shreyaspatel3010/aries/assets/terrain-source/IMG_20250616_193405.png

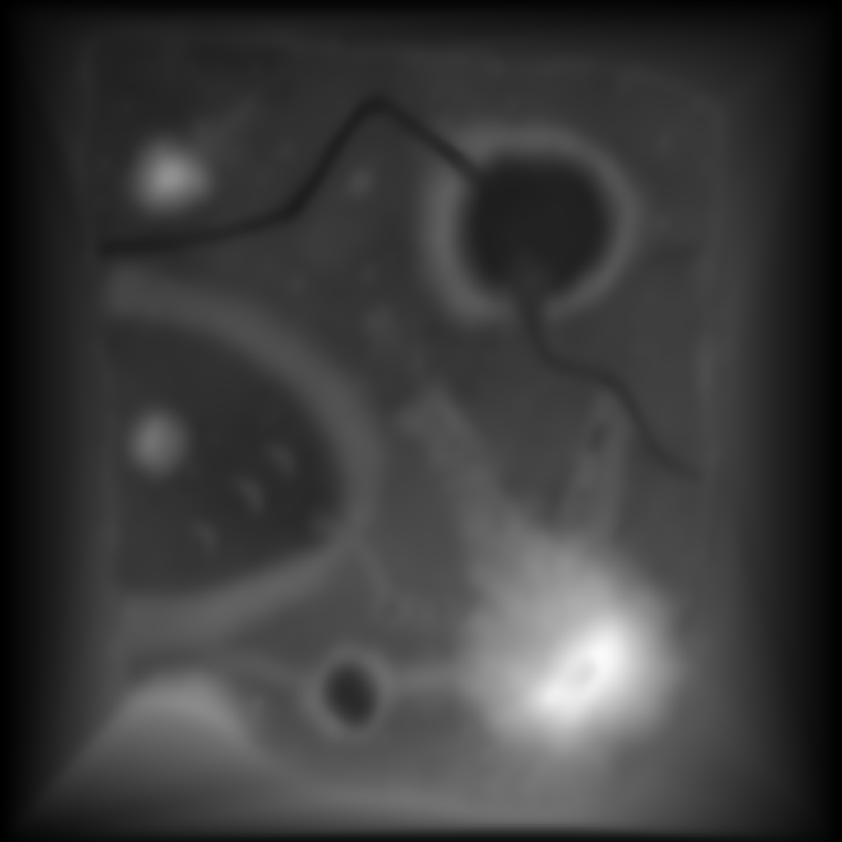
assets/terrain-source/IMG_20250616_193405.png
