shreyaspatel3010/aries/WhatsApp Image 2026-08-18 at 4.04.01 PM.jpeg

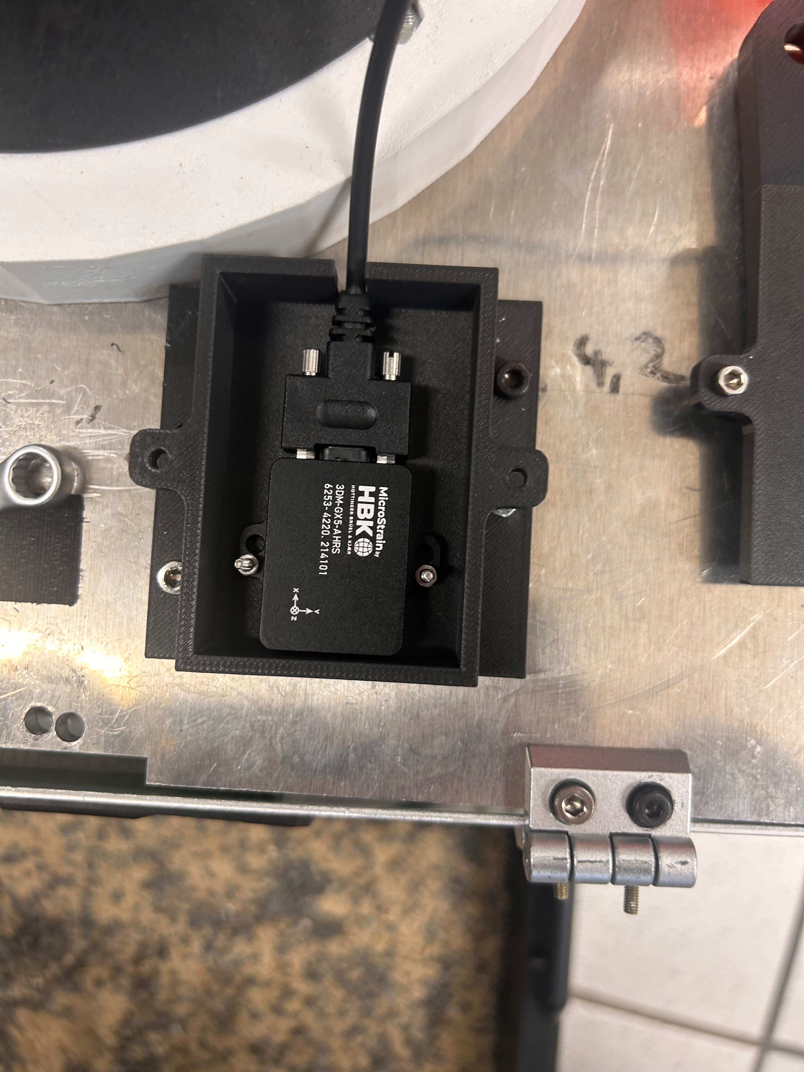
WhatsApp Image 2026-08-18 at 4.04.01 PM.jpeg
