shreyaspatel3010/aries/src/rover_nav/README.md

# rover_nav

ROS 2 navigation and drive-control package for the rover.

> **New machine setup and bringup instructions are in the [`rover_bringup`](../rover_bringup/README.md) package.**

---

## Package structure

```
rover_nav/
├── config/
│   └── ekf_config.yaml                  # EKF localisation config
├── launch/
│   └── LeapOne_Safety_launch.py
├── msg/                                 # Custom ROS 2 message definitions
├── scripts/
│   ├── Rover_control_Joy.py             # Joystick teleop control node
│   ├── Odom.py                          # Odometry node
│   ├── rover_controller_pure_pursuit.py # Pure-pursuit path controller
│   └── setup_can_sudo.sh                # One-time passwordless CAN sudoers setup
└── package.xml
```

---

## Dependencies

- ODrive ROS 2 driver
- `rover_bringup` — provides `joystick_config.yaml` read by `Rover_control_Joy.py`
