shreyaspatel3010/aries/assets/terrain-source/MarsYard_CoordSys.png

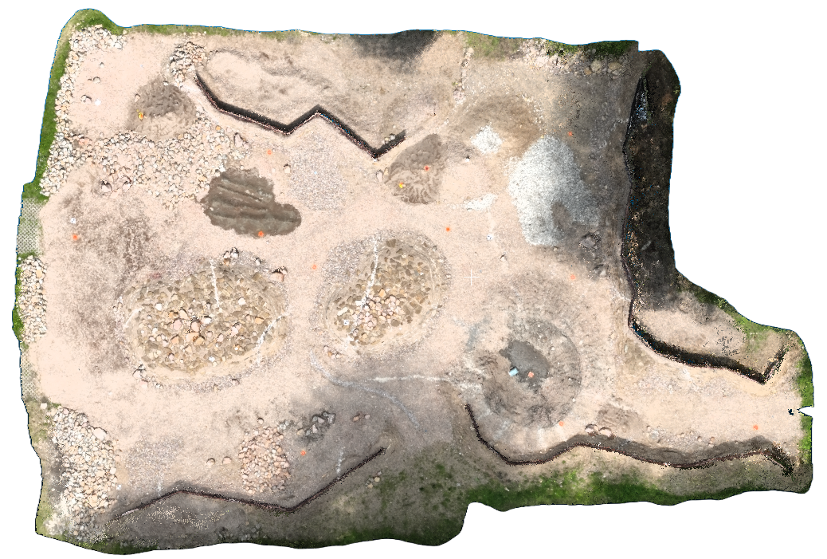
assets/terrain-source/MarsYard_CoordSys.png
