shreyaspatel3010/aries/controller.webp

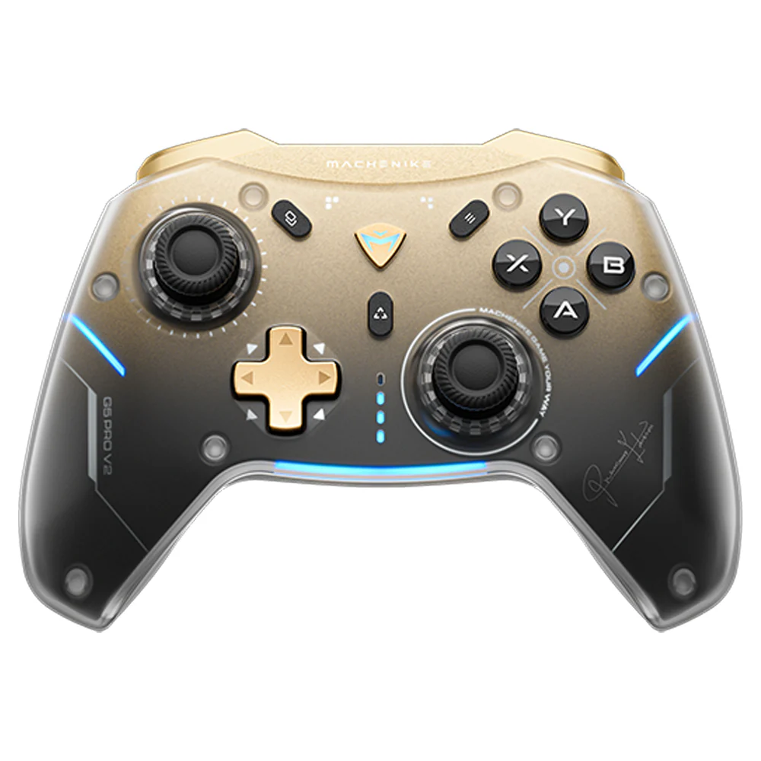
controller.webp
