shreyaspatel3010/aries/src/aries/models/dem/marsyard2026_terrain_hm.png

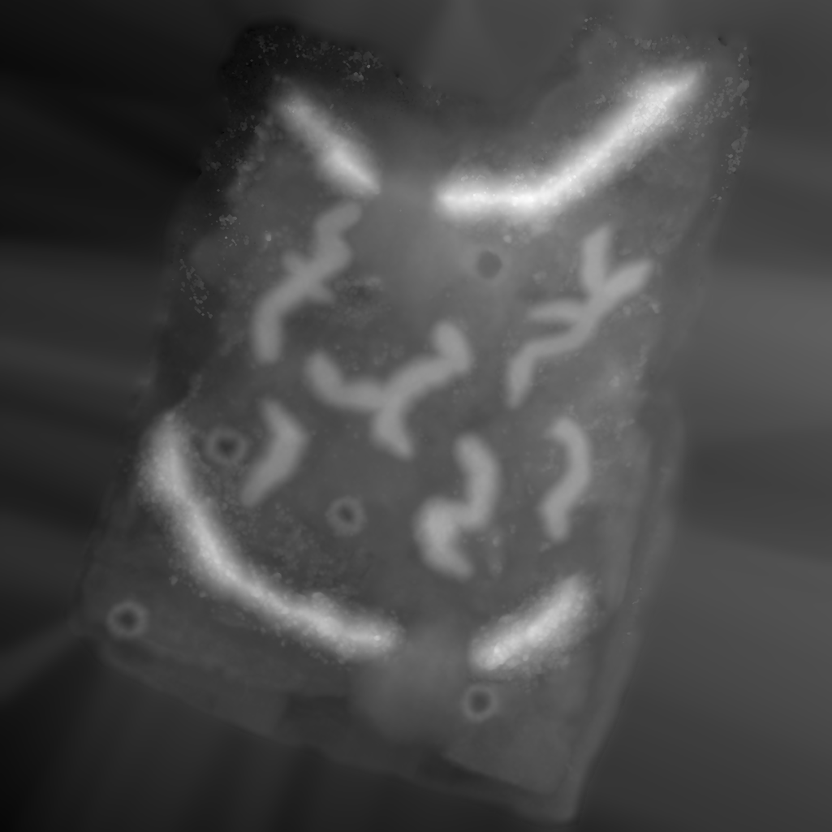
src/aries/models/dem/marsyard2026_terrain_hm.png
