shreyaspatel3010/aries/src/aries/models/marsyard2026/aruco_orig_102.png

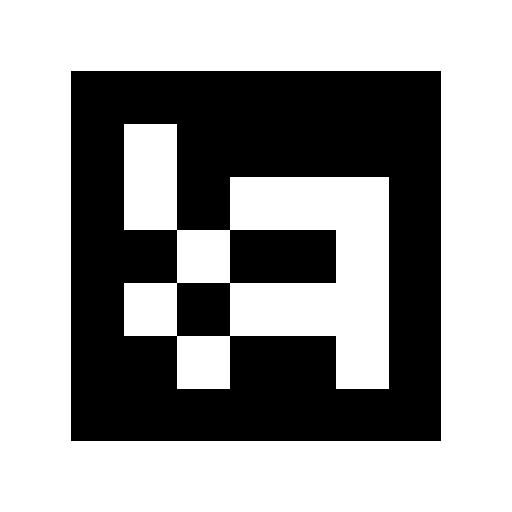
src/aries/models/marsyard2026/aruco_orig_102.png
