shreyaspatel3010/aries/src/aries/models/marsyard2026/drone_cage_floor.png

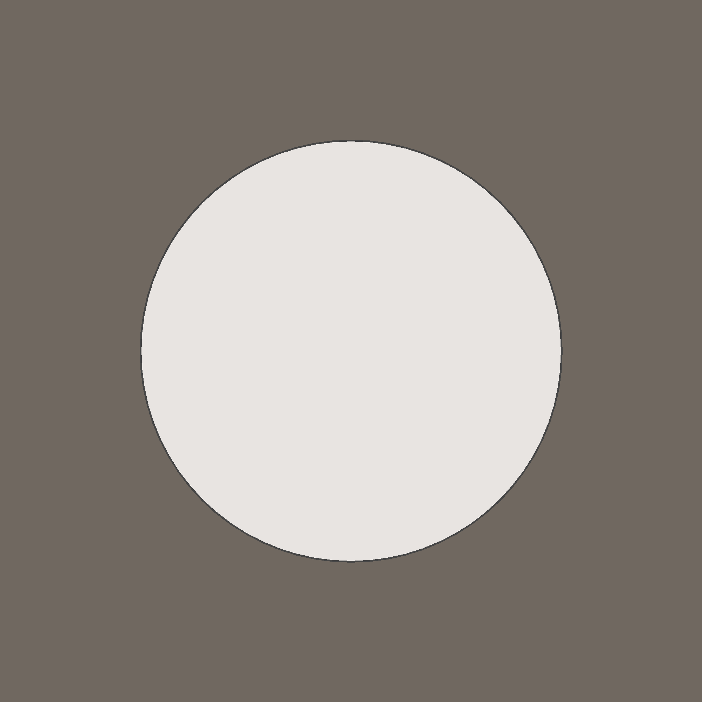
src/aries/models/marsyard2026/drone_cage_floor.png
