shreyaspatel3010/aries/src/aries/models/marsyard2026/landmark_L7.png

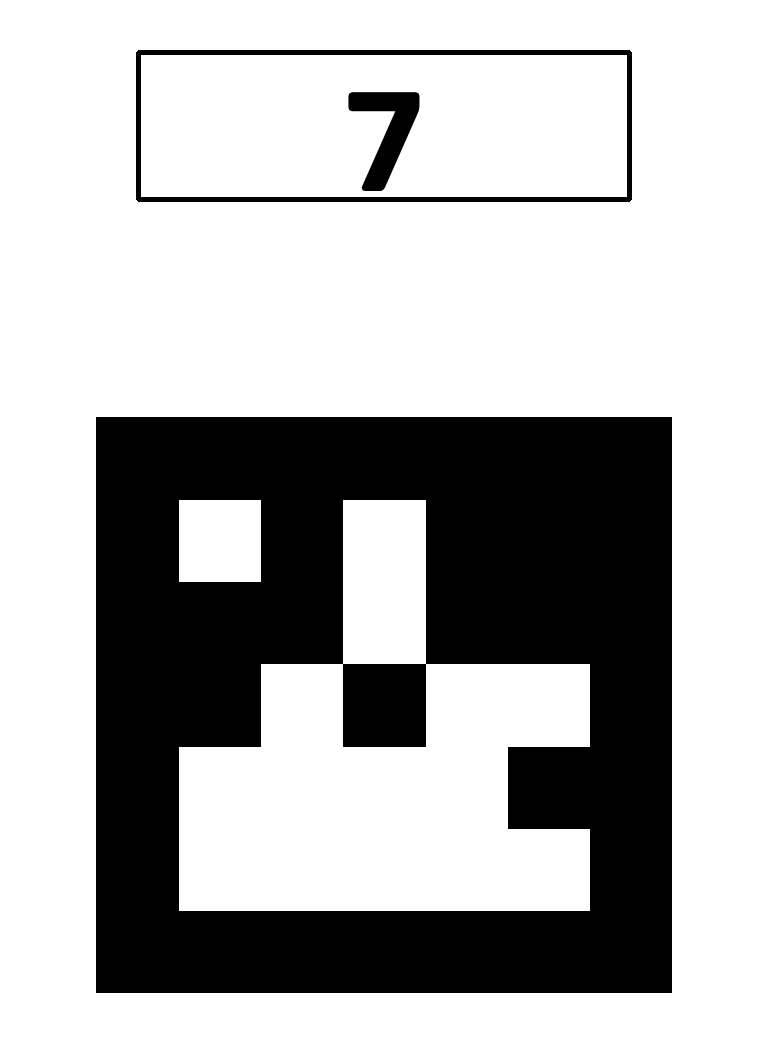
src/aries/models/marsyard2026/landmark_L7.png
