shreyaspatel3010/aries/Maintenance Gripper Finger L.stl

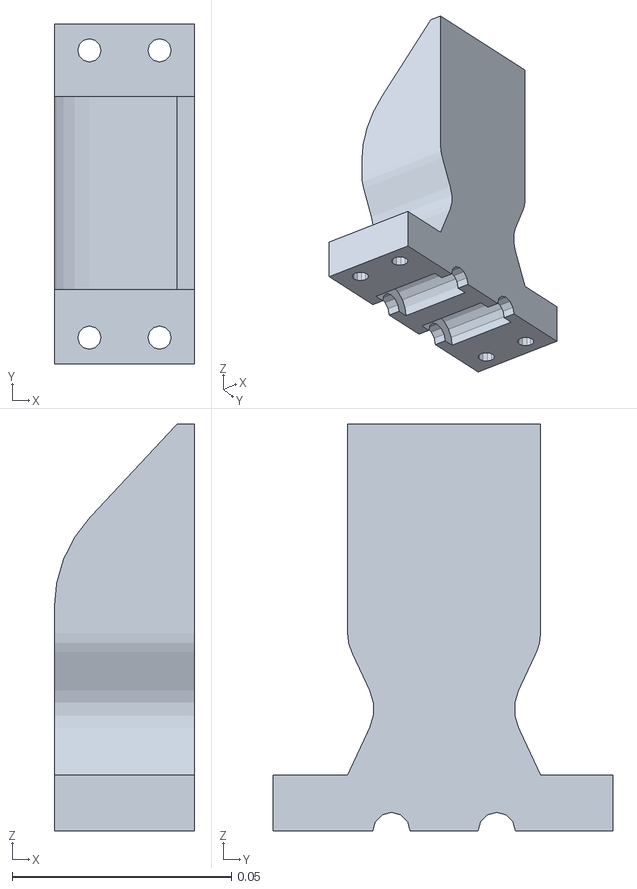
[picture p28: CAD file, 2026-08-31]
Maintenance Gripper Finger L.stl
0.032 x 0.0775 x 0.0928
