shreyaspatel3010/aries/src/aries/meshes/gripper_v2/gripper_maintenance_left.stl

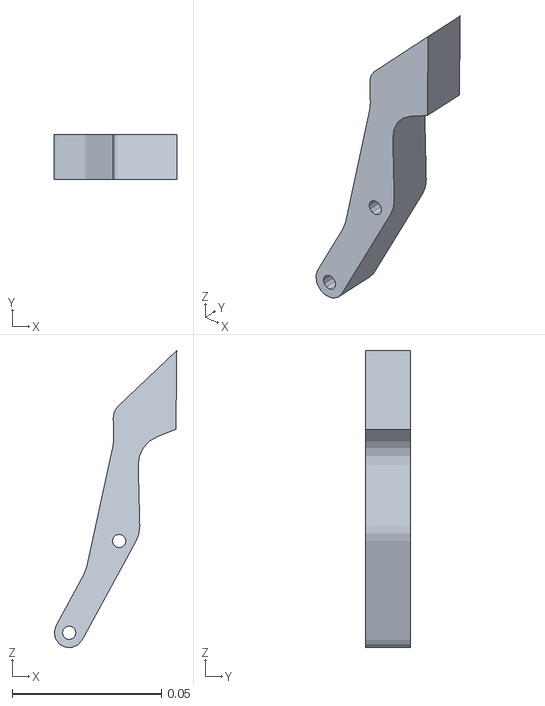
[picture p29: CAD file, 2026-08-11]
src/aries/meshes/gripper_v2/gripper_maintenance_left.stl
0.041 x 0.015 x 0.0994
