shreyaspatel3010/aries/assets/mesh-alternatives/robolink_rebel2/simplified_link5.stl

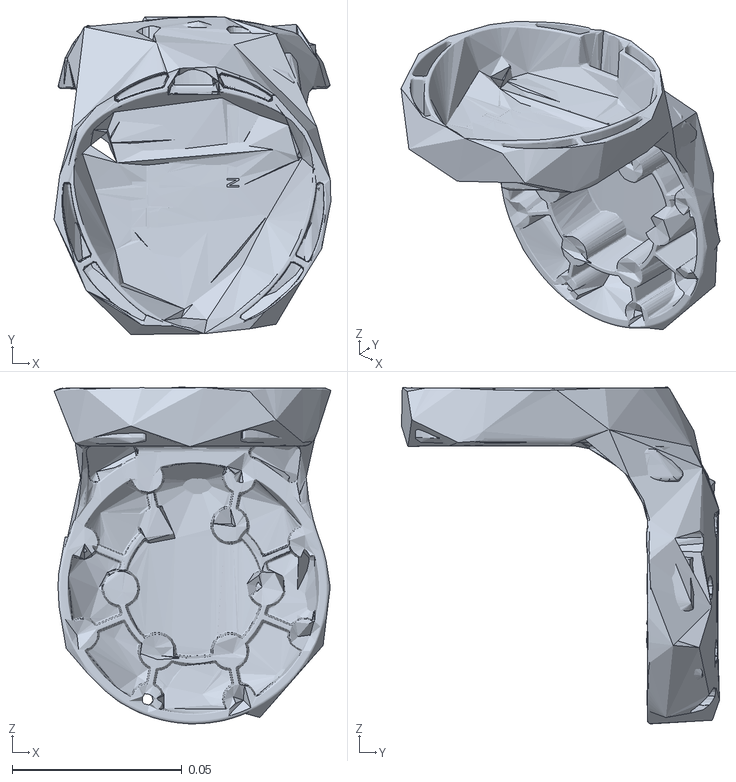
[picture p30: CAD file, 2026-07-12]
assets/mesh-alternatives/robolink_rebel2/simplified_link5.stl
0.0816 x 0.0938 x 0.0993
