shreyaspatel3010/aries/new_mesh/bucket gripper 2.3MF

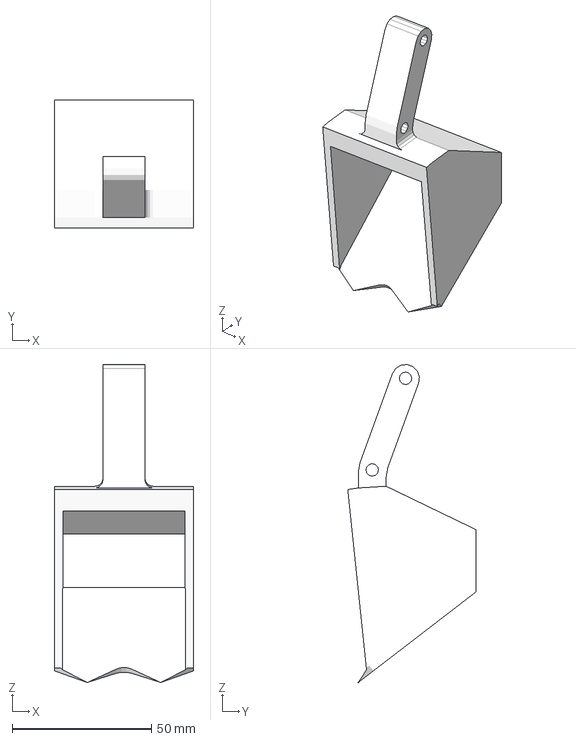
[picture p31: CAD file, 2026-08-20]
new_mesh/bucket gripper 2.3MF
50.0 x 46.1 x 114.2 mm
