shreyaspatel3010/aries/src/aries/meshes/drill_body.stl

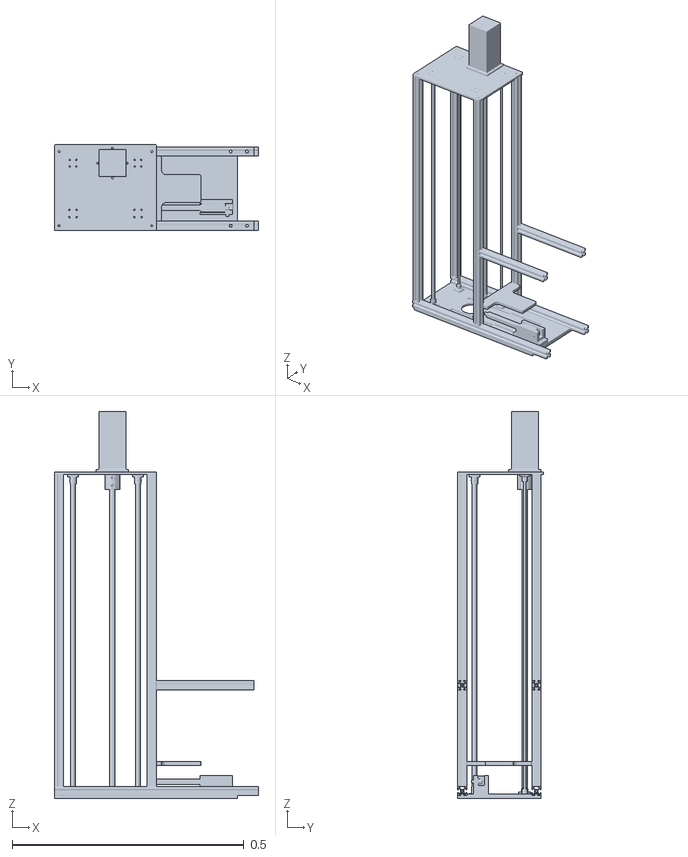
[picture p32: CAD file, 2026-08-20]
src/aries/meshes/drill_body.stl
0.44 x 0.185 x 0.835
