shreyaspatel3010/aries/src/aries/meshes/gripper_v2/gripper_bucket_right.stl

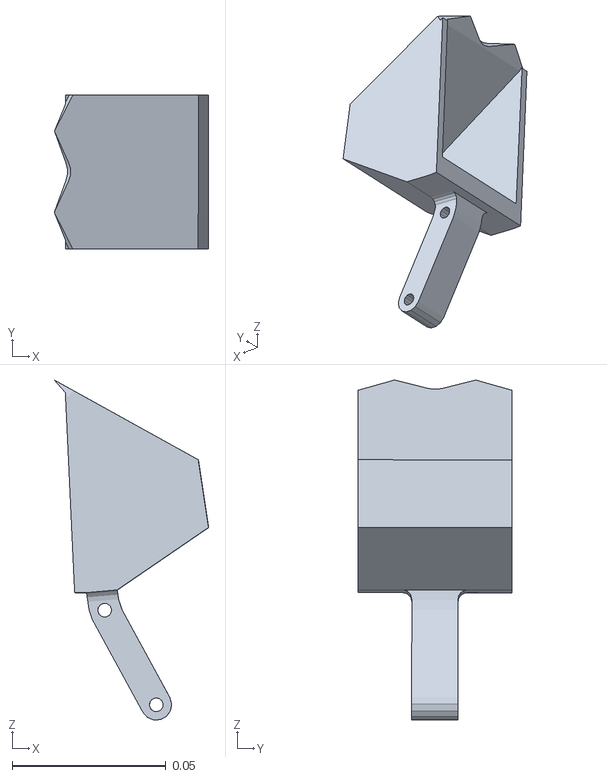
[picture p33: CAD file, 2026-08-20]
src/aries/meshes/gripper_v2/gripper_bucket_right.stl
0.0502 x 0.0501 x 0.11
