shreyaspatel3010/aries/src/aries/meshes/robolink_rebel2/motor1.stl

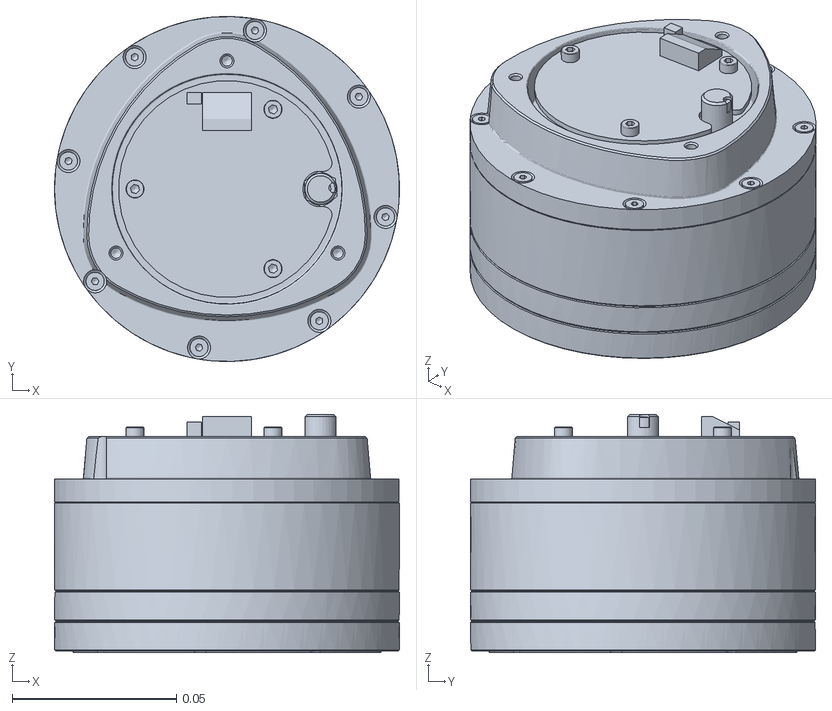
[picture p34: CAD file, 2026-07-12]
src/aries/meshes/robolink_rebel2/motor1.stl
0.105 x 0.105 x 0.0726
