shreyaspatel3010/aries/src/aries/models/maintenance_panel/parts/disconnect.stl

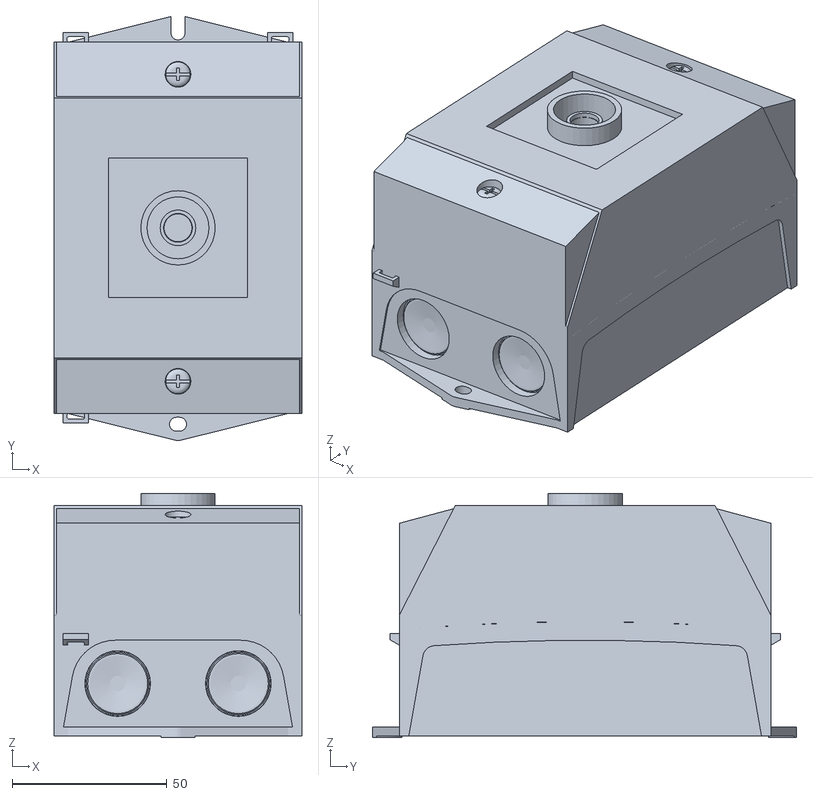
[picture p35: CAD file, 2026-08-17]
src/aries/models/maintenance_panel/parts/disconnect.stl
80.0 x 137.0 x 79.0
