shreyaspatel3010/aries/src/aries/models/probe.stl

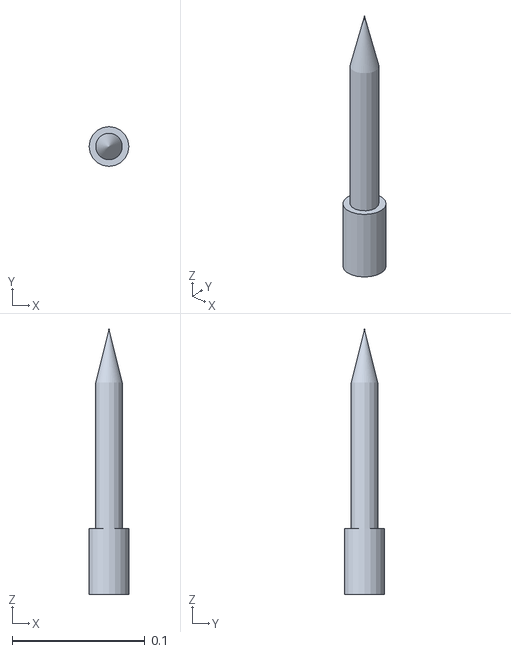
[picture p36: CAD file, 2026-07-20]
src/aries/models/probe.stl
0.03 x 0.03 x 0.2
