shreyaspatel3010/aries/assets/mesh-alternatives/robolink_rebel2/simplified_motor5.stl

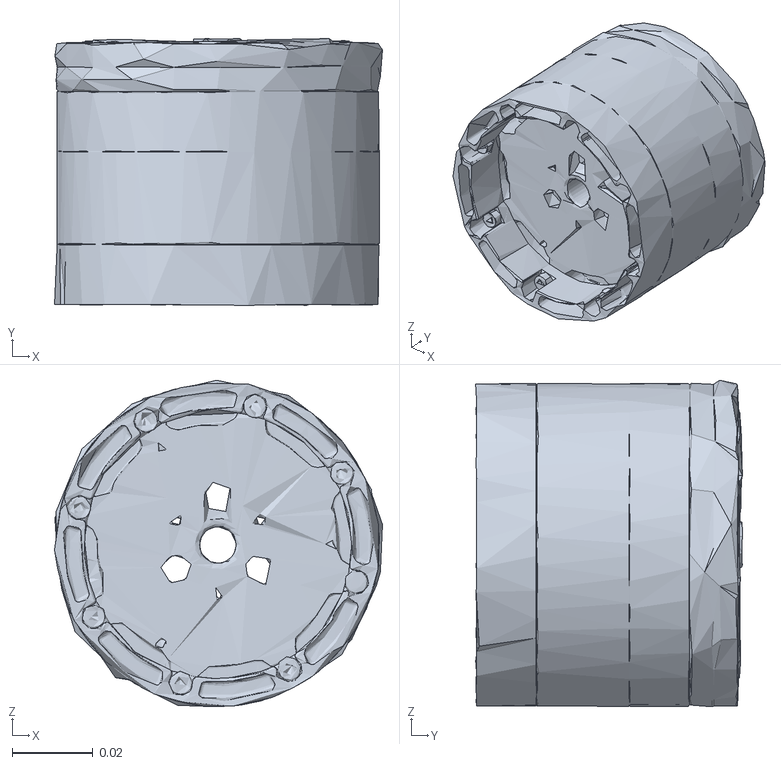
[picture p37: CAD file, 2026-07-12]
assets/mesh-alternatives/robolink_rebel2/simplified_motor5.stl
0.0813 x 0.0662 x 0.0809
