shreyaspatel3010/aries/src/aries/meshes/drill_motor.stl

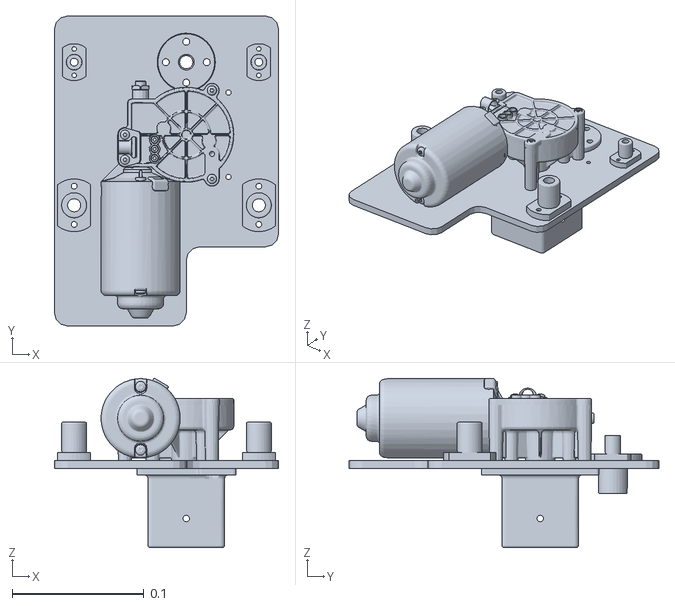
[picture p38: CAD file, 2026-08-20]
src/aries/meshes/drill_motor.stl
0.17 x 0.235 x 0.128
