shreyaspatel3010/aries/src/aries/meshes/robolink_rebel2/link6.stl

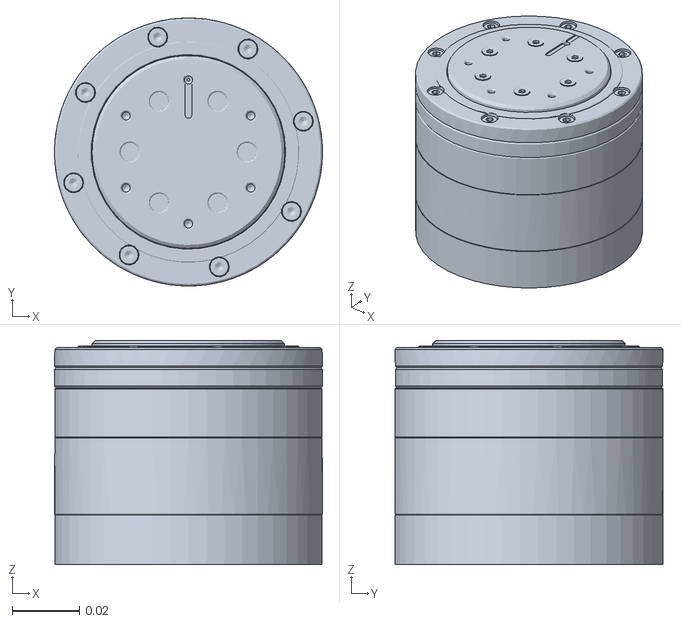
[picture p39: CAD file, 2026-07-12]
src/aries/meshes/robolink_rebel2/link6.stl
0.08 x 0.08 x 0.067
