shreyaspatel3010/aries/src/aries/models/maintenance_panel/parts/mcb_block4.stl

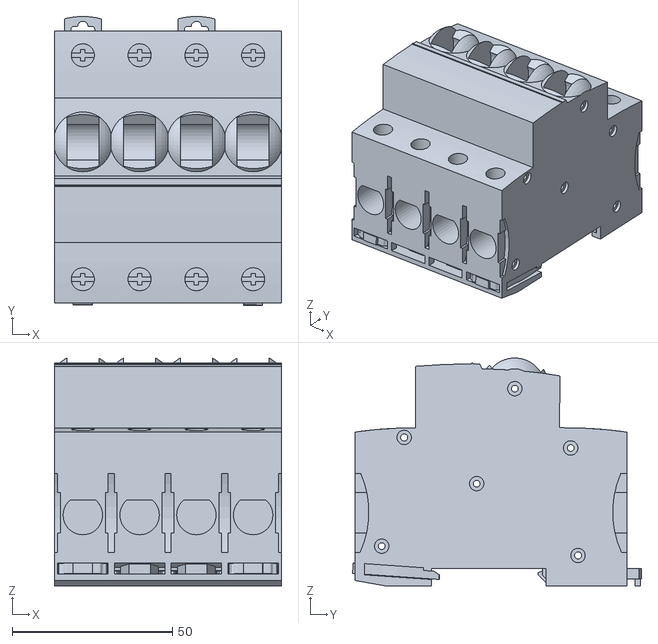
[picture p40: CAD file, 2026-08-17]
src/aries/models/maintenance_panel/parts/mcb_block4.stl
70.8 x 90.1 x 71.1
