shreyaspatel3010/aries/assets/mesh-alternatives/robolink_rebel2/simplified_link3.stl

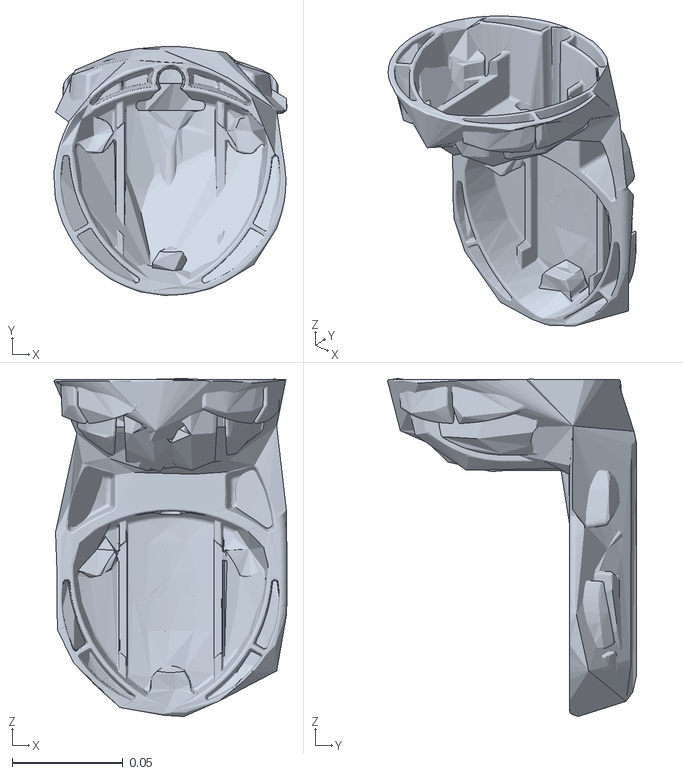
[picture p41: CAD file, 2026-07-12]
assets/mesh-alternatives/robolink_rebel2/simplified_link3.stl
0.105 x 0.112 x 0.152
