shreyaspatel3010/aries/new_mesh/gripper_bucket_2.stl

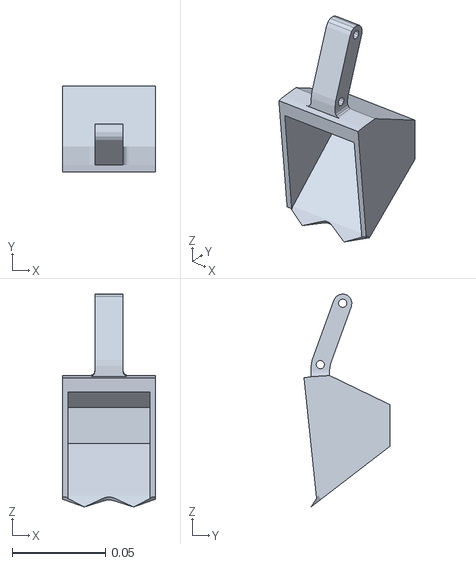
[picture p42: CAD file, 2026-08-20]
new_mesh/gripper_bucket_2.stl
0.05 x 0.0461 x 0.114
