shreyaspatel3010/aries/src/aries/meshes/drill_container.stl

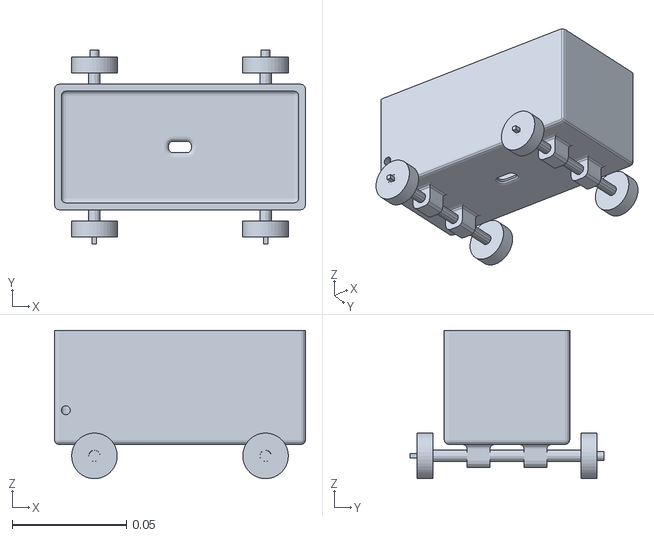
[picture p43: CAD file, 2026-08-20]
src/aries/meshes/drill_container.stl
0.11 x 0.085 x 0.065
