shreyaspatel3010/aries/src/aries/meshes/gripper_st3215/st3215_bucket_right.stl

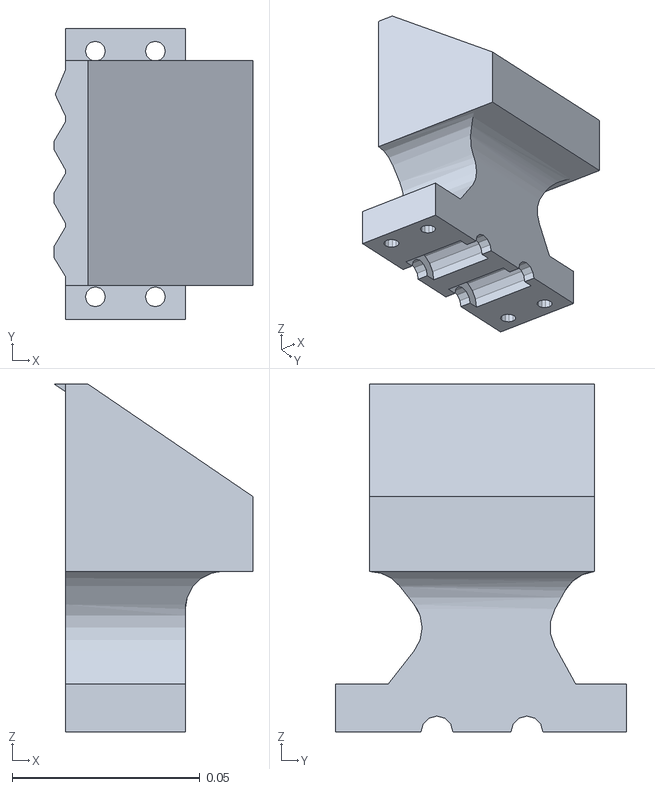
[picture p44: CAD file, 2026-08-29]
src/aries/meshes/gripper_st3215/st3215_bucket_right.stl
0.053 x 0.0775 x 0.0928
