shreyaspatel3010/aries/src/aries/meshes/gripper_v2/gripper_coupler_right.stl

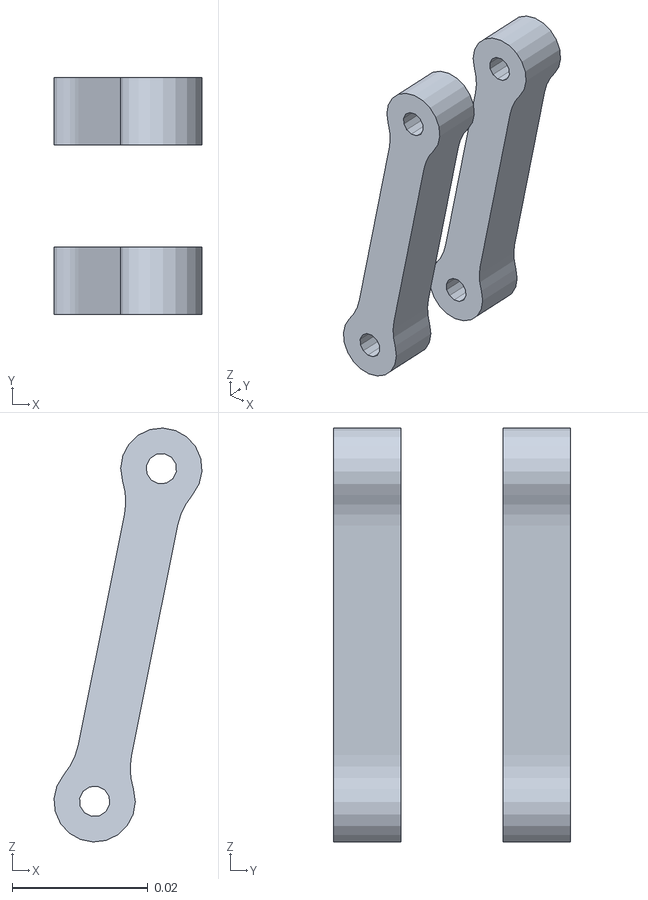
[picture p45: CAD file, 2026-08-11]
src/aries/meshes/gripper_v2/gripper_coupler_right.stl
0.0218 x 0.035 x 0.061
