shreyaspatel3010/aries/src/aries/models/maintenance_panel/parts/iec_inlet.stl

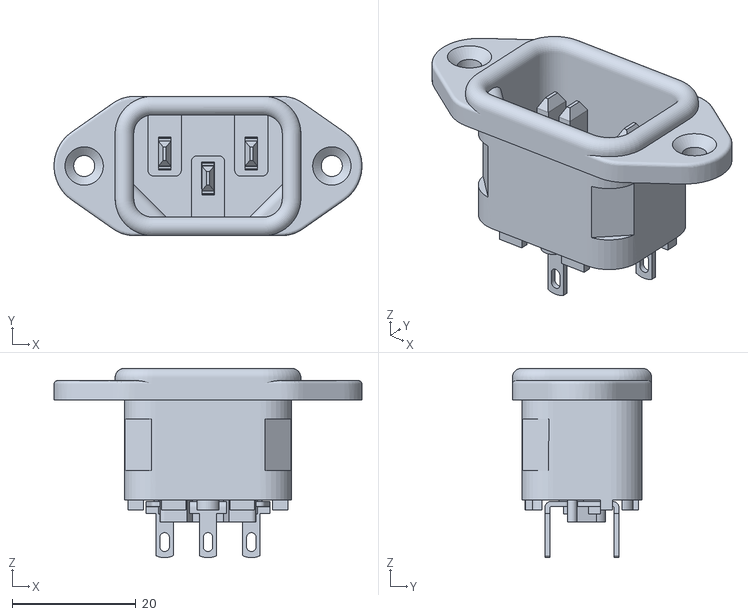
[picture p46: CAD file, 2026-08-17]
src/aries/models/maintenance_panel/parts/iec_inlet.stl
49.8 x 22.5 x 30.6
