shreyaspatel3010/aries/assets/mesh-alternatives/robolink_rebel2/simplified_link6.stl

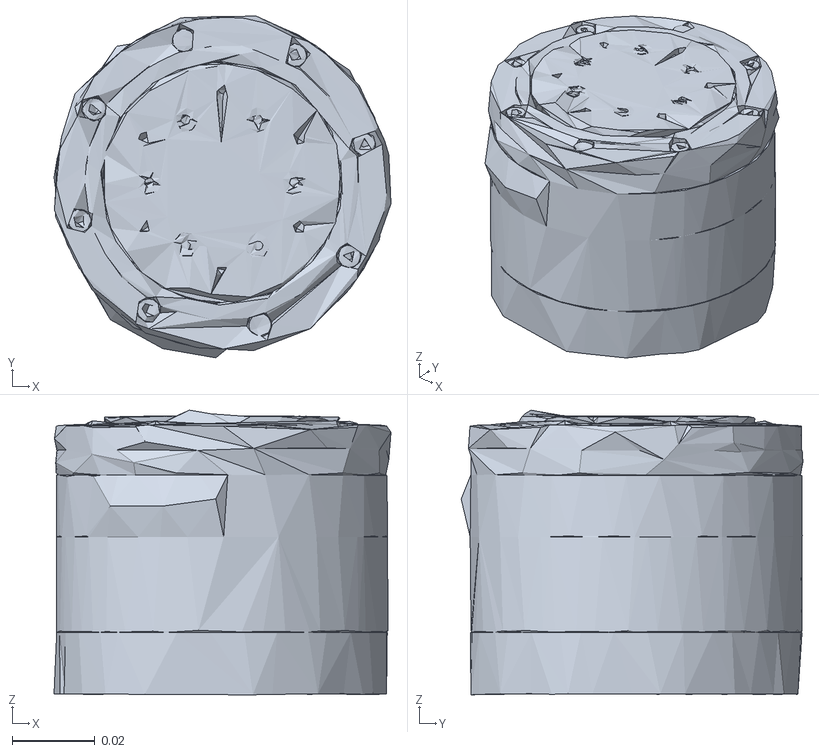
[picture p47: CAD file, 2026-07-12]
assets/mesh-alternatives/robolink_rebel2/simplified_link6.stl
0.0813 x 0.0824 x 0.0687
