shreyaspatel3010/aries/src/aries/meshes/drill.stl

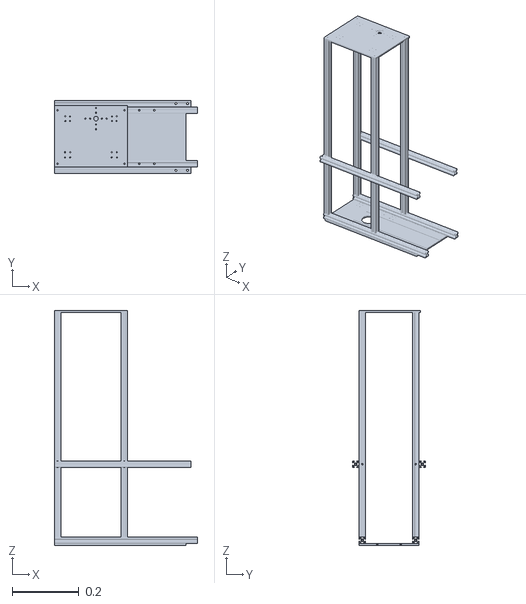
[picture p48: CAD file, 2026-08-20]
src/aries/meshes/drill.stl
0.43 x 0.22 x 0.704
