shreyaspatel3010/aries/src/aries/meshes/gripper_v2/gripper_gear_right.stl

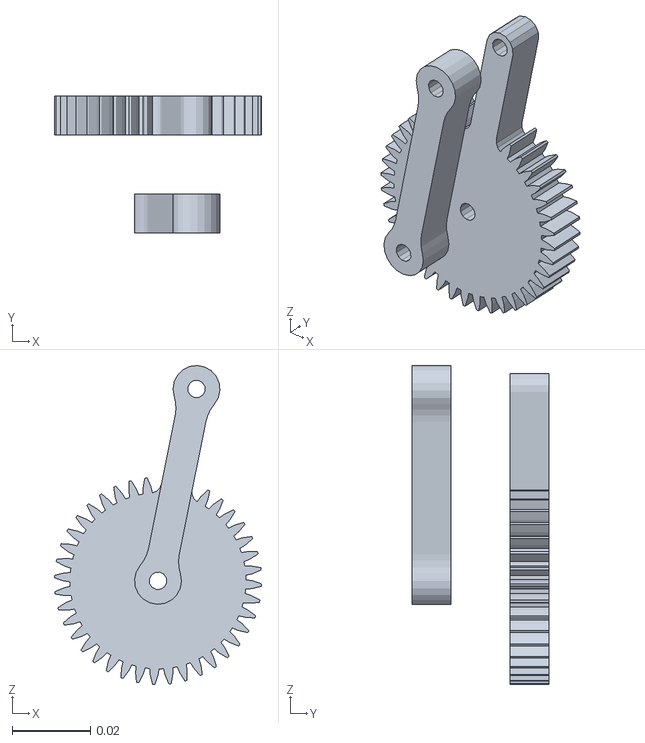
[picture p50: CAD file, 2026-08-11]
src/aries/meshes/gripper_v2/gripper_gear_right.stl
0.053 x 0.035 x 0.0815
