shreyaspatel3010/aries/src/aries/meshes/robolink_rebel2/link4.stl

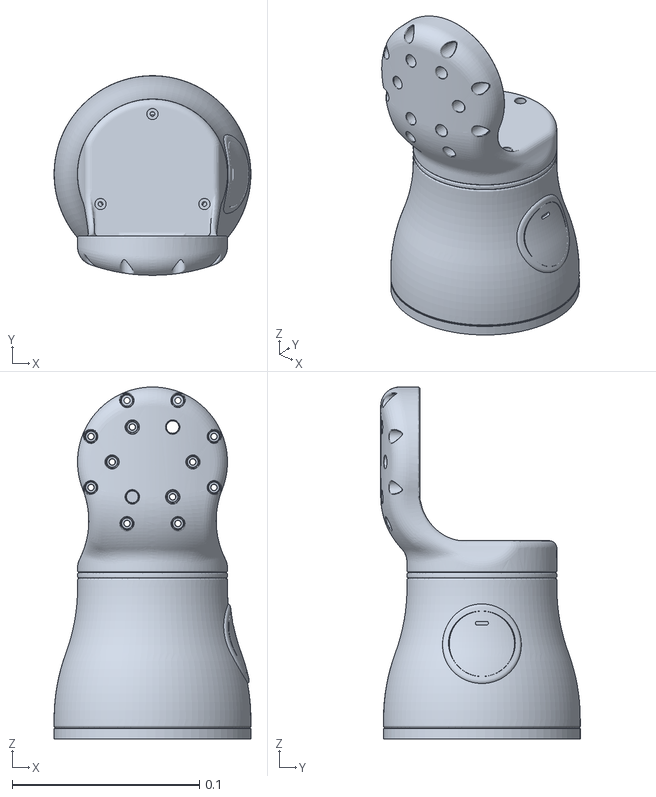
[picture p51: CAD file, 2026-07-12]
src/aries/meshes/robolink_rebel2/link4.stl
0.105 x 0.106 x 0.188
