shreyaspatel3010/aries/src/aries/models/maintenance_panel/parts/cam_switch.stl

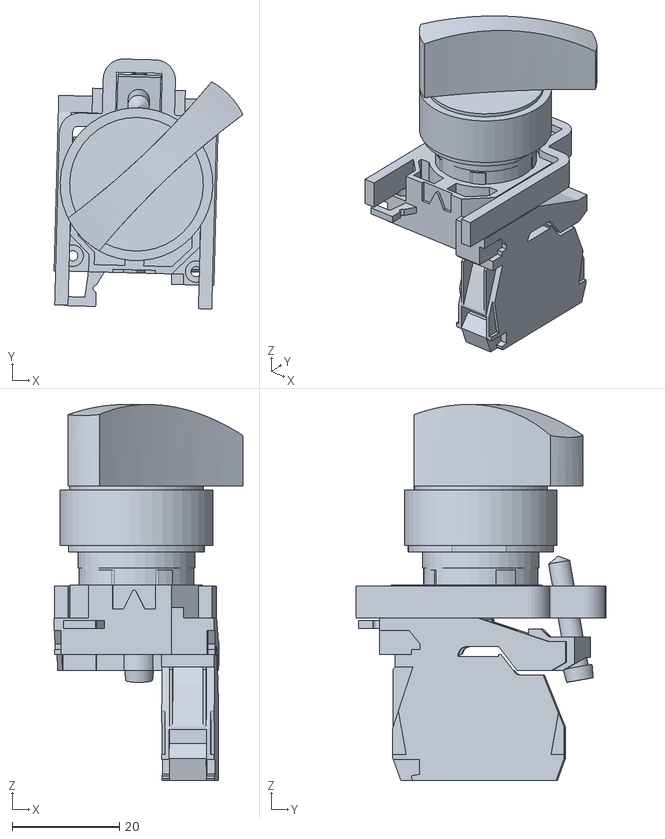
[picture p52: CAD file, 2026-08-17]
src/aries/models/maintenance_panel/parts/cam_switch.stl
35.2 x 46.7 x 70.2
