shreyaspatel3010/aries/src/aries/meshes/gripper_st3215/st3215_pinion.stl

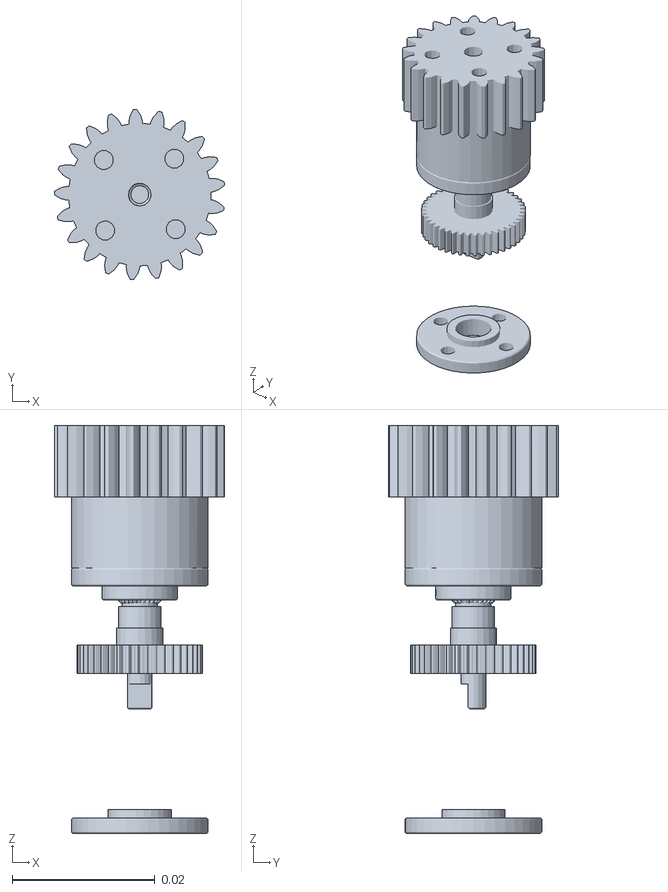
[picture p54: CAD file, 2026-08-29]
src/aries/meshes/gripper_st3215/st3215_pinion.stl
0.0239 x 0.0239 x 0.0573
