shreyaspatel3010/aries/src/aries/meshes/gripper_v2/gripper_probe_right.stl

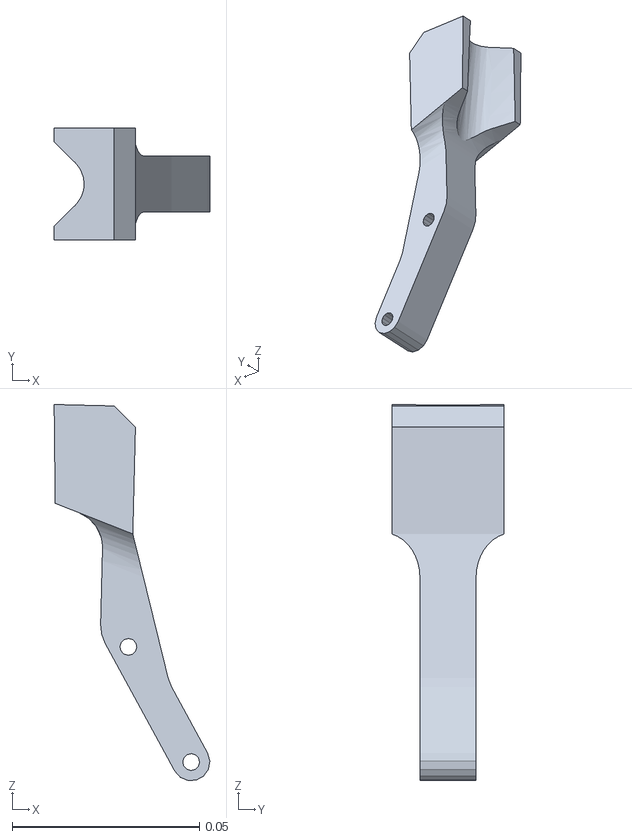
[picture p55: CAD file, 2026-08-11]
src/aries/meshes/gripper_v2/gripper_probe_right.stl
0.0416 x 0.03 x 0.1
