shreyaspatel3010/aries/src/aries/meshes/R_2_Wheel_Link_v2.stl

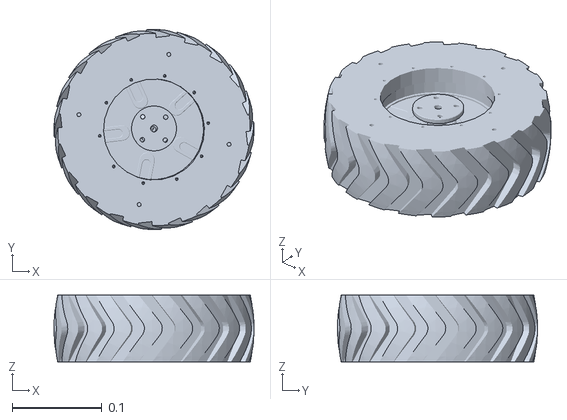
[picture p56: CAD file, 2026-07-16]
src/aries/meshes/R_2_Wheel_Link_v2.stl
0.222 x 0.222 x 0.074
