shreyaspatel3010/aries/src/aries/meshes/robolink_rebel2/base_link.stl

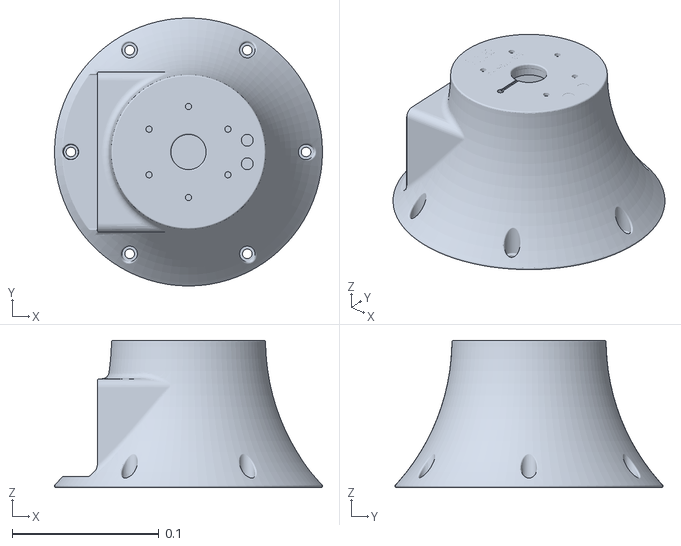
[picture p57: CAD file, 2026-07-12]
src/aries/meshes/robolink_rebel2/base_link.stl
0.182 x 0.182 x 0.1
