shreyaspatel3010/aries/src/aries/models/maintenance_panel/parts/mcb_block4_handle.stl

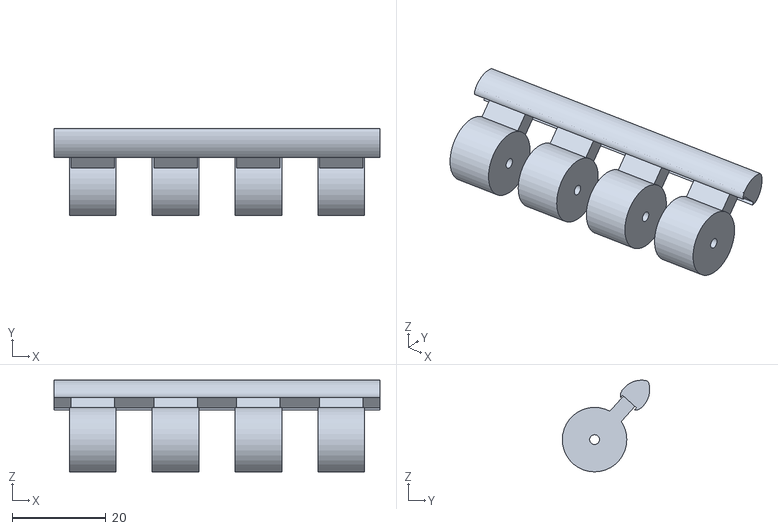
[picture p58: CAD file, 2026-08-17]
src/aries/models/maintenance_panel/parts/mcb_block4_handle.stl
69.7 x 18.7 x 19.6
