shreyaspatel3010/aries/assets/mesh-alternatives/robolink_rebel2/simplified_motor2.stl

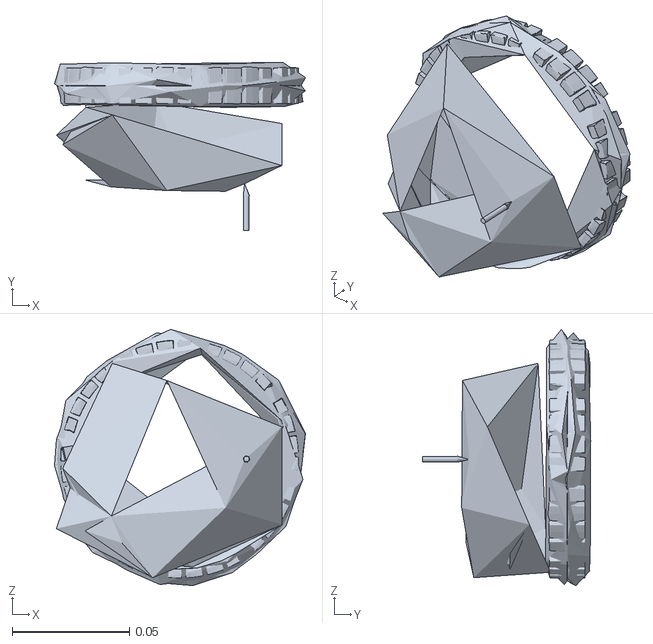
[picture p59: CAD file, 2026-07-12]
assets/mesh-alternatives/robolink_rebel2/simplified_motor2.stl
0.107 x 0.0719 x 0.109
