shreyaspatel3010/aries/src/aries/meshes/gripper_st3215/st3215_base.stl

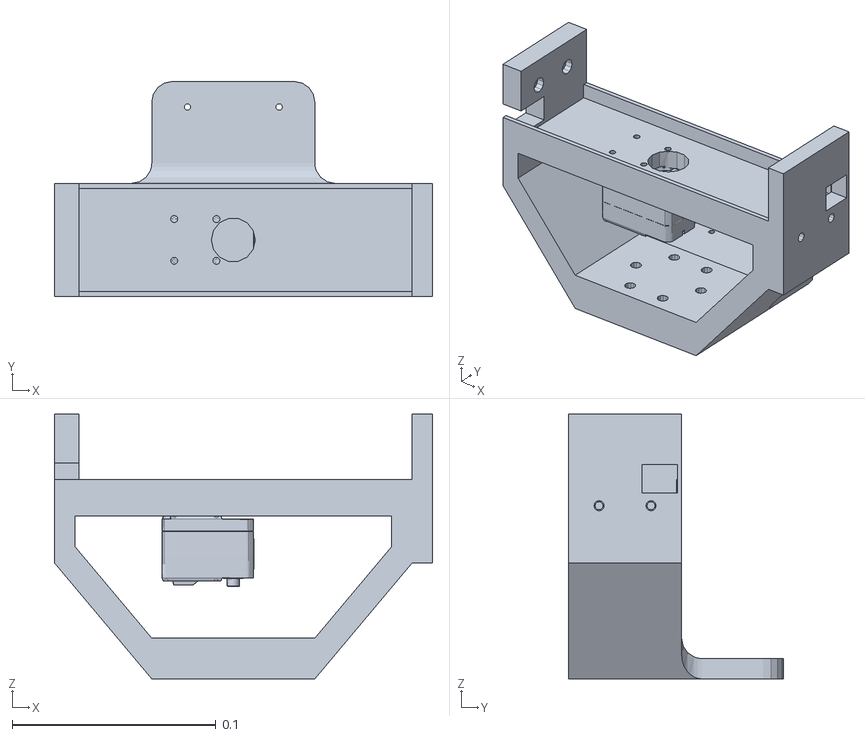
[picture p60: CAD file, 2026-08-29]
src/aries/meshes/gripper_st3215/st3215_base.stl
0.186 x 0.106 x 0.13
