shreyaspatel3010/aries/src/aries/meshes/L_1_Wheel_Link_v2.stl

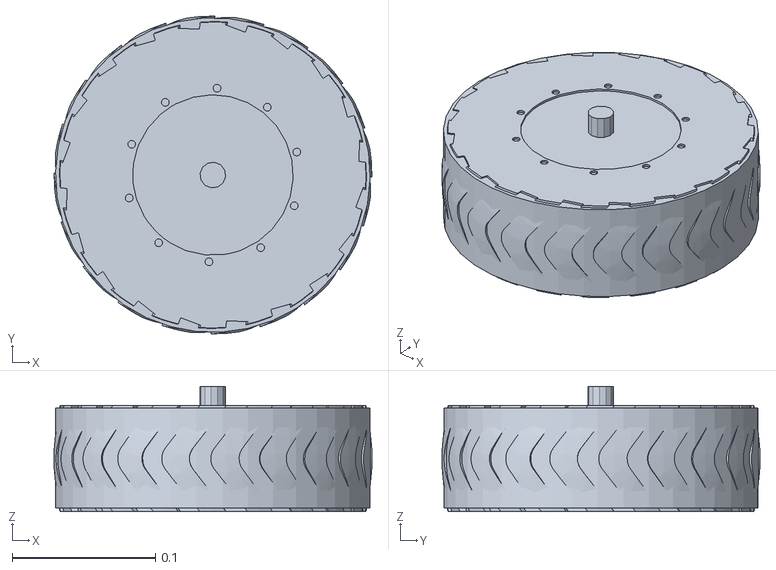
[picture p61: CAD file, 2026-07-16]
src/aries/meshes/L_1_Wheel_Link_v2.stl
0.222 x 0.222 x 0.0875
