shreyaspatel3010/aries/src/aries/meshes/robolink_rebel2/motor5.stl

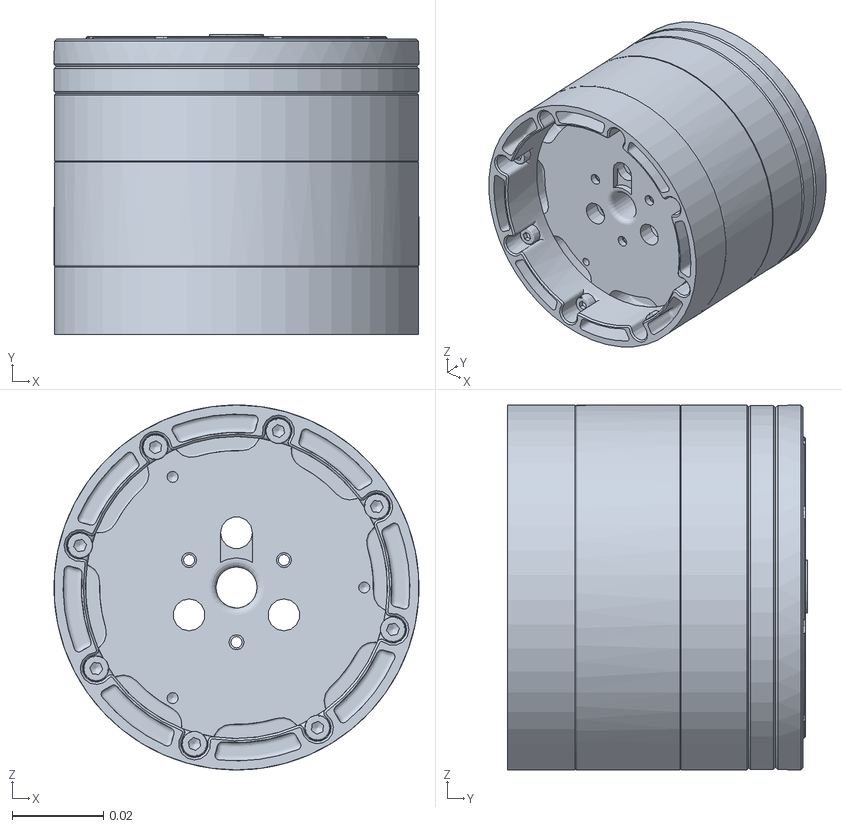
[picture p62: CAD file, 2026-07-12]
src/aries/meshes/robolink_rebel2/motor5.stl
0.08 x 0.0658 x 0.08
