shreyaspatel3010/aries/src/aries/models/maintenance_panel/parts/disconnect_bezel.stl

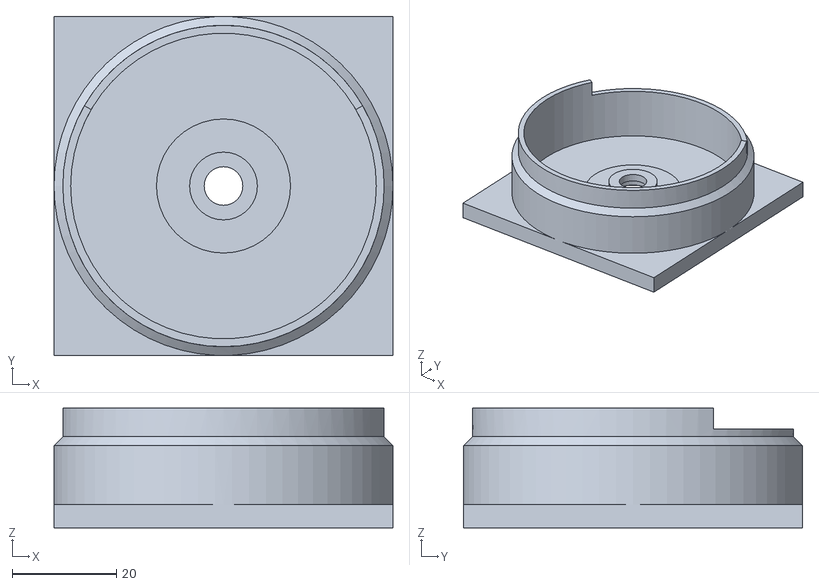
[picture p63: CAD file, 2026-08-17]
src/aries/models/maintenance_panel/parts/disconnect_bezel.stl
65.0 x 65.0 x 23.0
