shreyaspatel3010/aries/assets/mesh-alternatives/robolink_rebel2/simplified_link4.stl

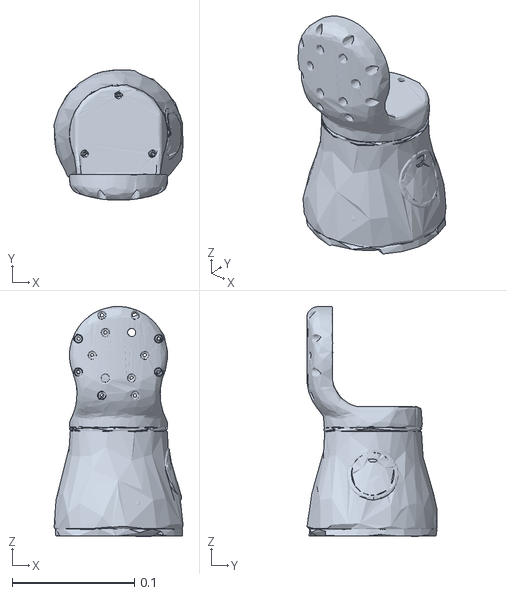
[picture p64: CAD file, 2026-07-12]
assets/mesh-alternatives/robolink_rebel2/simplified_link4.stl
0.105 x 0.107 x 0.188
