shreyaspatel3010/aries/src/aries/meshes/robolink_rebel2/link3.stl

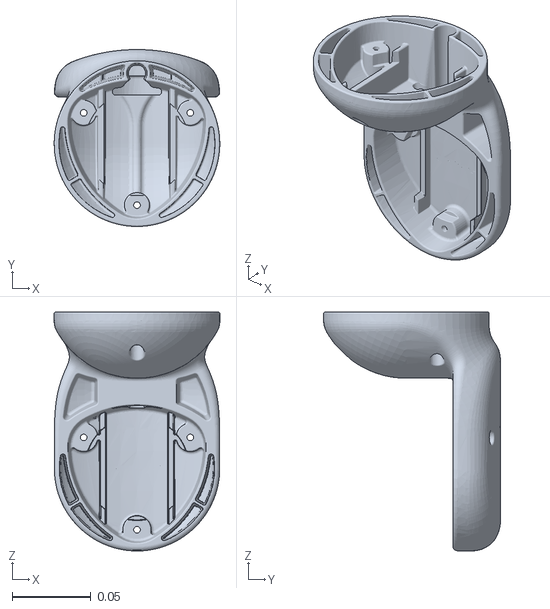
[picture p65: CAD file, 2026-07-12]
src/aries/meshes/robolink_rebel2/link3.stl
0.105 x 0.112 x 0.151
