shreyaspatel3010/aries/src/aries/models/maintenance_panel/parts/mcb_single_handle.stl

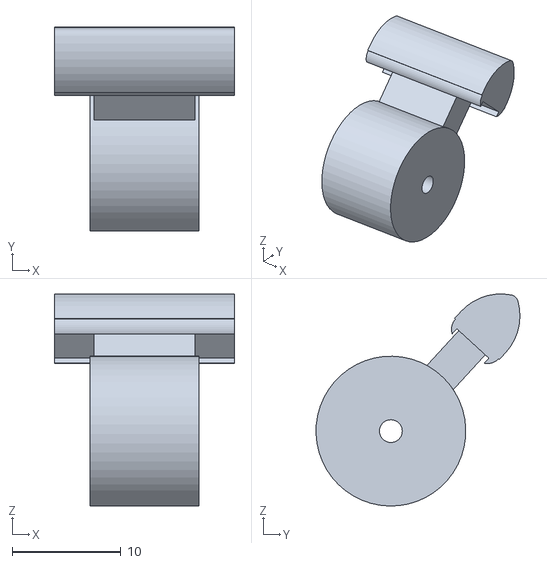
[picture p66: CAD file, 2026-08-17]
src/aries/models/maintenance_panel/parts/mcb_single_handle.stl
16.6 x 18.8 x 19.5
