shreyaspatel3010/aries/assets/mesh-alternatives/robolink_rebel2/simplified_base_link.stl

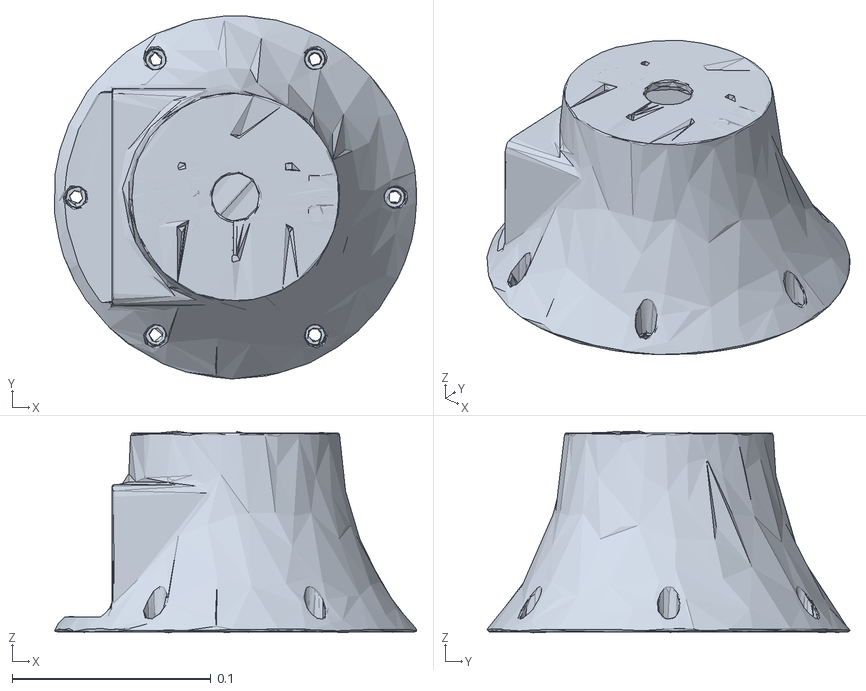
[picture p67: CAD file, 2026-07-12]
assets/mesh-alternatives/robolink_rebel2/simplified_base_link.stl
0.182 x 0.183 x 0.101
