shreyaspatel3010/aries/src/aries/meshes/gripper_st3215/st3215_bucket_left.stl

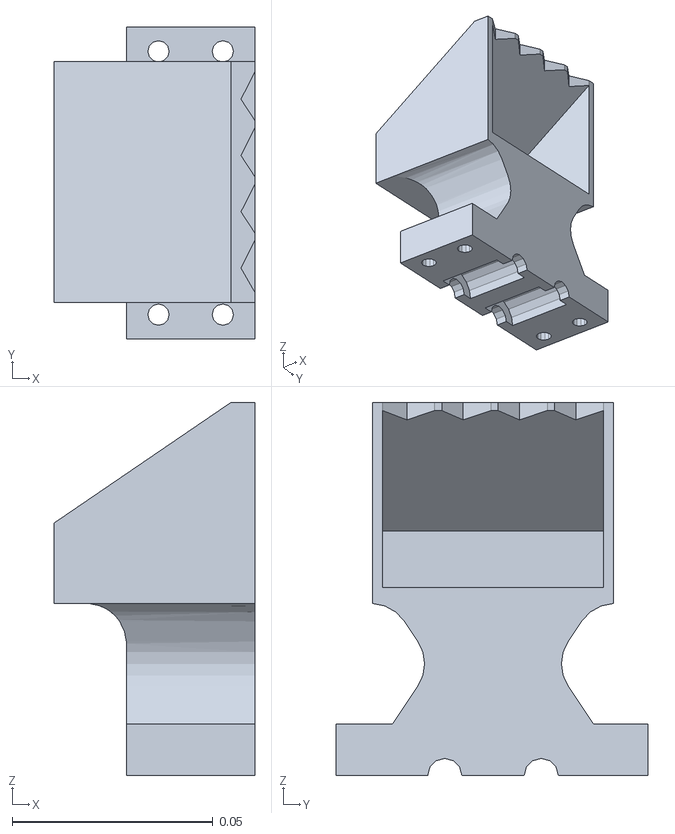
[picture p68: CAD file, 2026-08-29]
src/aries/meshes/gripper_st3215/st3215_bucket_left.stl
0.05 x 0.0775 x 0.0928
