shreyaspatel3010/aries/src/aries/models/maintenance_panel/parts/disconnect_handle.stl

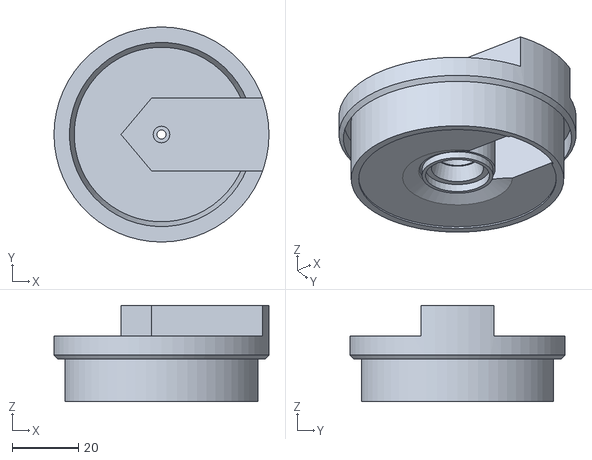
[picture p69: CAD file, 2026-08-17]
src/aries/models/maintenance_panel/parts/disconnect_handle.stl
64.8 x 64.8 x 29.0
