shreyaspatel3010/aries/assets/mesh-alternatives/robolink_rebel2/simplified_link2.stl

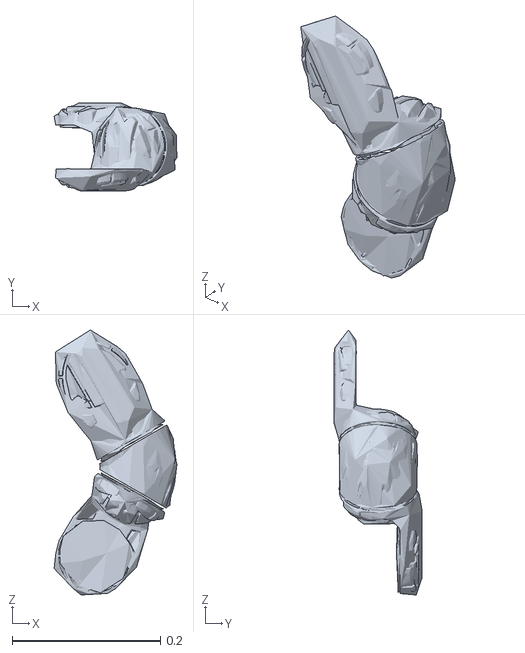
[picture p70: CAD file, 2026-07-12]
assets/mesh-alternatives/robolink_rebel2/simplified_link2.stl
0.166 x 0.119 x 0.358
