shreyaspatel3010/aries/src/aries/meshes/robolink_rebel2/link5.stl

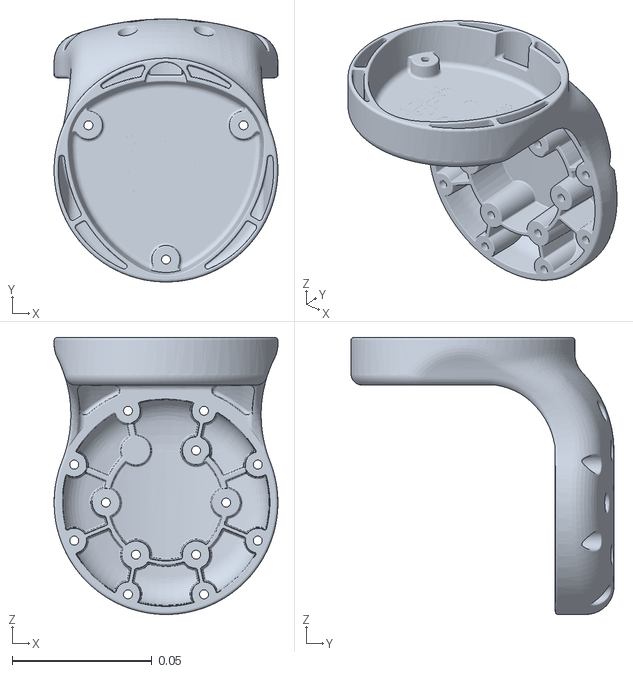
[picture p71: CAD file, 2026-07-12]
src/aries/meshes/robolink_rebel2/link5.stl
0.08 x 0.094 x 0.099
