shreyaspatel3010/aries/src/aries/models/maintenance_panel/parts/mcb_single.stl

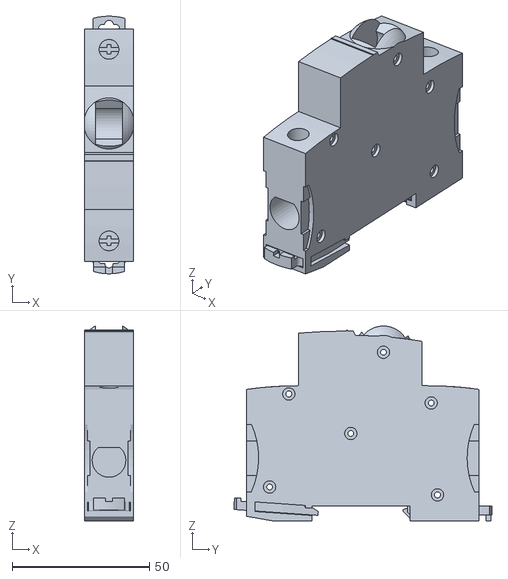
[picture p72: CAD file, 2026-08-17]
src/aries/models/maintenance_panel/parts/mcb_single.stl
17.7 x 93.9 x 71.1
