shreyaspatel3010/aries/assets/mesh-alternatives/robolink_rebel2/simplified_motor4.stl

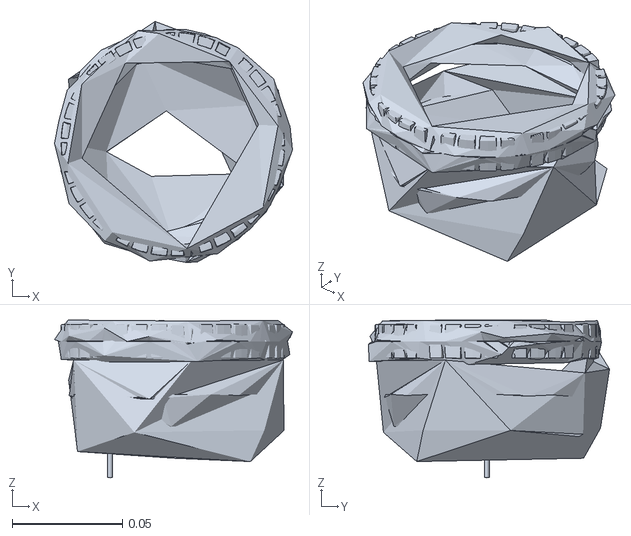
[picture p73: CAD file, 2026-07-12]
assets/mesh-alternatives/robolink_rebel2/simplified_motor4.stl
0.108 x 0.109 x 0.0716
