shreyaspatel3010/aries/src/aries/meshes/d435.stl

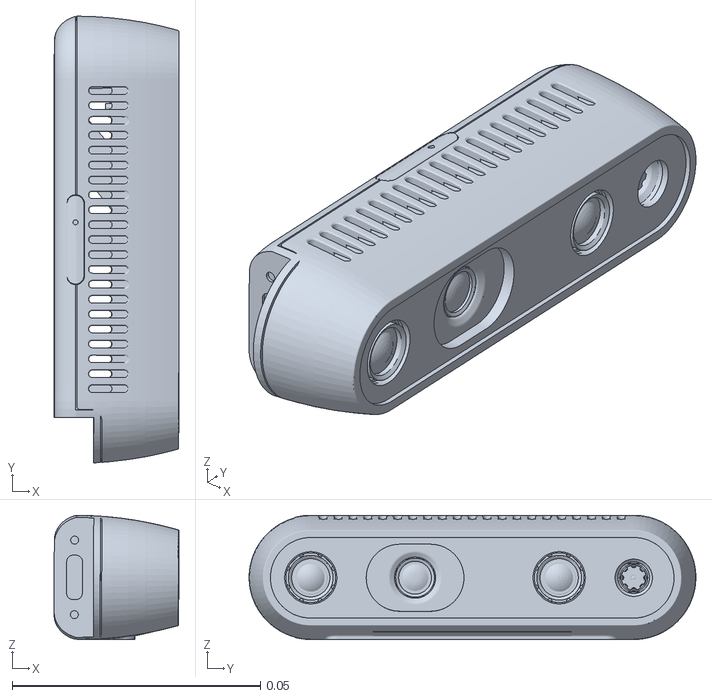
[picture p74: CAD file, 2026-07-16]
src/aries/meshes/d435.stl
0.0252 x 0.0899 x 0.025
