shreyaspatel3010/aries/src/aries/meshes/gripper_v2/gripper_base.stl

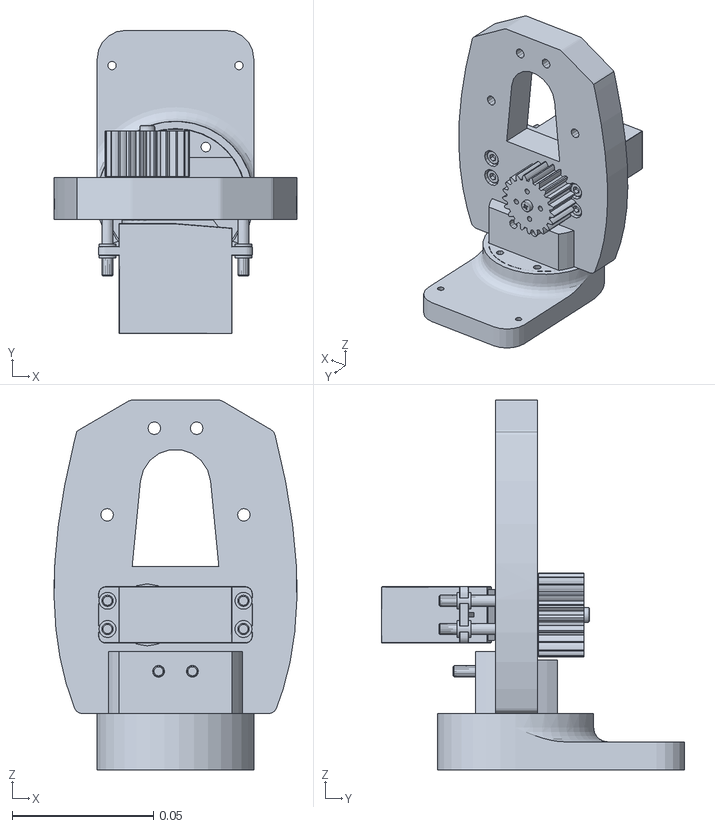
[picture p75: CAD file, 2026-08-11]
src/aries/meshes/gripper_v2/gripper_base.stl
0.0861 x 0.108 x 0.131
