shreyaspatel3010/aries/assets/mesh-alternatives/robolink_rebel2/simplified_link1.stl

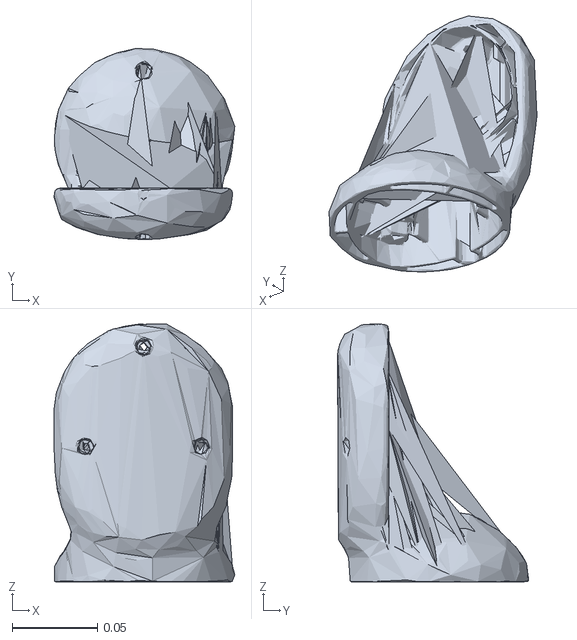
[picture p76: CAD file, 2026-07-12]
assets/mesh-alternatives/robolink_rebel2/simplified_link1.stl
0.106 x 0.112 x 0.152
