shreyaspatel3010/aries/src/aries/meshes/picoscan_150.stl

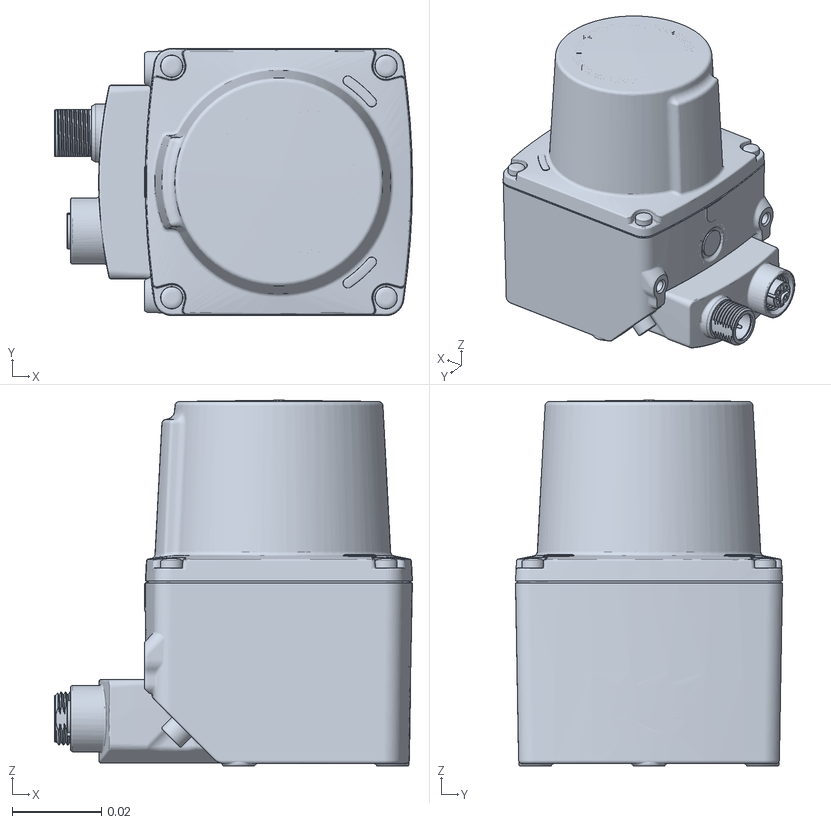
[picture p77: CAD file, 2026-07-15]
src/aries/meshes/picoscan_150.stl
0.0804 x 0.06 x 0.0821
