shreyaspatel3010/aries/src/aries/meshes/L_Boggie_Link.STL

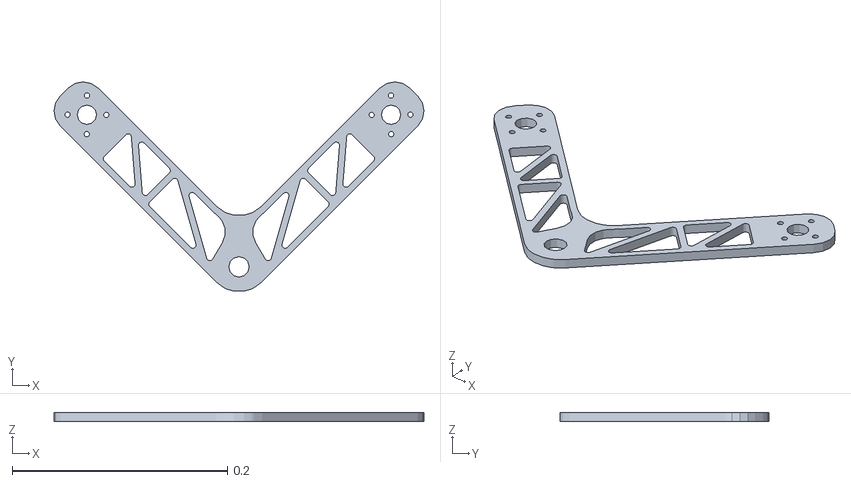
[picture p78: CAD file, 2026-07-12]
src/aries/meshes/L_Boggie_Link.STL
0.344 x 0.195 x 0.008
