shreyaspatel3010/aries/src/aries/meshes/left_bogie.stl

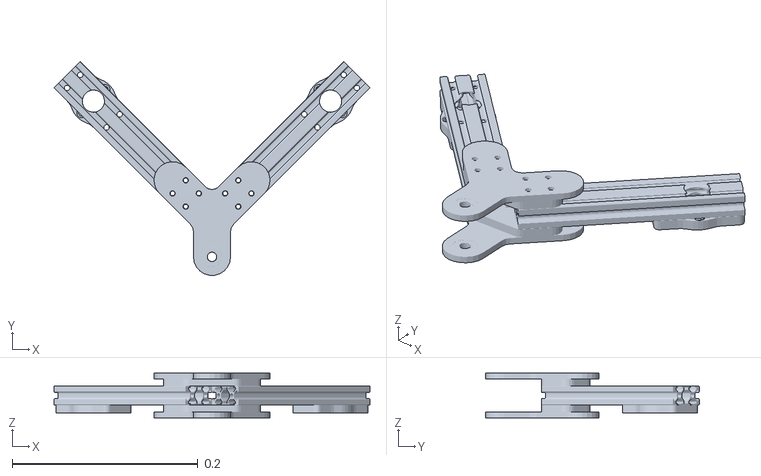
[picture p79: CAD file, 2026-07-12]
src/aries/meshes/left_bogie.stl
0.34 x 0.23 x 0.048
