shreyaspatel3010/aries/src/aries/meshes/left_rocker.stl

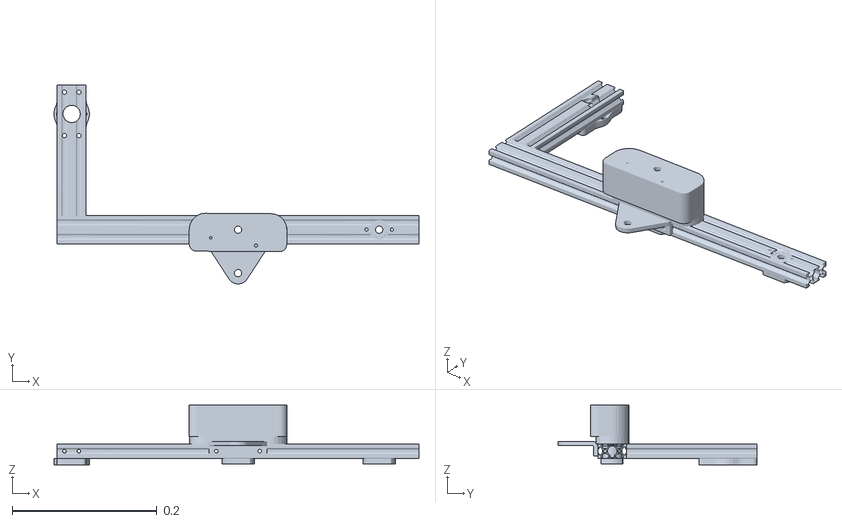
[picture p80: CAD file, 2026-07-12]
src/aries/meshes/left_rocker.stl
0.504 x 0.275 x 0.0825
