shreyaspatel3010/aries/src/aries/meshes/Lidar_Link.STL

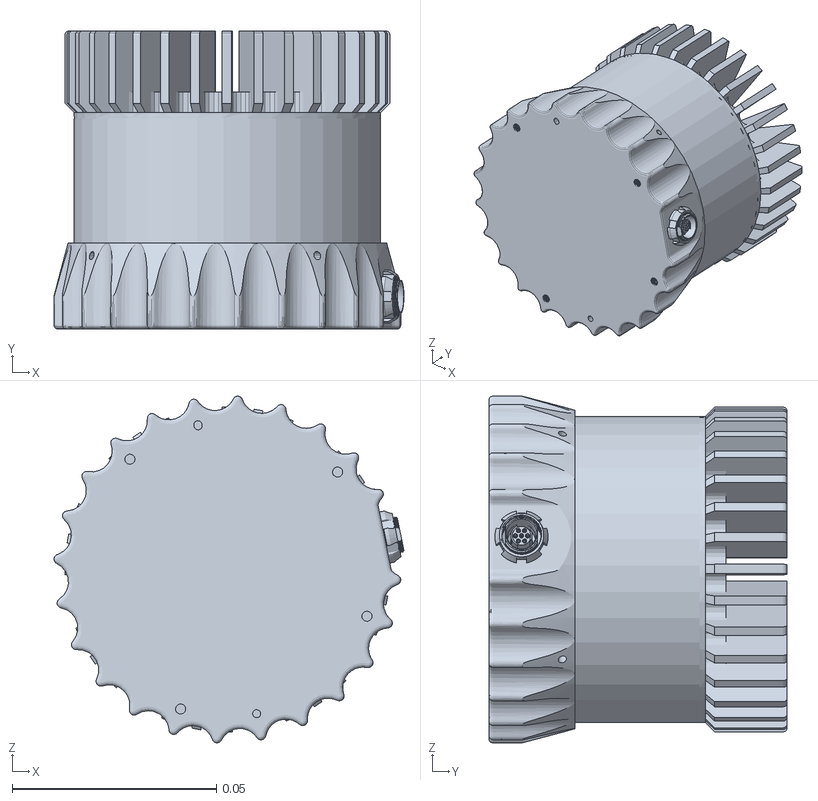
[picture p81: CAD file, 2026-07-12]
src/aries/meshes/Lidar_Link.STL
0.0856 x 0.073 x 0.0848
