shreyaspatel3010/aries/src/aries/meshes/R_Boggie_Link.STL

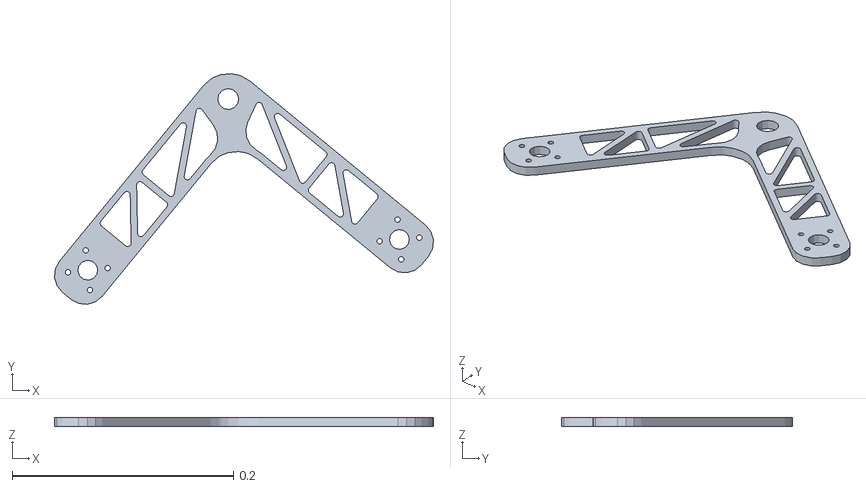
[picture p82: CAD file, 2026-07-12]
src/aries/meshes/R_Boggie_Link.STL
0.342 x 0.208 x 0.008
