shreyaspatel3010/aries/src/aries/meshes/gripper_left.stl

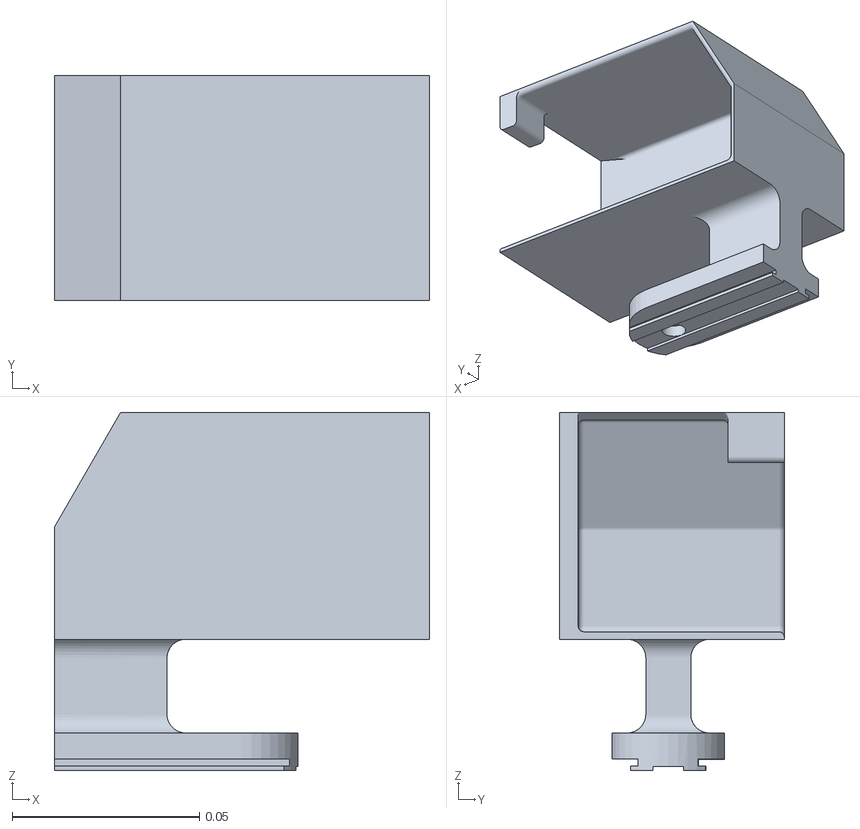
[picture p83: CAD file, 2026-07-12]
src/aries/meshes/gripper_left.stl
0.1 x 0.0601 x 0.0955
