shreyaspatel3010/aries/src/aries/meshes/gripper_base.stl

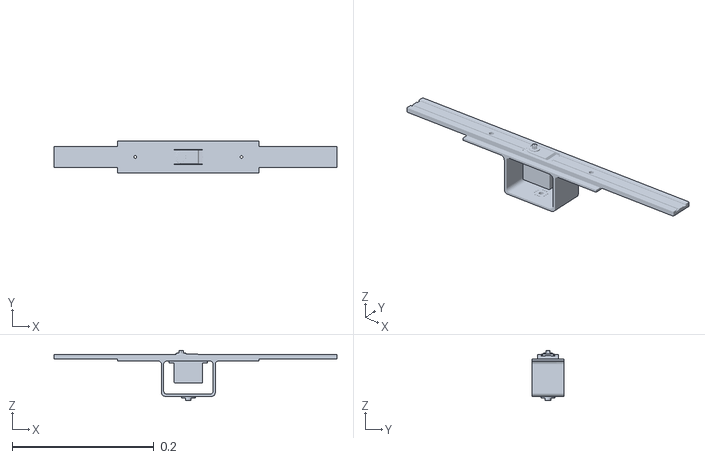
[picture p84: CAD file, 2026-07-12]
src/aries/meshes/gripper_base.stl
0.4 x 0.045 x 0.071
