shreyaspatel3010/aries/src/aries/meshes/L_Connecting_Rod_Diff_Link.STL

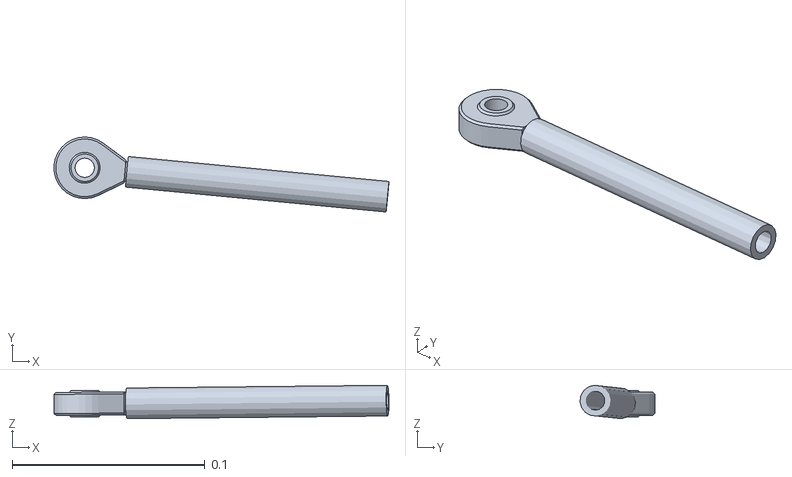
[picture p85: CAD file, 2026-07-12]
src/aries/meshes/L_Connecting_Rod_Diff_Link.STL
0.174 x 0.039 x 0.0173
