shreyaspatel3010/aries/src/aries/meshes/arm_gripper.stl

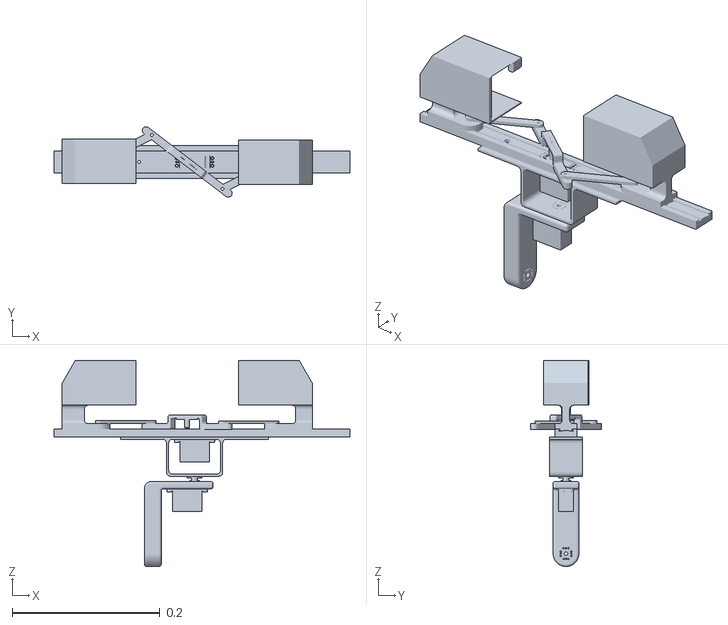
[picture p86: CAD file, 2026-07-12]
src/aries/meshes/arm_gripper.stl
0.4 x 0.0953 x 0.278
