shreyaspatel3010/aries/src/aries/meshes/R_Rod_link.stl

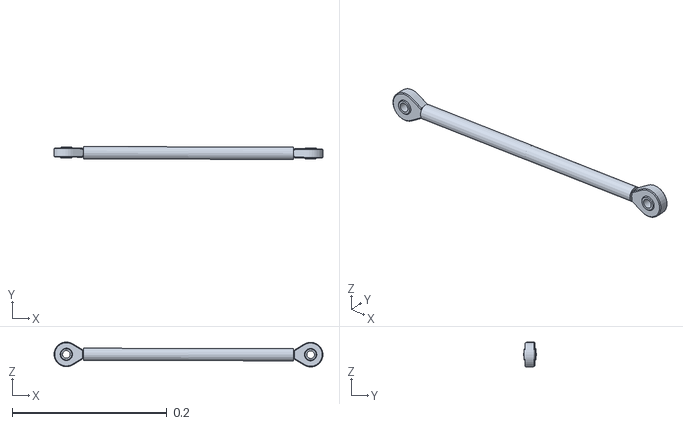
[picture p87: CAD file, 2026-07-12]
src/aries/meshes/R_Rod_link.stl
0.348 x 0.0169 x 0.0323
