shreyaspatel3010/aries/src/aries/meshes/right_rocker.stl

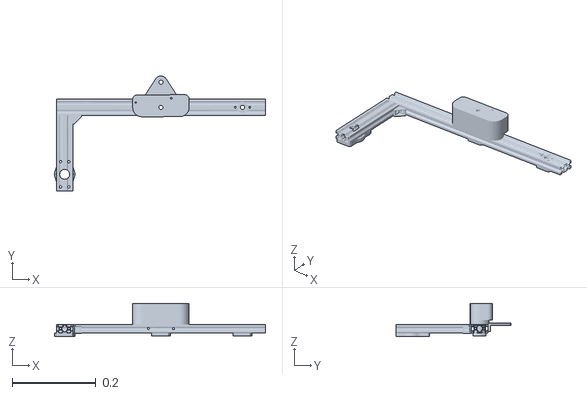
[picture p88: CAD file, 2026-07-12]
src/aries/meshes/right_rocker.stl
0.504 x 0.275 x 0.079
