shreyaspatel3010/aries/src/aries/meshes/L_Rocker_Link.STL

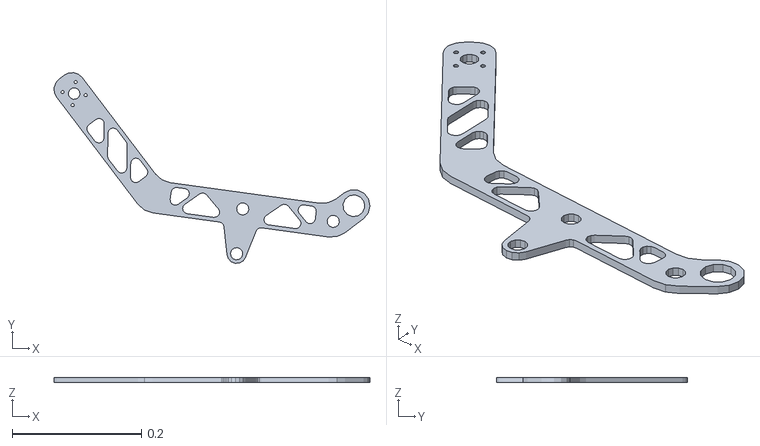
[picture p89: CAD file, 2026-07-12]
src/aries/meshes/L_Rocker_Link.STL
0.489 x 0.295 x 0.008
