shreyaspatel3010/aries/src/aries/meshes/base_link.STL

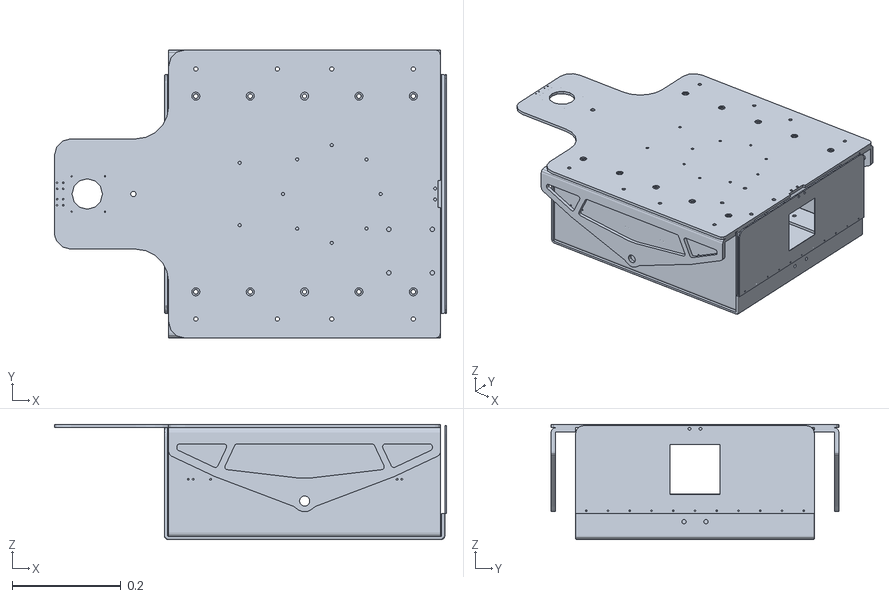
[picture p91: CAD file, 2026-07-12]
src/aries/meshes/base_link.STL
0.721 x 0.53 x 0.212
