shreyaspatel3010/aries/src/aries/meshes/arm_elbow.stl

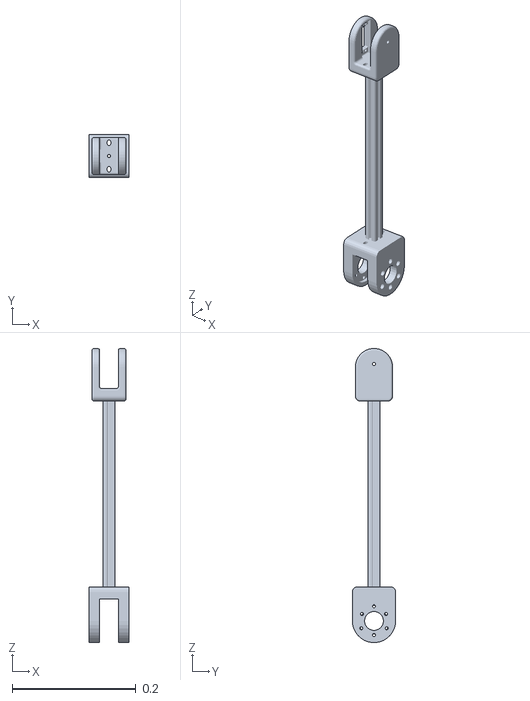
[picture p92: CAD file, 2026-07-12]
src/aries/meshes/arm_elbow.stl
0.065 x 0.07 x 0.475
