shreyaspatel3010/aries/src/aries/meshes/R_Rocker_Link.STL

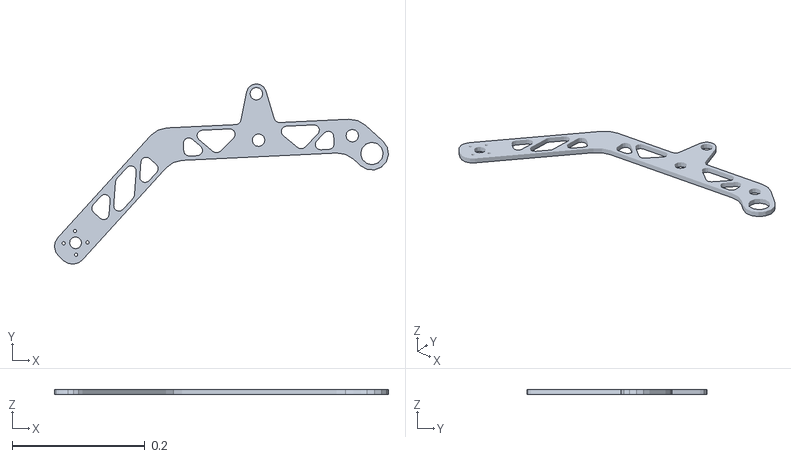
[picture p93: CAD file, 2026-07-12]
src/aries/meshes/R_Rocker_Link.STL
0.503 x 0.272 x 0.008
