shreyaspatel3010/aries/src/aries/meshes/arm_base.stl

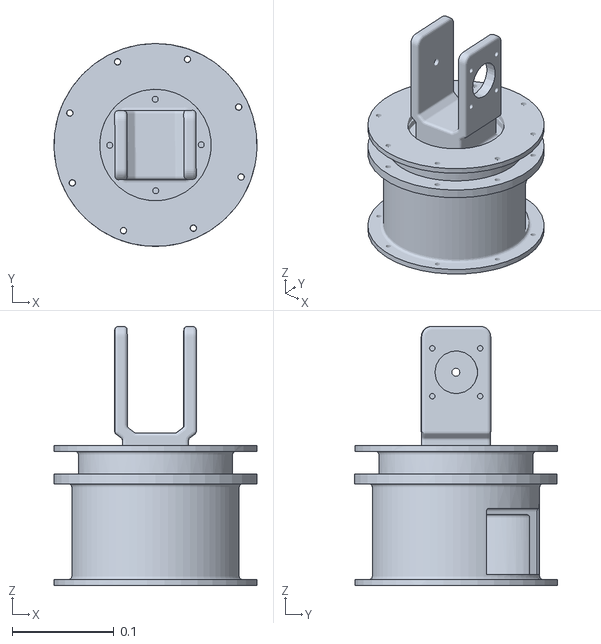
[picture p94: CAD file, 2026-07-12]
src/aries/meshes/arm_base.stl
0.2 x 0.2 x 0.255
