shreyaspatel3010/aries/src/aries/meshes/R_Connecting_Rod_Diff_Link.STL

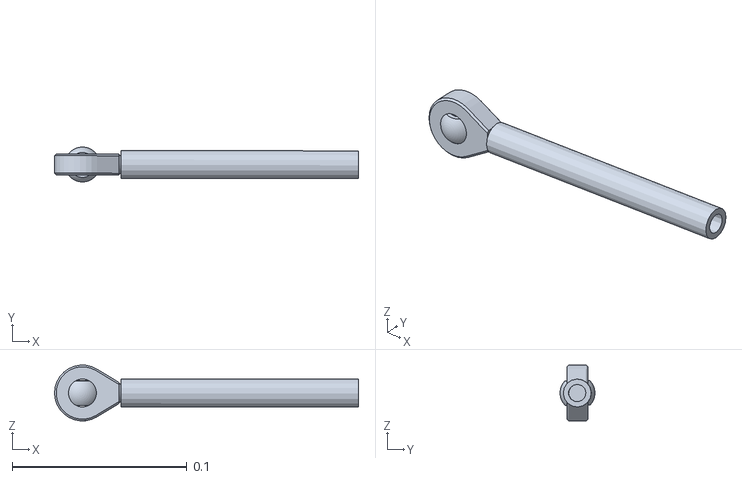
[picture p95: CAD file, 2026-07-12]
src/aries/meshes/R_Connecting_Rod_Diff_Link.STL
0.174 x 0.02 x 0.0319
