shreyaspatel3010/aries/src/aries/meshes/arm_wrist.stl

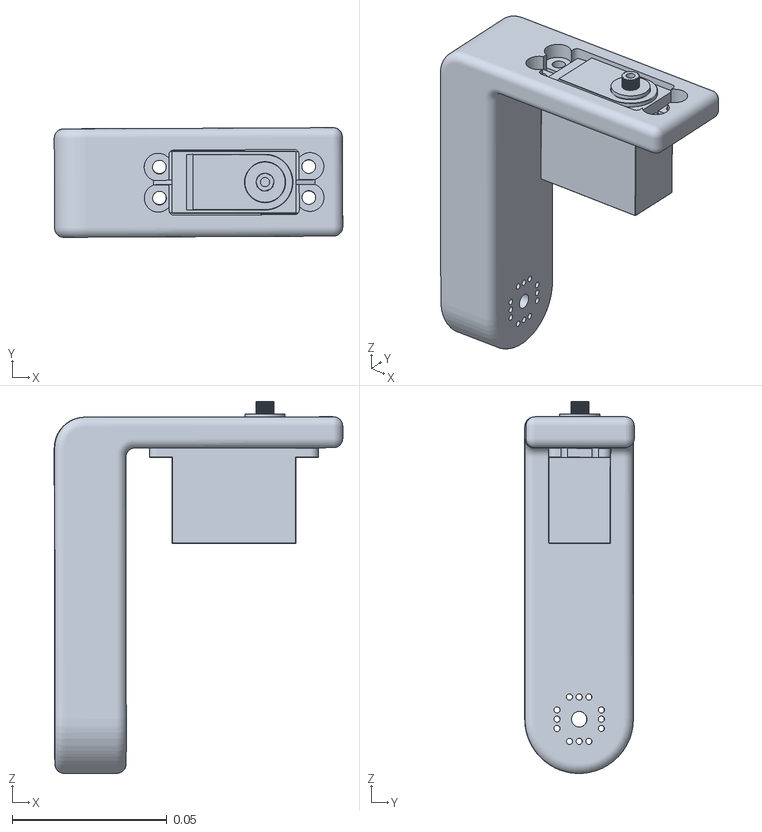
[picture p96: CAD file, 2026-07-12]
src/aries/meshes/arm_wrist.stl
0.0931 x 0.0354 x 0.12
