shreyaspatel3010/aries/src/aries/meshes/C_Differential_Link.STL

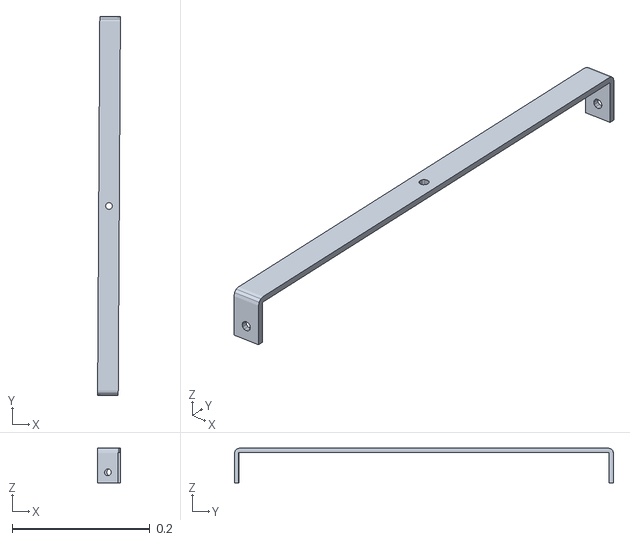
[picture p97: CAD file, 2026-07-12]
src/aries/meshes/C_Differential_Link.STL
0.0332 x 0.55 x 0.0502
