shreyaspatel3010/aries/src/aries/meshes/arm_shoulder.stl

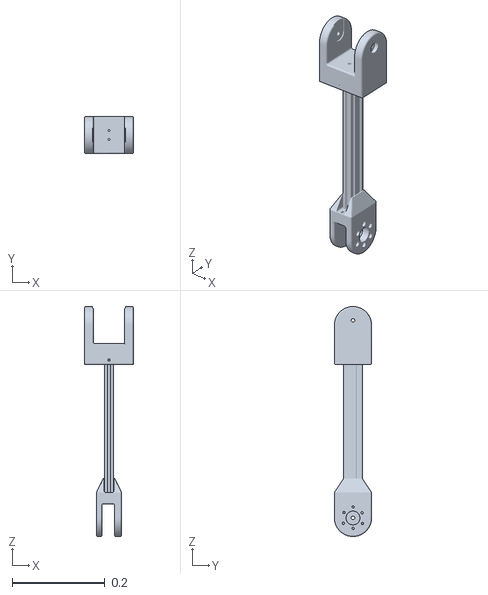
[picture p98: CAD file, 2026-07-12]
src/aries/meshes/arm_shoulder.stl
0.105 x 0.08 x 0.495
