shreyaspatel3010/aries/(list of files, cad)

Other CAD files:
src/aries/meshes/gripper_st3215/st3215_maintenance_left.stl
Maintenance Gripper Finger R.stl
src/aries/meshes/gripper_st3215/st3215_maintenance_right.stl
src/aries/meshes/gripper_v2/gripper_maintenance_right.stl
new_mesh/bucket gripper.3MF
src/aries/meshes/gripper_v2/gripper_bucket_left.stl
src/aries/meshes/robolink_rebel2/motor3.stl
new_mesh/gripper_bucket.stl
src/aries/meshes/gripper_st3215/st3215_rack_right.stl
src/aries/meshes/gripper_v2/gripper_coupler_left.stl
src/aries/meshes/robolink_rebel2/link1.stl
src/aries/meshes/gripper_v2/gripper_gear_left.stl
src/aries/meshes/gripper_v2/gripper_probe_left.stl
src/aries/meshes/robolink_rebel2/motor4.stl
src/aries/meshes/robolink_rebel2/motor2.stl
src/aries/meshes/right_bogie.stl
src/aries/meshes/gripper_right.stl
src/aries/meshes/L_Connecting_Rod_Link.STL
src/aries/meshes/L_1_Wheel_Link.STL
src/aries/meshes/L_2_Wheel_Link.STL
src/aries/meshes/L_3_Wheel_Link.STL
src/aries/meshes/R_1_Wheel_Link.STL
src/aries/meshes/R_2_Wheel_Link.STL
src/aries/meshes/R_3_Wheel_Link.STL
src/aries/meshes/gripper/gripper_base.stl
src/aries/meshes/gripper/gripper_base_pins.stl
src/aries/meshes/gripper/gripper_bucket.stl
src/aries/meshes/gripper/gripper_gear_left.stl
src/aries/meshes/gripper/gripper_gear_left_plate2.stl
src/aries/meshes/gripper/gripper_gear_right.stl
src/aries/meshes/gripper/gripper_gear_right_plate2.stl
src/aries/meshes/gripper/gripper_link_left.stl
src/aries/meshes/gripper/gripper_link_left_plate2.stl
src/aries/meshes/gripper/gripper_link_right.stl
src/aries/meshes/gripper/gripper_link_right_plate2.stl
src/aries/meshes/gripper/gripper_maintenance.stl
src/aries/meshes/gripper/gripper_probe.stl
src/aries/meshes/unused/L_1_Wheel_Link.STL
src/aries/meshes/unused/L_2_Wheel_Link.STL
src/aries/meshes/unused/L_3_Wheel_Link.STL
src/aries/meshes/unused/L_Connecting_Rod_Link.STL
src/aries/meshes/unused/R_1_Wheel_Link.STL
src/aries/meshes/unused/R_2_Wheel_Link.STL
src/aries/meshes/unused/R_3_Wheel_Link.STL
src/aries/meshes/unused/gripper/gripper_base.stl
src/aries/meshes/unused/gripper/gripper_base_legecy.stl
src/aries/meshes/unused/gripper/gripper_base_pins.stl
src/aries/meshes/unused/gripper/gripper_bucket.stl
src/aries/meshes/unused/gripper/gripper_gear_left.stl
src/aries/meshes/unused/gripper/gripper_gear_left_plate2.stl
src/aries/meshes/unused/gripper/gripper_gear_right.stl
src/aries/meshes/unused/gripper/gripper_gear_right_plate2.stl
src/aries/meshes/unused/gripper/gripper_link_left.stl
src/aries/meshes/unused/gripper/gripper_link_left_plate2.stl
src/aries/meshes/unused/gripper/gripper_link_right.stl
src/aries/meshes/unused/gripper/gripper_link_right_plate2.stl
src/aries/meshes/unused/gripper/gripper_maintenance.stl
src/aries/meshes/unused/gripper/gripper_probe.stl
src/aries/meshes/unused/gripper_right.stl
src/aries/meshes/unused/gripper_v2/gripper_bucket_left.stl
src/aries/meshes/unused/gripper_v2/gripper_coupler_left.stl
src/aries/meshes/unused/gripper_v2/gripper_gear_left.stl
src/aries/meshes/unused/gripper_v2/gripper_maintenance_right.stl
src/aries/meshes/unused/gripper_v2/gripper_probe_left.stl
src/aries/meshes/unused/robolink_rebel2/link1.stl
src/aries/meshes/unused/robolink_rebel2/motor2.stl
src/aries/meshes/unused/robolink_rebel2/motor3.stl
src/aries/meshes/unused/robolink_rebel2/motor4.stl
src/aries/meshes/unused/robolink_rebel2/rebel_6dof_03_collision/arm_base_link.stl
src/aries/meshes/unused/robolink_rebel2/rebel_6dof_03_collision/link1.stl
src/aries/meshes/unused/robolink_rebel2/rebel_6dof_03_collision/link2.stl
src/aries/meshes/unused/robolink_rebel2/rebel_6dof_03_collision/link3.stl
src/aries/meshes/unused/robolink_rebel2/rebel_6dof_03_collision/link4.stl
src/aries/meshes/unused/robolink_rebel2/rebel_6dof_03_collision/link5.stl
src/aries/meshes/unused/robolink_rebel2/rebel_6dof_03_collision/link6.stl
src/aries/meshes/unused/robolink_rebel2/rebel_6dof_03_collision/motor1.stl
src/aries/meshes/unused/robolink_rebel2/rebel_6dof_03_collision/motor2.stl
src/aries/meshes/unused/robolink_rebel2/rebel_6dof_03_collision/motor3.stl
src/aries/meshes/unused/robolink_rebel2/rebel_6dof_03_collision/motor4.stl
src/aries/meshes/unused/robolink_rebel2/rebel_6dof_03_collision/motor5.stl
src/aries/models/marsyard2026/marsyard2026_world.blend
