shreyaspatel3010/aries/src/aries_bringup/README.md

# Aries Bringup Launch Guide

This package contains wrapper launch files for common Aries bringup workflows.
Use this guide as a quick operational reference for simulation, hardware, and
gripper bringup.

## Prerequisites

Run this in every new terminal before launching:

```bash
cd ~/aries
source install/setup.bash
```

## Quickstart

Recommended launch order based on workflow.

### Field operation: operator at the base station (this is the competition setup)

Two commands, one per machine. Both run the same workspace.

```bash
# ROVER
ros2 launch aries_comms rover_field.launch.py

# BASE STATION  — the joystick plugs in HERE
ros2 launch aries_comms base_station.launch.py
```

Both live in **`aries_comms`** — they are two halves of one contract (which
end reads the pad, which end runs RViz, which end decompresses), and while they
sat in separate packages nothing compared them. `aries_bringup` keeps what is
about the robot rather than about the link.

`rover_field.launch.py` is `full_hardware.launch.py` plus the communication
layer, with three defaults flipped for remote operation:

  * **the DDS environment is set by the launch**, not inherited from the
    terminal. `full_hardware.launch.py` sets none, so it lands on whatever the
    calling shell had — and a shell opened before the exports existed keeps
    domain 0 with the default RMW for as long as it lives, which looks exactly
    like a dead link: ping fine, `ros2 topic list` empty, nothing logged;
  * `use_joy_node:=false` — the pad is at the base station. Every teleop
    consumer still runs on the rover and reads `/joy` across the link. Exactly
    one machine may read the pad, or two publishers interleave on `/joy`;
  * `use_gui:=false` — RViz belongs at the base station, not on a rover that
    needs its CPU for two RealSense pipelines and may have no display at all.

Everything `full_hardware.launch.py` accepts still works:

```bash
ros2 launch aries_comms rover_field.launch.py finger_type:=maintenance downlink_profile:=lean
```

Standing next to the robot with the pad in the rover's USB port instead:
`rover_field.launch.py use_joy_node:=true use_gui:=true`.

First-time setup — static addresses, radio configuration, verification — is
[`FIELD_SETUP.md`](../../FIELD_SETUP.md) at the repo root. Run
`./scripts/setup_field_link.sh {rover|base}` once per machine; on a field shared
with other teams a DHCP address is not just untidy, it stops `comms.py` being
able to tell which machine it is running on.

See `aries_comms/README.md` for the link budget, the latency budget, the
radio settings, and troubleshooting.

### Full Rover + Gazebo + MoveIt (most common)

1. Terminal 1:
   ```bash
   ros2 launch aries_bringup my_robot.launch.py use_joystick:=true
   ```

### Arm Hardware (igus Rebel over Ethernet)

1. Terminal 1:
   ```bash
   ros2 launch aries_bringup igus_rebel_hardware.launch.py use_joystick:=true
   ```

#### Move the arm physically by hand

The real-arm launch exposes a coordinated hand-guiding service. Before enabling
it, remove the payload if possible, clear the workspace, keep the emergency stop
within reach, and support the arm so it cannot fall when motor torque is removed.

Enable hand guiding:

```bash
ros2 service call /arm/set_hand_guiding std_srvs/srv/SetBool "{data: true}"
```

With the normalized joystick running, you can instead hold Y to enter hand
guiding and release Y to restore normal control. If joystick messages stop while
Y is held, a watchdog requests torque restoration after two seconds.

Move the arm slowly by hand, staying away from joint limits. When it is in the
desired pose, keep holding it and restore normal control:

```bash
ros2 service call /arm/set_hand_guiding std_srvs/srv/SetBool "{data: false}"
```

The service stops the arm trajectory controller before entering the Rebel CRI
`ZeroTorque` mode. On exit, it disables `ZeroTorque`, re-enables the motors, and
starts a fresh trajectory controller so an old trajectory cannot resume.

If the request says that `ZeroTorque` is unavailable, enable zero-torque mode in
the Rebel/iRC robot configuration and verify that the installed motor modules
support torque mode. A raw all-motors-disabled fallback is intentionally not used
because the ReBeL's spring-applied electromagnetic brakes engage without motor
voltage, so disabling the drives locks the joints instead of making them
backdrivable.

The iRC documentation does not define a separate physical teach/freedrive mode.
It calls powered movement with the software controls or gamepad followed by
recording a pose "teach-in programming"; `ZeroTorque` is the documented manual
guidance mode.

Use iRC **File -> Configuration Files**, load the robot configuration from the
robot, save a backup, and inspect its `ZeroTorque` entry. Each intended axis must
be enabled, for example `A1="true"` through `A6="true"`. Write the configuration
back to the robot and restart the controller. On an embedded controller the same
file is under
`~/RobotControl/Data/Robots/<category>/<robot type>/<robot type>.xml`, but the
iRC workflow is preferred. Only enable axes that igus confirms can be safely used
without torque. Joint-module firmware must report product `0x42`, firmware
`0x05 0x03` or newer.

### Gripper Hardware Only (Teensy over USB serial)

1. Terminal 1:
   ```bash
   ros2 launch aries_bringup gripper_hardware.launch.py
   ```

### Full Hardware (Arm + Gripper + Rover + MoveIt)

1. Terminal 1:
   ```bash
   ros2 launch aries_bringup full_hardware.launch.py
   ```

### Arm Simulation Only

1. Terminal 1:
   ```bash
   ros2 launch aries_bringup igus_rebel_simulated.launch.py use_joystick:=true
   ```

Joystick controls:
- Hold RB for Cartesian/Twist movement, or RT for Chain/JointJog. Either one
  also enables arm/gripper joystick output; holding both gives Cartesian.
- On the real arm, hold Y for physical hand guiding; release Y to restore torque.
- Servo output is filtered by `servo_collision_guard` before it reaches the arm controller.
- Release RB and RT to stop arm joystick commands.
- Hold X to manually open the gripper; hold B to manually close it.
- Release X/B to hold the current gripper angle. Press A to toggle full open/close.
- Use `joystick_control_mode:=move_group` only if you want the planned MoveGroup
  joystick backend.
- Joystick launch uses `joy_driver:=game_controller_node` by default and then
  normalizes the result back to the existing Xbox-style `gamepad.yaml` mapping.
  If you need the older raw Linux driver for testing, launch with
  `joy_driver:=joy_node joy_layout:=bluetooth`.

### RViz Display Only

1. Terminal 1:
   ```bash
   ros2 launch aries_bringup display.launch.xml
   ```

## Command Reference

- Rover + Gazebo + MoveIt: `ros2 launch aries_bringup my_robot.launch.py use_joystick:=true`
- Display-only RViz: `ros2 launch aries_bringup display.launch.xml`
- Simulated arm: `ros2 launch aries_bringup igus_rebel_simulated.launch.py use_joystick:=true`
- Arm hardware: `ros2 launch aries_bringup igus_rebel_hardware.launch.py use_joystick:=true`
- Gripper hardware: `ros2 launch aries_bringup gripper_hardware.launch.py`
- Full hardware: `ros2 launch aries_bringup full_hardware.launch.py`

## Rover CAN Setup

Bringup launch files do not run sudo CAN setup by default. Configure CAN
manually before launching real rover drive:

```bash
sudo ip link set can0 down
sudo ip link set can0 up type can bitrate 250000
```

Then launch normally. CAN setup is automatic by default:

```bash
ros2 launch aries_bringup rover_drive.launch.py can_interface:=can0
```

All CAN-related Aries bringup launches use automatic CAN setup by default:

```bash
ros2 launch aries_bringup rover_drive.launch.py
ros2 launch aries_bringup rover_drive_auto.launch.py
ros2 launch aries_bringup full_hardware.launch.py
```

The fail-safe ODrive bridge starts disarmed by default. After the hardware
check passes and the rover is clear:

```bash
ros2 service call /aries_drive/enable std_srvs/srv/SetBool "{data: true}"
```

It stops on stale `/cmd_vel`, clamps chassis and wheel speeds, ramps commands,
and confirms all six axes reached closed-loop control before allowing motion.

Disable automatic CAN setup only when you already configured CAN yourself:

```bash
ros2 launch aries_bringup rover_drive.launch.py setup_can:=false
ros2 launch aries_bringup full_hardware.launch.py setup_rover_can:=false
```

To use automatic CAN setup without a password prompt, install the limited
sudoers rule:

```bash
# from the workspace root, once per machine
./scripts/setup_system.sh
```

It only permits:

```bash
sudo ip link set can0 down
sudo ip link set can0 up type can bitrate 250000
```

## Teensy Serial Troubleshooting

Use this section when `gripper_hardware.launch.py` or `aries_hardware.launch.py`
fails to connect to the gripper controller.

### 1) Check that Teensy is detected

```bash
ls -l /dev/serial/by-id
ls -l /dev/ttyACM*
```

Expected: a Teensy entry such as
`/dev/serial/by-id/usb-Teensyduino_USB_Serial_... -> ../../ttyACM0`.

### 2) Check permissions

```bash
groups
```

If `dialout` is missing:

```bash
sudo usermod -aG dialout $USER
```

Then log out and log back in.

### 3) Override serial port explicitly

For gripper-only launch:

```bash
ros2 launch aries_bringup gripper_hardware.launch.py \
  serial_port:=/dev/serial/by-id/<your_teensy_id>
```

For full hardware launch:

```bash
ros2 launch aries_bringup aries_hardware.launch.py serial_port:=/dev/ttyACM0
```

Note:
- `gripper_hardware.launch.py` default is a `/dev/serial/by-id/...` path.
- `aries_hardware.launch.py` default is `/dev/ttyACM0`.

### 4) If the port keeps changing

- Prefer `/dev/serial/by-id/...` instead of `/dev/ttyACM*`.
- Replug Teensy and re-run `ls -l /dev/serial/by-id`.
- Close other serial tools (for example Arduino Serial Monitor) that may lock
  the port.

### 5) Quick ROS checks

```bash
ros2 control list_controllers
ros2 topic list | grep -E "gripper|controller_manager"
```

## Camera downlink (operator link over the antenna)

Both D435is keep publishing 640x480 **@ 30 Hz** on the rover for the grasp and
maintenance pipelines. Those topics are **not** for the operator: `moveit.rviz`
keeps four camera displays live, and subscribing to them raw is

| topic | raw @ 30 Hz |
|---|---|
| `/rover_camera/color/image_raw` | 221.2 Mbit/s |
| `/rover_camera/aligned_depth_to_color/image_raw` | 147.5 Mbit/s |
| `/gripper_camera/color/image_raw` | 221.2 Mbit/s |
| `/gripper_camera/aligned_depth_to_color/image_raw` | 147.5 Mbit/s |
| **total** | **737.3 Mbit/s** |

The capture rate went 15 -> 30 to halve the latency floor (a frame cannot be
delivered before the sensor has finished producing it), which doubled what a
raw subscription costs without changing the downlink at all: the rate gate
still runs at `downlink_rate_hz` and simply picks a fresher frame.

on Reliable QoS. That is far past what the antenna carries, and because each raw
frame is many times a UDP datagram, one lost fragment discards the whole frame
and the writer retransmits into a link that is already full. The result is
link-wide lag, not just slow images.

So the operator gets a separate, compressed stream.

**Rover** — started automatically by `full_hardware.launch.py` /
`aries_hardware.launch.py` (`enable_camera_downlink:=false` to suppress):

```
<camera>/color/image_raw ─┐
                          ├─ camera_downlink.py ─┬─ /downlink/<cam>/color ─ JPEG
<camera>/aligned_depth… ──┘   rate/scale/range   └─ /downlink/<cam>/depth ─ PNG16
```

**Operator laptop** — `aries_comms` starts this for you as part of
`base_station.launch.py`. On its own:

```bash
ros2 launch aries_bringup camera_view.launch.py use_rviz:=true
```

It decompresses to machine-local `/<camera>/view/color` and `/<camera>/view/depth`,
which is what the shipped `moveit.rviz` displays read. Decompressing once here
matters: RViz's ROS 2 Image display has no transport selection at all, so
pointing it at a rover topic puts raw frames back on the link regardless of what
the DepthCloud next to it is set to.

### Profiles

`downlink_profile` picks a measured operating point; any individual argument you
pass still overrides it.

| profile | resolution | JPEG | both cameras, 15 Hz colour / 5 Hz depth |
|---|---|---|---|
| `quality` | 640x480 | q90 | 42.3 Mbit/s |
| `balanced` *(default)* | 640x480 | q75 | **28.3 Mbit/s** |
| `lean` | 320x240 | q90 | 10.9 Mbit/s |

```bash
ros2 launch aries_bringup full_hardware.launch.py downlink_profile:=lean
```

Sized on a real Mars-yard image plus a D435i depth field with its stereo noise
modelled — high-frequency gravel is the worst case for JPEG, so real scenes come
in at or below these figures.

### Why the defaults are what they are

- **Full resolution, moderate JPEG** beats half resolution at high JPEG for the
  same bytes. Resolution is the quality term the operator actually perceives;
  halving it throws away detail no quality setting can restore.
- **Colour 15 Hz, depth 5 Hz.** A depth frame is ~91 kB against ~98 kB of
  colour, so running the cloud slower is what pays for full resolution while the
  image you drive by stays smooth. `downlink_depth_rate_hz:=15` for an equally
  smooth cloud, at ~35% more bandwidth.
- **Depth quantised to 10 mm** is not a quality loss: the D435i's own noise is
  4 mm at 1 m and 67 mm at 4 m, so a 10 mm step is below the sensor's own
  precision past ~1.5 m. It halves the depth bytes (186 kB → 91 kB).
  Noise-proportional quantisation was tried and is worse on both counts —
  149 kB *and* 127 mm max error against 91 kB and 10 mm.
- **PNG, not zstd, for depth.** Measured 186 kB vs 228 kB lossless.
- Colour and depth must share one resolution — RViz rejects a DepthCloud whose
  images differ ("Depth image resolution does not match color image resolution").

### Checking it on the real link

```bash
ros2 run aries_bringup downlink_report.py            # run this on the operator side
```

Reports Hz, kB/frame and Mbit/s per stream, plus frame age when the rover and
operator clocks are synced. Subscribing is what pulls the stream across, so what
it reports is what survived the link.

Other knobs: `downlink_rate_hz`, `downlink_decimation`, `downlink_jpeg_quality`,
`downlink_depth_max_m`, `downlink_depth_quantization_mm`, `downlink_png_level`.

The downlink stream is view-only — its depth is range-clipped and rounded, and
nothing plans against it. Encoding is lazy, so with no operator connected the
codecs cost nothing, and an RViz display you untick stops costing bandwidth.
