shreyaspatel3010/aries/src/aries/models/maintenance_panel/aruco_orig_13.png

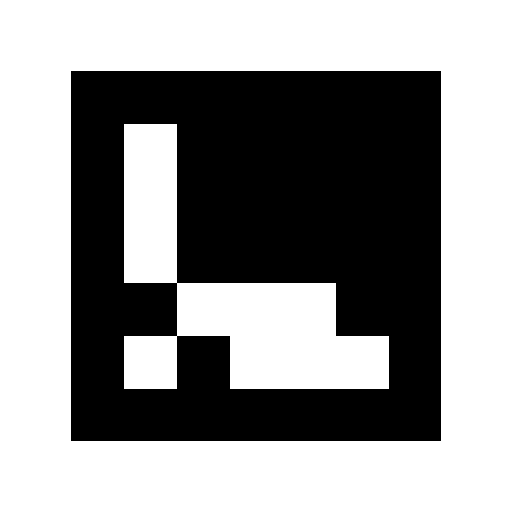
src/aries/models/maintenance_panel/aruco_orig_13.png
