shreyaspatel3010/aries/src/aries/models/maintenance_panel/aruco_orig_14.png

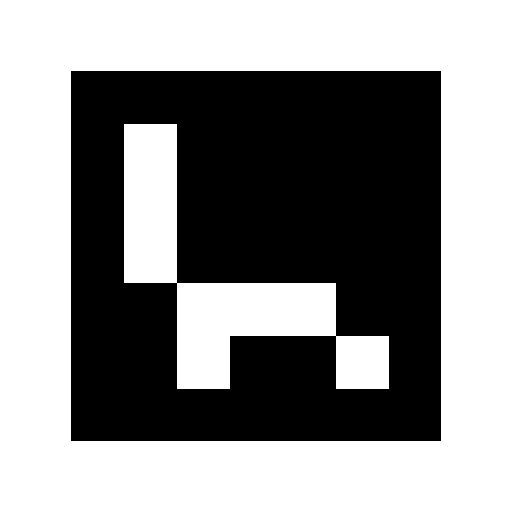
src/aries/models/maintenance_panel/aruco_orig_14.png
