shreyaspatel3010/aries/src/aries/models/maintenance_panel/aruco_orig_15.png

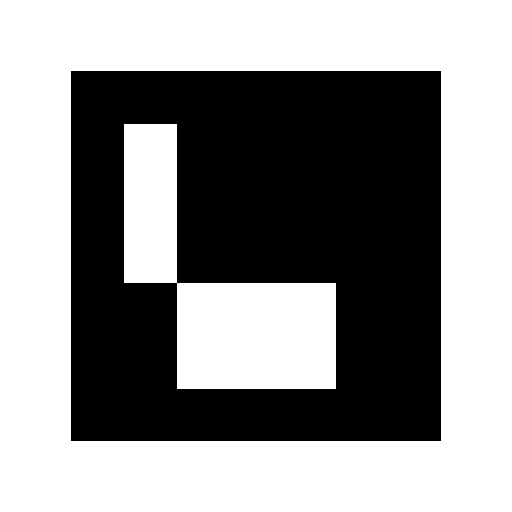
src/aries/models/maintenance_panel/aruco_orig_15.png
