shreyaspatel3010/aries/src/aries/models/maintenance_panel/model.sdf

<?xml version='1.0'?>
<!-- GENERATED by scripts/build_maintenance_panel.py. Do not hand-edit.

     Layout from "[ERC 2026] MY Update Report Rev.1.pdf"; control modules are
     the organisers' own CAD out of "Panel for Maintenance Tasks.zip", see
     ERC2026_PANEL_MODEL.md next to this file.

     0.390 x 0.490 x 1.000 m, base on the ground,
     console face 33 deg above horizontal, model front is its own +X.
     Collision is the bare console wedge, not the switch detail.

     Markers top-left/top-right/bottom-left: 11/13/14.
     There is no bottom-right marker slot.

     26 operable controls, all free joints the gripper moves directly -
     no position controller fights it and joint friction holds a control where
     the arm leaves it. Read them on /maintenance_panel/joint_states. -->
<sdf version='1.10'>
<model name='maintenance_panel'>
  <!-- Not <static>: a static model cannot carry joints, so the body is welded
       to the world instead. Same immobility, but the switches still move. -->
  <joint name='anchor' type='fixed'><parent>world</parent><child>body</child></joint>
  <link name='body'>
    <inertial><mass>40.0</mass>
      <inertia><ixx>4.0</ixx><iyy>4.0</iyy><izz>2.0</izz>
               <ixy>0</ixy><ixz>0</ixz><iyz>0</iyz></inertia></inertial>
    <collision name='body_collision'>
      <geometry><mesh><uri>model://maintenance_panel/meshes/panel_body_collision.glb</uri></mesh></geometry>
      <surface><friction><ode><mu>0.9</mu><mu2>0.9</mu2></ode></friction></surface>
    </collision>
    <visual name='body_visual'>
      <geometry><mesh><uri>model://maintenance_panel/meshes/panel_body.glb</uri></mesh></geometry>
    </visual>
  </link>
  <link name='mcb_0'>
    <pose>0.0837181 0.1441 0.822453 -0.577878 -0 -1.5708</pose>
    <inertial><mass>0.05</mass>
      <inertia><ixx>1e-5</ixx><iyy>1e-5</iyy><izz>1e-5</izz>
               <ixy>0</ixy><ixz>0</ixz><iyz>0</iyz></inertia></inertial>
    <visual name='mcb_0_visual'>
      <geometry><mesh><uri>model://maintenance_panel/meshes/mcb_0.glb</uri></mesh></geometry>
    </visual>
    <collision name='mcb_0_collision'>
      <geometry><mesh><uri>model://maintenance_panel/meshes/mcb_0.glb</uri></mesh></geometry>
    </collision>
  </link>
  <link name='mcb_1'>
    <pose>0.0837181 0.0723 0.822453 -0.577878 -0 -1.5708</pose>
    <inertial><mass>0.05</mass>
      <inertia><ixx>1e-5</ixx><iyy>1e-5</iyy><izz>1e-5</izz>
               <ixy>0</ixy><ixz>0</ixz><iyz>0</iyz></inertia></inertial>
    <visual name='mcb_1_visual'>
      <geometry><mesh><uri>model://maintenance_panel/meshes/mcb_1.glb</uri></mesh></geometry>
    </visual>
    <collision name='mcb_1_collision'>
      <geometry><mesh><uri>model://maintenance_panel/meshes/mcb_1.glb</uri></mesh></geometry>
    </collision>
  </link>
  <link name='mcb_2'>
    <pose>0.0837181 0.05428 0.822453 -0.577878 -0 -1.5708</pose>
    <inertial><mass>0.05</mass>
      <inertia><ixx>1e-5</ixx><iyy>1e-5</iyy><izz>1e-5</izz>
               <ixy>0</ixy><ixz>0</ixz><iyz>0</iyz></inertia></inertial>
    <visual name='mcb_2_visual'>
      <geometry><mesh><uri>model://maintenance_panel/meshes/mcb_2.glb</uri></mesh></geometry>
    </visual>
    <collision name='mcb_2_collision'>
      <geometry><mesh><uri>model://maintenance_panel/meshes/mcb_2.glb</uri></mesh></geometry>
    </collision>
  </link>
  <link name='mcb_3'>
    <pose>0.0837181 0.03626 0.822453 -0.577878 -0 -1.5708</pose>
    <inertial><mass>0.05</mass>
      <inertia><ixx>1e-5</ixx><iyy>1e-5</iyy><izz>1e-5</izz>
               <ixy>0</ixy><ixz>0</ixz><iyz>0</iyz></inertia></inertial>
    <visual name='mcb_3_visual'>
      <geometry><mesh><uri>model://maintenance_panel/meshes/mcb_3.glb</uri></mesh></geometry>
    </visual>
    <collision name='mcb_3_collision'>
      <geometry><mesh><uri>model://maintenance_panel/meshes/mcb_3.glb</uri></mesh></geometry>
    </collision>
  </link>
  <link name='mcb_4'>
    <pose>0.0837181 0.01824 0.822453 -0.577878 -0 -1.5708</pose>
    <inertial><mass>0.05</mass>
      <inertia><ixx>1e-5</ixx><iyy>1e-5</iyy><izz>1e-5</izz>
               <ixy>0</ixy><ixz>0</ixz><iyz>0</iyz></inertia></inertial>
    <visual name='mcb_4_visual'>
      <geometry><mesh><uri>model://maintenance_panel/meshes/mcb_4.glb</uri></mesh></geometry>
    </visual>
    <collision name='mcb_4_collision'>
      <geometry><mesh><uri>model://maintenance_panel/meshes/mcb_4.glb</uri></mesh></geometry>
    </collision>
  </link>
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
      <geometry><mesh><uri>model://maintenance_panel/meshes/mcb_12.glb</uri></mesh></geometry>
    </visual>
    <collision name='mcb_12_collision'>
      <geometry><mesh><uri>model://maintenance_panel/meshes/mcb_12.glb</uri></mesh></geometry>
    </collision>
  </link>
  <link name='mcb_13'>
    <pose>0.0837181 -0.14394 0.822453 -0.577878 -0 -1.5708</pose>
    <inertial><mass>0.05</mass>
      <inertia><ixx>1e-5</ixx><iyy>1e-5</iyy><izz>1e-5</izz>
               <ixy>0</ixy><ixz>0</ixz><iyz>0</iyz></inertia></inertial>
    <visual name='mcb_13_visual'>
      <geometry><mesh><uri>model://maintenance_panel/meshes/mcb_13.glb</uri></mesh></geometry>
    </visual>
    <collision name='mcb_13_collision'>
      <geometry><mesh><uri>model://maintenance_panel/meshes/mcb_13.glb</uri></mesh></geometry>
    </collision>
  </link>
  <link name='rotary_control_switch_0'>
    <pose>-0.0705046 -0.0475 0.915864 -0.577878 -0 -1.5708</pose>
    <inertial><mass>0.05</mass>
      <inertia><ixx>1e-5</ixx><iyy>1e-5</iyy><izz>1e-5</izz>
               <ixy>0</ixy><ixz>0</ixz><iyz>0</iyz></inertia></inertial>
    <visual name='rotary_control_switch_0_visual'>
      <geometry><mesh><uri>model://maintenance_panel/meshes/rotary_control_switch_0.glb</uri></mesh></geometry>
    </visual>
    <collision name='rotary_control_switch_0_collision'>
      <geometry><mesh><uri>model://maintenance_panel/meshes/rotary_control_switch_0.glb</uri></mesh></geometry>
    </collision>
  </link>
  <link name='rotary_control_switch_1'>
    <pose>-0.0705046 -0.1175 0.915864 -0.577878 -0 -1.5708</pose>
    <inertial><mass>0.05</mass>
      <inertia><ixx>1e-5</ixx><iyy>1e-5</iyy><izz>1e-5</izz>
               <ixy>0</ixy><ixz>0</ixz><iyz>0</iyz></inertia></inertial>
    <visual name='rotary_control_switch_1_visual'>
      <geometry><mesh><uri>model://maintenance_panel/meshes/rotary_control_switch_1.glb</uri></mesh></geometry>
    </visual>
    <collision name='rotary_control_switch_1_collision'>
      <geometry><mesh><uri>model://maintenance_panel/meshes/rotary_control_switch_1.glb</uri></mesh></geometry>
    </collision>
  </link>
  <link name='rotary_switch_0'>
    <pose>0.00530035 0.12 0.866429 -0.577878 -0 -1.5708</pose>
    <inertial><mass>0.05</mass>
      <inertia><ixx>1e-5</ixx><iyy>1e-5</iyy><izz>1e-5</izz>
               <ixy>0</ixy><ixz>0</ixz><iyz>0</iyz></inertia></inertial>
    <visual name='rotary_switch_0_visual'>
      <geometry><mesh><uri>model://maintenance_panel/meshes/rotary_switch_0.glb</uri></mesh></geometry>
    </visual>
    <collision name='rotary_switch_0_collision'>
      <geometry><mesh><uri>model://maintenance_panel/meshes/rotary_switch_0.glb</uri></mesh></geometry>
    </collision>
  </link>
  <link name='rotary_switch_1'>
    <pose>0.00530035 0.06 0.866429 -0.577878 -0 -1.5708</pose>
    <inertial><mass>0.05</mass>
      <inertia><ixx>1e-5</ixx><iyy>1e-5</iyy><izz>1e-5</izz>
               <ixy>0</ixy><ixz>0</ixz><iyz>0</iyz></inertia></inertial>
    <visual name='rotary_switch_1_visual'>
      <geometry><mesh><uri>model://maintenance_panel/meshes/rotary_switch_1.glb</uri></mesh></geometry>
    </visual>
    <collision name='rotary_switch_1_collision'>
      <geometry><mesh><uri>model://maintenance_panel/meshes/rotary_switch_1.glb</uri></mesh></geometry>
    </collision>
  </link>
  <link name='rotary_switch_2'>
    <pose>0.00530035 0 0.866429 -0.577878 -0 -1.5708</pose>
    <inertial><mass>0.05</mass>
      <inertia><ixx>1e-5</ixx><iyy>1e-5</iyy><izz>1e-5</izz>
               <ixy>0</ixy><ixz>0</ixz><iyz>0</iyz></inertia></inertial>
    <visual name='rotary_switch_2_visual'>
      <geometry><mesh><uri>model://maintenance_panel/meshes/rotary_switch_2.glb</uri></mesh></geometry>
    </visual>
    <collision name='rotary_switch_2_collision'>
      <geometry><mesh><uri>model://maintenance_panel/meshes/rotary_switch_2.glb</uri></mesh></geometry>
    </collision>
  </link>
  <link name='rotary_switch_3'>
    <pose>0.00530035 -0.06 0.866429 -0.577878 -0 -1.5708</pose>
    <inertial><mass>0.05</mass>
      <inertia><ixx>1e-5</ixx><iyy>1e-5</iyy><izz>1e-5</izz>
               <ixy>0</ixy><ixz>0</ixz><iyz>0</iyz></inertia></inertial>
    <visual name='rotary_switch_3_visual'>
      <geometry><mesh><uri>model://maintenance_panel/meshes/rotary_switch_3.glb</uri></mesh></geometry>
    </visual>
    <collision name='rotary_switch_3_collision'>
      <geometry><mesh><uri>model://maintenance_panel/meshes/rotary_switch_3.glb</uri></mesh></geometry>
    </collision>
  </link>
  <link name='rotary_switch_4'>
    <pose>0.00530035 -0.12 0.866429 -0.577878 -0 -1.5708</pose>
    <inertial><mass>0.05</mass>
      <inertia><ixx>1e-5</ixx><iyy>1e-5</iyy><izz>1e-5</izz>
               <ixy>0</ixy><ixz>0</ixz><iyz>0</iyz></inertia></inertial>
    <visual name='rotary_switch_4_visual'>
      <geometry><mesh><uri>model://maintenance_panel/meshes/rotary_switch_4.glb</uri></mesh></geometry>
    </visual>
    <collision name='rotary_switch_4_collision'>
      <geometry><mesh><uri>model://maintenance_panel/meshes/rotary_switch_4.glb</uri></mesh></geometry>
    </collision>
  </link>
  <link name='push_button_0'>
    <pose>0.172952 -0.08 0.75829 -0.577878 -0 -1.5708</pose>
    <inertial><mass>0.05</mass>
      <inertia><ixx>1e-5</ixx><iyy>1e-5</iyy><izz>1e-5</izz>
               <ixy>0</ixy><ixz>0</ixz><iyz>0</iyz></inertia></inertial>
    <visual name='push_button_0_visual'>
      <geometry><mesh><uri>model://maintenance_panel/meshes/push_button_0.glb</uri></mesh></geometry>
    </visual>
    <collision name='push_button_0_collision'>
      <geometry><mesh><uri>model://maintenance_panel/meshes/push_button_0.glb</uri></mesh></geometry>
    </collision>
  </link>
  <link name='push_button_1'>
    <pose>0.172952 -0.04 0.75829 -0.577878 -0 -1.5708</pose>
    <inertial><mass>0.05</mass>
      <inertia><ixx>1e-5</ixx><iyy>1e-5</iyy><izz>1e-5</izz>
               <ixy>0</ixy><ixz>0</ixz><iyz>0</iyz></inertia></inertial>
    <visual name='push_button_1_visual'>
      <geometry><mesh><uri>model://maintenance_panel/meshes/push_button_1.glb</uri></mesh></geometry>
    </visual>
    <collision name='push_button_1_collision'>
      <geometry><mesh><uri>model://maintenance_panel/meshes/push_button_1.glb</uri></mesh></geometry>
    </collision>
  </link>
  <link name='push_button_2'>
    <pose>0.172952 0 0.75829 -0.577878 -0 -1.5708</pose>
    <inertial><mass>0.05</mass>
      <inertia><ixx>1e-5</ixx><iyy>1e-5</iyy><izz>1e-5</izz>
               <ixy>0</ixy><ixz>0</ixz><iyz>0</iyz></inertia></inertial>
    <visual name='push_button_2_visual'>
      <geometry><mesh><uri>model://maintenance_panel/meshes/push_button_2.glb</uri></mesh></geometry>
    </visual>
    <collision name='push_button_2_collision'>
      <geometry><mesh><uri>model://maintenance_panel/meshes/push_button_2.glb</uri></mesh></geometry>
    </collision>
  </link>
  <link name='push_button_3'>
    <pose>0.172952 0.04 0.75829 -0.577878 -0 -1.5708</pose>
    <inertial><mass>0.05</mass>
      <inertia><ixx>1e-5</ixx><iyy>1e-5</iyy><izz>1e-5</izz>
               <ixy>0</ixy><ixz>0</ixz><iyz>0</iyz></inertia></inertial>
    <visual name='push_button_3_visual'>
      <geometry><mesh><uri>model://maintenance_panel/meshes/push_button_3.glb</uri></mesh></geometry>
    </visual>
    <collision name='push_button_3_collision'>
      <geometry><mesh><uri>model://maintenance_panel/meshes/push_button_3.glb</uri></mesh></geometry>
    </collision>
  </link>
  <link name='push_button_4'>
    <pose>0.172952 0.08 0.75829 -0.577878 -0 -1.5708</pose>
    <inertial><mass>0.05</mass>
      <inertia><ixx>1e-5</ixx><iyy>1e-5</iyy><izz>1e-5</izz>
               <ixy>0</ixy><ixz>0</ixz><iyz>0</iyz></inertia></inertial>
    <visual name='push_button_4_visual'>
      <geometry><mesh><uri>model://maintenance_panel/meshes/push_button_4.glb</uri></mesh></geometry>
    </visual>
    <collision name='push_button_4_collision'>
      <geometry><mesh><uri>model://maintenance_panel/meshes/push_button_4.glb</uri></mesh></geometry>
    </collision>
  </link>
  <joint name='mcb_0_joint' type='revolute'>
    <parent>body</parent><child>mcb_0</child>
    <axis>
      <xyz>-1 0 0</xyz>
      <limit><lower>-0.4</lower><upper>0.4</upper>
             <effort>1.0</effort><velocity>8.0</velocity></limit>
      <dynamics><damping>0.08</damping><friction>0.12</friction></dynamics>
    </axis>
  </joint>
  <joint name='mcb_1_joint' type='revolute'>
    <parent>body</parent><child>mcb_1</child>
    <axis>
      <xyz>-1 0 0</xyz>
      <limit><lower>-0.4</lower><upper>0.4</upper>
             <effort>1.0</effort><velocity>8.0</velocity></limit>
      <dynamics><damping>0.08</damping><friction>0.12</friction></dynamics>
    </axis>
  </joint>
  <joint name='mcb_2_joint' type='revolute'>
    <parent>body</parent><child>mcb_2</child>
    <axis>
      <xyz>-1 0 0</xyz>
      <limit><lower>-0.4</lower><upper>0.4</upper>
             <effort>1.0</effort><velocity>8.0</velocity></limit>
      <dynamics><damping>0.08</damping><friction>0.12</friction></dynamics>
    </axis>
  </joint>
  <joint name='mcb_3_joint' type='revolute'>
    <parent>body</parent><child>mcb_3</child>
    <axis>
      <xyz>-1 0 0</xyz>
      <limit><lower>-0.4</lower><upper>0.4</upper>
             <effort>1.0</effort><velocity>8.0</velocity></limit>
      <dynamics><damping>0.08</damping><friction>0.12</friction></dynamics>
    </axis>
  </joint>
  <joint name='mcb_4_joint' type='revolute'>
    <parent>body</parent><child>mcb_4</child>
    <axis>
      <xyz>-1 0 0</xyz>
      <limit><lower>-0.4</lower><upper>0.4</upper>
             <effort>1.0</effort><velocity>8.0</velocity></limit>
      <dynamics><damping>0.08</damping><friction>0.12</friction></dynamics>
    </axis>
  </joint>
  <joint name='mcb_5_joint' type='revolute'>
    <parent>body</parent><child>mcb_5</child>
    <axis>
      <xyz>-1 0 0</xyz>
      <limit><lower>-0.4</lower><upper>0.4</upper>
             <effort>1.0</effort><velocity>8.0</velocity></limit>
      <dynamics><damping>0.08</damping><friction>0.12</friction></dynamics>
    </axis>
  </joint>
  <joint name='mcb_6_joint' type='revolute'>
    <parent>body</parent><child>mcb_6</child>
    <axis>
      <xyz>-1 0 0</xyz>
      <limit><lower>-0.4</lower><upper>0.4</upper>
             <effort>1.0</effort><velocity>8.0</velocity></limit>
      <dynamics><damping>0.08</damping><friction>0.12</friction></dynamics>
    </axis>
  </joint>
  <joint name='mcb_7_joint' type='revolute'>
    <parent>body</parent><child>mcb_7</child>
    <axis>
      <xyz>-1 0 0</xyz>
      <limit><lower>-0.4</lower><upper>0.4</upper>
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
    <axis>
      <xyz>0 0 -1</xyz>
      <limit><lower>0</lower><upper>0.0025</upper>
             <effort>1.0</effort><velocity>8.0</velocity></limit>
      <dynamics><damping>0.08</damping><friction>0.12</friction></dynamics>
    </axis>
  </joint>
</model>
</sdf>
