shreyaspatel3010/aries/src/aries/urdf/gripper_st3215.xacro

<?xml version="1.0"?>
<robot xmlns:xacro="http://www.ros.org/wiki/xacro">

    <!--
        REBEL-6DOF-04 SECONDARY gripper (gripper_type:=st3215).

        Rack and pinion, driven by one Waveshare/Feetech ST3215 bus servo wired
        straight to the rover PC over the USB bus-servo adapter - NOT through
        the Teensy that runs the v2 gripper, the drill and the stack light.
        Built from the CAD export "new_gripper.glb";
        scripts/build_gripper_st3215_meshes.py splits that assembly into the
        per-link meshes loaded below and prints every number quoted here, so
        all of it can be regenerated rather than trusted.

        IT IS A DROP-IN SWAP FOR gripper_v2.xacro
        Same igus ReBeL tool flange (six M3.5 on a 43.01 mm bolt circle, same
        0/60/120... clocking), so arm_gripper_base_joint is byte-for-byte the
        one v2 uses.  The DRIVER JOINT KEEPS ITS NAME, gripper_gear_left_joint,
        and its sign convention - q = +0.07 rad closes, q < 0 opens - so the
        SRDF `open`/`closed` group states, gripper_controllers.yaml,
        moveit_controllers.yaml, gamepad.yaml and every cached pose keep
        working with no edit.  gripper_bucket_left_link and
        gripper_bucket_right_link keep their names too, which is what the ACM
        and the grasp stack address.

        The name survives because it is still literally true: the driver joint
        still turns a gear.  What changed is everything behind it.

        HOW IT WORKS
        The servo output shaft IS the pinion - direct drive, no reduction - so
        the joint value below is the servo shaft angle, exactly, with no
        calibration curve in between.  That is the whole reason this gripper is
        easier to command than v2, where the Teensy took a normalised 0-1 float
        and the hardware had no position sensor at all.  The pinion meshes with
        two opposed racks, one per jaw, so the jaws TRANSLATE along +/-X: the
        jaw faces stay parallel and square through the entire stroke, and the
        gap is exactly linear in q.  There is no over-centre point and no
        non-monotonic branch, both of which v2 has.

        THE ONE CONSTANT EVERYTHING ELSE FOLLOWS FROM
            rack_pitch_radius = 10.02676 mm of jaw travel per radian

        It is NOT measured off the tooth radii.  The pinion's tip radius is
        11.985 mm and its root 9.986, which fit no standard tooth form - the
        rack flanks work out at about a 7 deg pressure angle, so these are
        simplified printed teeth and any addendum reasoning about where the
        pitch circle sits is guesswork.  What is exact for any rack and pinion
        that meshes without skipping is that the rack advances one linear pitch
        per pinion angular pitch.  The pinion has 21 teeth (an order-parameter
        fit over the tooth-tip angles scores 0.911 at N=21 against 0.005 at
        every other count from 18 to 27) and the racks' tip lands sit on a
        3.0000 mm pitch, read straight off the exported vertex coordinates.
        So one servo turn is exactly 21 x 3 mm = 63.0 mm of rack, and

            travel per radian = 21 * 3.0000 / (2 * pi) = 10.02676 mm

        STROKE.  0 to 85.1 mm of jaw gap on the bucket fingers, 0.6 to 85.7 on
        the maintenance pair, against v2's 0 to 83 mm - comparable, over more
        than twice the joint travel for it.

          jaw gap [mm] against q [rad], exactly linear.  Both rows are the same
          mechanism - 2 * 10.02676 mm per radian - offset by where each
          fingertip's two halves actually meet.

            q             +0.07   0.00  -0.50  -1.00  -2.00  -3.00  -4.00  -4.18
            bucket          0.0    1.4   11.4   21.5   41.5   61.6   81.6   85.1
            maintenance     0.6    2.0   12.0   22.1   42.1   62.2   82.2   85.7

          bucket        lips meet at z = 207.8 mm from arm_gripper_base_link;
                        the flat shank faces run z = 115 to 155 mm.
          maintenance   one flat face per jaw, z = 115 to 207.8 mm, and they
                        never meet - see point 4.

        FOUR THINGS TO KNOW BEFORE TRUSTING A COMMANDED ANGLE

        1. -1.57 IS NOT THE SAME POSE ON THE TWO GRIPPERS.  It is v2's hard
           stop and its full 83 mm; here it is a 32.9 mm gap with two thirds of
           the travel still left.  aries.srdf is xacro now and its `open` state
           follows the fitted gripper (-1.57 on v2, -4.18 here), so MoveIt and
           the joystick agree - but a q value cached from a v2 session means a
           very different jaw gap on this gripper.

        2. THE JAWS NEST.  The two scoop halves are handed: the right lip runs
           3.000 mm wider than the left so the pair closes into one bowl.  It
           is the LIPS that meet at q = +0.07, at z = 203-208 mm; the flat
           shank faces are still 0.59 mm apart there.  Anything converting an
           object width into a close angle should use the gap table above,
           which is measured at the shank faces, and stop short of +0.07 on
           anything it actually means to hold.

        3. WHICH FINGERTIP IS FITTED CHANGES WHERE ZERO GAP IS.  finger_type
           picks the pair, and it is the one thing about this gripper that
           swaps without anything else in the stack noticing: same link names,
           same joints, same controllers.

           On the maintenance finger the jaws are FLAT and have nothing
           reaching past the shank plane, so they would meet at q = +0.0997 -
           past the joint limit.  A full close leaves them 0.595 mm apart and
           they cannot be driven further.  That is why the row above starts at
           0.6 rather than 0.0, and it is not a modelling slack to be trimmed
           out: q's zero stays on the CAD pose so that closed_steps survives a
           finger swap and a cached pose still means the same jaw position on
           either pair.  aries_vision_grasp/fourbar.py carries the touch angle
           per finger; anything else sizing a grip must too.

        4. THE STROKE NEARLY FILLS THE SERVO'S SINGLE TURN.  q spans +0.07 to
           -4.291 = 4.361 rad = 250 deg = 2843 of the ST3215's 4096 steps, out
           of a usable 3995 (50..4045).  So the zero is NOT free to sit
           anywhere: closed_steps must be at least 2893 with invert false.  On
           the built gripper it is closed_steps 3307, invert FALSE - opening
           DECREASES the count - putting the open end at 464 at the joint limit
           and 539 as commanded, against a stop at 489.

           That fit is only possible because the servo's position-correction
           register is set; see the note on gripper_open_travel below.  Unlike
           v2 this servo reports a real position, so a mis-set zero shows up
           immediately in /joint_states rather than being echoed back as if it
           were fine.
    -->

    <xacro:property name="rack_pitch_radius" value="0.01002676"/>

    <!-- Full open, MEASURED ON THE ASSEMBLED GRIPPER, 2026-08-29.  Torque off,
         jaws back-driven by hand from stop to stop in one continuous motion,
         recorded at 25 Hz with the position unwrapped across the encoder seam:

             full open              step  489
             SERVO-REACHABLE close   step 3307   <- this is closed_steps
             usable travel           2818 steps = 4.3228 rad

         which is 43.5 mm of travel per jaw and an 86.7 mm gap.

         THESE LIVE IN aries_common/config/gripper_st3215.yaml, not here. That
         file is the one place to change them; the launch files derive this
         travel, the SRDF `open` state, the teleop open position and the
         component's min_pos from it, so they cannot drift apart.

         CLOSED_STEPS IS THE SERVO-REACHABLE STOP, NOT THE HAND-FORCED ONE.  A
         hand can flex the jaws 482 steps (7.4 mm per jaw) past where the servo
         can drive them.  Aiming q=+0.07 at the hand figure makes every close
         command push into a shortfall it can never deliver - measured stalling
         at step 3038 with the motor audibly straining.  Measure this end by
         driving it closed and reading where it stalls, not by pushing it shut.  This gripper
         opens WIDER than v2 (83 mm), over more than twice the joint travel.

         THIS DEPENDS ON THE SERVO'S POSITION-CORRECTION OFFSET.  Register 31 is
         set to 1232 (it was 85 as delivered).  Without that offset the stroke
         straddles the 4095/0 seam, and a single-turn servo cannot hold a goal
         across it: told to go from one side to the other it drives the long way
         round, backwards through the whole mechanism.  That is not something
         closed_steps or invert can fix.  If the servo is ever swapped or
         factory-reset, reg31 must be set again or every number here is wrong.

         DO NOT REPLACE THIS WITH THE BUILD SCRIPT'S NUMBER.  Ray-casting the
         CAD says 42.8 mm per jaw; the measurement says 46.6.  The 2026-08-28
         GLB re-export merged and dropped solids, so the ray sees a different
         mount to the one on the robot.  The measurement wins.

         THE JOINT LIMIT AND THE COMMAND LIMIT ARE NOT THE SAME NUMBER, and
         conflating them is what broke the arm:

           * This limit is what the joint may BE.  It has to cover every pose
             the gripper can physically hold, plus slack for backlash and
             encoder noise, or a legitimate parked position reports as out of
             bounds - and MoveIt then refuses to plan for the WHOLE ARM, not
             just the gripper:

                 Joint 'gripper_gear_left_joint' from the starting state is
                 outside bounds by: [-1.84594] should be in [-1.80457], [0.07]
                 PlanningRequestAdapter 'CheckStartStateBounds' failed

             So the limit spans the full 3031-step stroke plus 25 steps.

           * What we COMMAND is clamped separately and tighter, by min_pos on
             the hardware component in igus_rebel2.control.xacro (-4.18, i.e.
             50 steps off the stop).  The component clamps every write to it, so
             even a slider dragged to this limit cannot drive the servo into the
             stop.

         Keep it that way round: generous on what can be observed, tight on what
         can be commanded. -->
    <!-- Fed from aries_common/config/gripper_st3215.yaml via the launch files,
         which DERIVE it from the measured stops. The default here is only for a
         bare `xacro my_robot.urdf.xacro` with no launch behind it. -->
    <xacro:arg name="gripper_open_travel" default="0.043026"/>
    <xacro:property name="gripper_open_travel" value="$(arg gripper_open_travel)"/>

    <!-- Keep the nominal commands inside Gazebo's physics limits.  When a
         commanded endpoint equals a DART hard stop the mimic-constrained
         joints can wedge there and refuse the following reverse command.  Real
         hardware retains its physical limits.  Same margin gripper_v2.xacro
         uses, for the same reason. -->
    <xacro:property name="gripper_joint_lower_limit" value="${(-gripper_open_travel / rack_pitch_radius) - (0.05 if gripper_hardware_protocol == 'gazebo' else 0.0)}"/>
    <xacro:property name="gripper_joint_upper_limit" value="${0.12 if gripper_hardware_protocol == 'gazebo' else 0.07}"/>

    <!-- The rack joints mimic the driver at +rack_pitch_radius, so their limits
         are the driver's scaled by the same factor.  Reusing the driver limits
         unscaled would make every pose invalid in MoveIt by three orders of
         magnitude. -->
    <xacro:property name="rack_joint_lower_limit" value="${gripper_joint_lower_limit * rack_pitch_radius}"/>
    <xacro:property name="rack_joint_upper_limit" value="${gripper_joint_upper_limit * rack_pitch_radius}"/>

    <!-- Real ST3215 numbers rather than v2's placeholder 500 N.m / 1.0 rad/s.
         Stall torque is 30 kg.cm at 12 V and no-load speed 45 rpm, and the
         pinion is direct-driven, so these ARE the joint's limits with nothing
         in between. The velocity matters: this gripper has to turn 4.135 rad to
         go from closed to fully open where v2 turns 1.64, so at v2's nominal
         1.0 rad/s a full open would take over four seconds. joint_limits.yaml
         allows the gripper 10 rad/s, so this is the binding value. -->
    <xacro:property name="servo_effort" value="2.94"/>
    <xacro:property name="servo_velocity" value="4.71"/>

    <!-- Only Gazebo reads these. Sized the same way gripper_v2.xacro's are:
         damping gives an explicit-integration limit of h < 2I/b well clear of
         the 1 ms world step, and friction stays under each link's own gravity
         load so it cannot weld the mechanism. The racks are prismatic, so
         their friction is a force in newtons, not a torque. -->
    <xacro:property name="pinion_joint_damping" value="0.01"/>
    <xacro:property name="pinion_joint_friction" value="0.001"/>
    <xacro:property name="rack_joint_damping" value="5.0"/>
    <xacro:property name="rack_joint_friction" value="0.05"/>

    <!-- Mass properties integrated from each exported mesh at 1050 kg/m^3
         (near-solid printed plastic), the density gripper_v2.xacro uses so the
         two grippers stay comparable. The servo is the exception: it is
         carried at the ST3215's datasheet 60 g and combined with the mount by
         parallel axis, so the base tensor is not a uniform-density one.

         TOTAL 797 g with the bucket fingers and 815 g with the maintenance
         pair, against v2's 458 g. Most of that is the mount casting - 404 cm^3
         of modelled solid, 424 g at this density - and the two 104 cm^3 scoops;
         the maintenance jaws are 113 cm^3 each because their section is solid
         where the scoop is a shell. If the real parts are printed at a normal
         infill the true figure will be well under this; the density is
         deliberately the conservative one, and it is the number the ReBeL's
         payload budget should be checked against. -->
    <xacro:macro name="gripper_inertial" params="mass cx cy cz ixx iyy izz ixy:=0 ixz:=0 iyz:=0">
        <inertial>
            <origin xyz="${cx} ${cy} ${cz}" rpy="0 0 0"/>
            <mass value="${mass}"/>
            <inertia ixx="${ixx}" ixy="${ixy}" ixz="${ixz}" iyy="${iyy}" iyz="${iyz}" izz="${izz}"/>
        </inertial>
    </xacro:macro>

    <xacro:macro name="gripper_mesh_geometry" params="file">
        <visual>
            <origin xyz="0 0 0" rpy="0 0 0"/>
            <geometry>
                <mesh filename="${mesh_location}/gripper_st3215/${file}"/>
            </geometry>
            <material name="">
                <color rgba="1 1 1 1"/>
            </material>
        </visual>
        <collision>
            <origin xyz="0 0 0" rpy="0 0 0"/>
            <geometry>
                <mesh filename="${mesh_location}/gripper_st3215/${file}"/>
            </geometry>
        </collision>
    </xacro:macro>

    <!-- ==================== mount ==================== -->
    <!-- Identical to gripper_v2.xacro's, deliberately: the flange bolt circle
         on this mount is the same radius at the same clocking, so the two
         grippers hang off link6 in the same place and the same orientation and
         nothing that cached a TF between link6 and the gripper has to care
         which one is fitted. -->
    <joint name="arm_gripper_base_joint" type="fixed">
        <parent link="link6"/>
        <child link="arm_gripper_base_link"/>
        <origin xyz="0.0 0.0 0.0522" rpy="0.0 0.0 3.141592653589793"/>
    </joint>

    <!-- Mount casting, end walls and the ST3215 case, merged into one solid. -->
    <link name="arm_gripper_base_link">
        <xacro:gripper_inertial mass="0.4843" cx="0.00182" cy="0.00466" cz="0.05230" ixx="8.4368e-04" iyy="2.0360e-03" izz="1.6291e-03" ixy="1.2821e-05" ixz="-2.1053e-05" iyz="1.0487e-04"/>
        <xacro:gripper_mesh_geometry file="st3215_base.stl"/>
    </link>

    <!-- ==================== pinion (the driver) ==================== -->
    <!-- Keeps gripper_v2's name for the joint AND for its child link. That is
         not a compatibility fudge: in both grippers this joint is the one the
         controller commands and its child is the gear it turns.

         AXIS IS -Z, NOT +Z, and that is what makes +q close. The rack that
         meshes on the +Y side of the pinion moves -X when the pinion turns
         about +Z, and that rack carries the LEFT (-X) jaw, so a +Z axis would
         make +q open - backwards from the convention the rest of the stack
         assumes. Flipping the axis is preferred to negating both mimic
         multipliers, so that the two rack joints report the same number and a
         reader comparing joint_states sees one value, not a signed pair. -->
    <link name="gripper_gear_left_link">
        <xacro:gripper_inertial mass="0.0086" cx="0.0" cy="0.0" cz="0.00413" ixx="1.8985e-06" iyy="1.8985e-06" izz="4.4095e-07"/>
        <xacro:gripper_mesh_geometry file="st3215_pinion.stl"/>
    </link>

    <joint name="gripper_gear_left_joint" type="revolute">
        <parent link="arm_gripper_base_link"/>
        <child link="gripper_gear_left_link"/>
        <origin xyz="0.0 0.0 0.083195" rpy="0.0 0.0 0.0"/>
        <axis xyz="0 0 -1"/>
        <limit effort="${servo_effort}" velocity="${servo_velocity}" lower="${gripper_joint_lower_limit}" upper="${gripper_joint_upper_limit}"/>
        <dynamics damping="${pinion_joint_damping}" friction="${pinion_joint_friction}"/>
    </joint>

    <!-- ==================== racks ==================== -->
    <!-- One degree of freedom, carried by the gear mesh. The multiplier is the
         travel-per-radian constant and it is POSITIVE on both sides; the
         opposite sense of the two jaws is in the axis, so both joints report
         the same positive number as they close.

         WHICH CAD SOLID CARRIES WHICH JAW IS NOT WHAT THE NAMES SAY. The solid
         named "Rack" in the export has its teeth on +Y and its carrier block
         under the -X fingertip, so it is the LEFT rack here; "Rack 2" is the
         mirror. The build script asserts the assignment by carrier position
         rather than by name, because getting it backwards silently flips the
         whole open/close convention while still looking like a working
         gripper. -->
    <xacro:macro name="rack" params="side sx cx cy ixy ixz iyz">
        <link name="gripper_rack_${side}_link">
            <xacro:gripper_inertial mass="0.0426" cx="${cx}" cy="${cy}" cz="0.10412" ixx="1.8332e-05" iyy="5.2456e-05" izz="6.7720e-05" ixy="${ixy}" ixz="${ixz}" iyz="${iyz}"/>
            <xacro:gripper_mesh_geometry file="st3215_rack_${side}.stl"/>
        </link>

        <joint name="gripper_rack_${side}_joint" type="prismatic">
            <parent link="arm_gripper_base_link"/>
            <child link="gripper_rack_${side}_link"/>
            <origin xyz="0.0 0.0 0.0" rpy="0.0 0.0 0.0"/>
            <axis xyz="${sx} 0 0"/>
            <limit effort="${servo_effort / rack_pitch_radius}" velocity="${servo_velocity * rack_pitch_radius}" lower="${rack_joint_lower_limit}" upper="${rack_joint_upper_limit}"/>
            <dynamics damping="${rack_joint_damping}" friction="${rack_joint_friction}"/>
            <mimic joint="gripper_gear_left_joint" multiplier="${rack_pitch_radius}" offset="0.0"/>
        </joint>
    </xacro:macro>

    <xacro:rack side="left" sx="1" cx="0.00338" cy="0.00716" ixy="-9.6137e-06" ixz="5.1487e-06" iyz="2.0759e-06"/>
    <xacro:rack side="right" sx="-1" cx="-0.00338" cy="-0.00838" ixy="-8.5631e-06" ixz="-5.1487e-06" iyz="-1.8410e-06"/>

    <!-- ==================== fingertips ==================== -->
    <!-- SWAPPABLE.  finger_type picks the pair that is physically bolted to the
         racks; every number below comes from
         scripts/build_gripper_st3215_meshes.py, which lands each pair on the
         rack by matching its bolt face and prints exactly this table.

           bucket        clamshell scoops, the pair the assembly was CAD'd with.
                         Handed: the right lip runs 3.000 mm wider than the left
                         so they close into one bowl.  For scooping and for
                         anything round.
           maintenance   flat parallel jaws.  The clamping face is one plane
                         running the full 93 mm of the jaw, so the grip is a
                         line contact at any height rather than a point at the
                         lip - which is what panel handles, levers and breakers
                         want.  Handed too, but only just: see the build script.

         THEY DO NOT SHARE A CLOSED POSE, and that is the one thing a finger
         swap changes that nothing else in the stack can see:

           bucket        lips meet at q = +0.070.  "Closed" is closed.
           maintenance   faces meet at q = +0.0997, which is PAST the joint
                         limit.  At the +0.070 this stack calls closed the jaws
                         are still 0.595 mm apart, and they cannot be driven
                         further.

         So on the maintenance finger a commanded gap is 0.595 mm wider than the
         object it was sized for.  aries_vision_grasp/fourbar.py carries that
         per finger; anything else converting a width into an angle must too.

         q's ZERO IS THE CAD POSE, NOT THE FINGERTIP, deliberately: it is why
         gripper_st3215.yaml's closed_steps survives a finger swap and a pose
         cached with one pair still means the same jaw position with the other.
         The cost is the gap above.  Measure closed_steps with the BUCKET
         fitted - it is the pair whose stall lands on q = +0.070.

         Bolted to their racks, so these joints are fixed - there is no
         fingertip degree of freedom to cancel the way v2's -1.0 mimic cancels
         its bar. They are separate links only so that gripper_bucket_*_link
         keeps addressing the jaw the way it does on v2: that is the name the
         ACM, the grasp stack and the held-probe check all use, and it keeps it
         WHICHEVER FINGER IS FITTED.  Renaming it per finger_type would mean an
         SRDF, an ACM and a bridge config per finger for no gain.

         Their frames are arm_gripper_base_link's frame at q = 0, so every
         number below reads directly in base coordinates at the zero pose.

         EVERY VALUE IS PER SIDE, none is mirrored from the other.  The two
         halves of a pair are not mirror images - the bucket's lips are handed
         and the maintenance pair is two slightly different parts - and a
         mirrored constant is not merely imprecise here: ixz changes SIGN
         between the two finger families, because the bucket flares away from
         the axis as it rises and the maintenance hook curls toward it.

         COLLISION IS BOXES, AND IT HAS TO STAY THAT WAY. In this gz-sim /
         DART-bullet stack a <mesh> collision generates NO contacts against
         another <mesh>: bullet wraps both as concave GImpact shapes and
         GImpact-vs-GImpact yields no manifold, which is why the v2 fingers
         passed through everything they were asked to operate. Four boxes per
         tip, z-bands tiling the mesh end to end so there is no gap, x/y from a
         300k-point surface sampling. The bands are SOLID where the real part is
         a shell or a hook - the same conservative trade gripper_v2.xacro makes,
         and for the same reason: nothing in these worlds is scooped as
         particles. -->
    <xacro:macro name="fingertip" params="side mass cx cy cz ixx iyy izz ixy ixz iyz b0x b12x b12sx bsy b3x b3sx">
        <link name="gripper_bucket_${side}_link">
            <xacro:gripper_inertial mass="${mass}" cx="${cx}" cy="${cy}" cz="${cz}" ixx="${ixx}" iyy="${iyy}" izz="${izz}" ixy="${ixy}" ixz="${ixz}" iyz="${iyz}"/>
            <visual>
                <origin xyz="0 0 0" rpy="0 0 0"/>
                <geometry>
                    <mesh filename="${mesh_location}/gripper_st3215/st3215_${finger_type}_${side}.stl"/>
                </geometry>
                <material name="">
                    <color rgba="1 1 1 1"/>
                </material>
            </visual>
            <!-- band0 is the bolt block, which is the same 32 x 77.5 mm shank on
                 every fingertip in the family - that is the interface the build
                 script lands them on. -->
            <collision name="tip_band0">
                <origin xyz="${b0x} -0.00100 0.12660" rpy="0 0 0"/>
                <geometry><box size="0.0320 0.0775 0.0232"/></geometry>
            </collision>
            <collision name="tip_band1">
                <origin xyz="${b12x} -0.00075 0.14980" rpy="0 0 0"/>
                <geometry><box size="${b12sx} ${bsy} 0.0232"/></geometry>
            </collision>
            <collision name="tip_band2">
                <origin xyz="${b12x} -0.00075 0.17300" rpy="0 0 0"/>
                <geometry><box size="${b12sx} ${bsy} 0.0232"/></geometry>
            </collision>
            <collision name="tip_band3">
                <origin xyz="${b3x} -0.00075 0.19620" rpy="0 0 0"/>
                <geometry><box size="${b3sx} ${bsy} 0.0232"/></geometry>
            </collision>
        </link>

        <joint name="gripper_bucket_${side}_joint" type="fixed">
            <parent link="gripper_rack_${side}_link"/>
            <child link="gripper_bucket_${side}_link"/>
            <origin xyz="0.0 0.0 0.0" rpy="0.0 0.0 0.0"/>
        </joint>
    </xacro:macro>

    <!-- The scoops.  Band3 is where the handedness shows: the right lip is
         43.0 mm wide against the left's 40.0, which is what lets the two nest,
         and at q = +0.07 those two boxes overlap by 2.4 mm.  That overlap is
         correct geometry, which is why aries.srdf disables this pair.  Do not
         "tidy" the widths to match. -->
    <xacro:if value="${finger_type == 'bucket'}">
        <xacro:fingertip side="left" mass="0.1091" cx="-0.02098" cy="-0.00083" cz="0.15027" ixx="1.0192e-04" iyy="8.3559e-05" izz="5.4152e-05" ixy="3.0378e-08" ixz="8.0858e-06" iyz="-2.3689e-07" b0x="-0.01700" b12x="-0.02600" b12sx="0.0500" bsy="0.0600" b3x="-0.02101" b3sx="0.0400"/>
        <xacro:fingertip side="right" mass="0.1095" cx="0.02092" cy="-0.00054" cz="0.15046" ixx="1.0322e-04" iyy="8.4868e-05" izz="5.4431e-05" ixy="8.0138e-08" ixz="-7.6890e-06" iyz="-1.7559e-08" b0x="0.01700" b12x="0.02600" b12sx="0.0500" bsy="0.0600" b3x="0.01952" b3sx="0.0430"/>
    </xacro:if>

    <!-- The flat jaws.  No nesting and no overlap at closed: the two faces stay
         0.595 mm apart because they cannot be driven together (see above), so
         these boxes never meet.  They are 32 mm wide the whole way up, the
         shank width, so this pair is 18 mm narrower per side than the scoops -
         it reaches into places the bucket cannot, and it holds 8 g more per
         jaw because the section is solid rather than a shell. -->
    <xacro:if value="${finger_type == 'maintenance'}">
        <xacro:fingertip side="left" mass="0.1181" cx="-0.01580" cy="-0.00082" cz="0.15379" ixx="1.0147e-04" iyy="8.3624e-05" izz="3.7650e-05" ixy="-9.6587e-09" ixz="-5.5230e-06" iyz="-2.6080e-07" b0x="-0.01700" b12x="-0.01700" b12sx="0.0320" bsy="0.0440" b3x="-0.01368" b3sx="0.0254"/>
        <xacro:fingertip side="right" mass="0.1189" cx="0.01590" cy="-0.00058" cz="0.15395" ixx="1.0201e-04" iyy="8.4198e-05" izz="3.7985e-05" ixy="-2.3087e-08" ixz="5.2565e-06" iyz="6.1955e-08" b0x="0.01700" b12x="0.01700" b12sx="0.0320" bsy="0.0440" b3x="0.01383" b3sx="0.0257"/>
    </xacro:if>

    <!-- A finger_type with no branch above would leave the gripper with no jaws
         at all, and an arm that ends at the racks reads in RViz as a mesh that
         failed to load. Fail at build time instead. -->
    <xacro:if value="${finger_type not in ('bucket', 'maintenance')}">
        <xacro:finger_type_must_be_bucket_or_maintenance/>
    </xacro:if>
    <!-- ==================== TCP ==================== -->
    <!-- Held at gripper_v2's 0.15 m so the SRDF chain and every cached pose
         stay valid across a gripper swap. It is a reference frame, not the
         contact point: the jaws span z = 115 to 208 mm and meet at 208. -->
    <link name="gripper_tcp"/>

    <joint name="gripper_tcp_joint" type="fixed">
        <parent link="arm_gripper_base_link"/>
        <child link="gripper_tcp"/>
        <origin xyz="0.0 0.0 0.15" rpy="0.0 0.0 0.0"/>
    </joint>

    <!-- Gripper camera (D435i). The bracket is modelled in neither base mesh,
         but this mount's camera holes sit 18.2 mm further out in +Y than v2's
         (65.27 mm from the flange axis against 47.08), so the pose is NOT the
         one gripper_camera.xacro carries by default and is overridden here. -->
    <xacro:property name="gripper_camera_y" value="0.065274"/>
    <xacro:include filename="gripper_camera.xacro" />

</robot>
