shreyaspatel3010/aries/src/aries/urdf/gripper_v2.xacro

<?xml version="1.0"?>
<robot xmlns:xacro="http://www.ros.org/wiki/xacro">

    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
    <xacro:property name="gripper_joint_lower_limit" value="${-1.62 if gripper_hardware_protocol == 'gazebo' else -1.57}"/>
    <xacro:property name="gripper_joint_upper_limit" value="${0.12 if gripper_hardware_protocol == 'gazebo' else 0.07}"/>

    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
    <xacro:property name="gripper_bucket_joint_lower_limit" value="${-gripper_joint_upper_limit}"/>
    <xacro:property name="gripper_bucket_joint_upper_limit" value="${-gripper_joint_lower_limit}"/>

    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
    <xacro:property name="fourbar_zero_psi" value="${radians(11.3428)}"/>
    <xacro:property name="fourbar_bar" value="0.050"/>
    <xacro:property name="fourbar_tip_x" value="${fourbar_bar * sin(fourbar_zero_psi)}"/>
    <xacro:property name="fourbar_tip_z" value="${fourbar_bar * cos(fourbar_zero_psi)}"/>

    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
    <xacro:property name="finger_mesh_left" value="gripper_${finger_type}_left.stl"/>
    <xacro:property name="finger_mesh_right" value="gripper_${finger_type}_right.stl"/>

    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
    <xacro:property name="finger_mass" value="${0.0277 if finger_type == 'probe' else (0.0417 if finger_type == 'bucket' else 0.0187)}"/>
    <xacro:property name="finger_com_x" value="${0.01892 if finger_type == 'probe' else (0.00745 if finger_type == 'bucket' else 0.01748)}"/>
    <xacro:property name="finger_com_z" value="${0.05805 if finger_type == 'probe' else (0.05483 if finger_type == 'bucket' else 0.04608)}"/>
    <xacro:property name="finger_ixx" value="${2.343e-05 if finger_type == 'probe' else (3.531e-05 if finger_type == 'bucket' else 1.338e-05)}"/>
    <xacro:property name="finger_iyy" value="${2.362e-05 if finger_type == 'probe' else (3.110e-05 if finger_type == 'bucket' else 1.468e-05)}"/>
    <xacro:property name="finger_izz" value="${3.462e-06 if finger_type == 'probe' else (1.619e-05 if finger_type == 'bucket' else 1.999e-06)}"/>
    <xacro:property name="finger_ixz" value="${-5.067e-06 if finger_type == 'probe' else (4.309e-07 if finger_type == 'bucket' else -4.098e-06)}"/>

    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
    <xacro:macro name="gripper_inertial" params="mass cx cy cz ixx iyy izz ixy:=0 ixz:=0 iyz:=0">
        <inertial>
            <origin xyz="${cx} ${cy} ${cz}" rpy="0 0 0"/>
            <mass value="${mass}"/>
            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
        </inertial>
    </xacro:macro>

    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
    <xacro:macro name="gripper_mesh_geometry" params="file">
        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
    </xacro:macro>

    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
    <xacro:property name="finger_col0_sx" value="${0.0262 if finger_type == 'probe' else (0.0269 if finger_type == 'bucket' else 0.0261)}"/>
    <xacro:property name="finger_col0_sy" value="${0.0150 if finger_type == 'probe' else (0.0151 if finger_type == 'bucket' else 0.0150)}"/>
    <xacro:property name="finger_col0_sz" value="${0.0335 if finger_type == 'probe' else (0.0369 if finger_type == 'bucket' else 0.0331)}"/>
    <xacro:property name="finger_col0_x" value="${0.00812 if finger_type == 'probe' else (0.00847 if finger_type == 'bucket' else 0.00803)}"/>
    <xacro:property name="finger_col0_y" value="${0.0 if finger_type == 'probe' else (0.00001 if finger_type == 'bucket' else 0.0)}"/>
    <xacro:property name="finger_col0_z" value="${0.01180 if finger_type == 'probe' else (0.01346 if finger_type == 'bucket' else 0.01165)}"/>
    <xacro:property name="finger_col1_sx" value="${0.0173 if finger_type == 'probe' else (0.0452 if finger_type == 'bucket' else 0.0174)}"/>
    <xacro:property name="finger_col1_sy" value="${0.0300 if finger_type == 'probe' else (0.0502 if finger_type == 'bucket' else 0.0150)}"/>
    <xacro:property name="finger_col1_sz" value="${0.0335 if finger_type == 'probe' else (0.0369 if finger_type == 'bucket' else 0.0331)}"/>
    <xacro:property name="finger_col1_x" value="${0.01627 if finger_type == 'probe' else (0.00537 if finger_type == 'bucket' else 0.01588)}"/>
    <xacro:property name="finger_col1_y" value="${0.0 if finger_type == 'probe' else (-0.00009 if finger_type == 'bucket' else 0.0)}"/>
    <xacro:property name="finger_col1_z" value="${0.04525 if finger_type == 'probe' else (0.05033 if finger_type == 'bucket' else 0.04479)}"/>
    <xacro:property name="finger_col2_sx" value="${0.0217 if finger_type == 'probe' else (0.0483 if finger_type == 'bucket' else 0.0216)}"/>
    <xacro:property name="finger_col2_sy" value="${0.0300 if finger_type == 'probe' else (0.0502 if finger_type == 'bucket' else 0.0150)}"/>
    <xacro:property name="finger_col2_sz" value="${0.0335 if finger_type == 'probe' else (0.0369 if finger_type == 'bucket' else 0.0331)}"/>
    <xacro:property name="finger_col2_x" value="${0.02568 if finger_type == 'probe' else (0.00857 if finger_type == 'bucket' else 0.02522)}"/>
    <xacro:property name="finger_col2_y" value="${0.0 if finger_type == 'probe' else (-0.00013 if finger_type == 'bucket' else 0.0)}"/>
    <xacro:property name="finger_col2_z" value="${0.07870 if finger_type == 'probe' else (0.08721 if finger_type == 'bucket' else 0.07793)}"/>

    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
    <xacro:macro name="finger_geometry" params="file sx">
        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
    </xacro:macro>

    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
    <xacro:property name="fourbar_joint_damping" value="0.01"/>
    <xacro:property name="fourbar_joint_friction" value="0.001"/>

    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
    <joint name="arm_gripper_base_joint" type="fixed">
        <parent link="link6"/>
        <child link="arm_gripper_base_link"/>
        <origin xyz="0.0 0.0 0.0522" rpy="0.0 0.0 3.141592653589793"/>
    </joint>

    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
    <link name="arm_gripper_base_link">
        <xacro:gripper_inertial mass="0.2957" cx="-0.00033" cy="-0.00513" cz="0.04977" ixx="4.228e-04" iyy="3.976e-04" izz="2.278e-04" ixy="2.038e-06" ixz="5.816e-07" iyz="5.046e-05"/>
        <xacro:gripper_mesh_geometry file="gripper_base.stl"/>
    </link>

    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
    <link name="gripper_gear_left_link">
        <xacro:gripper_inertial mass="0.0269" cx="-0.00160" cy="0.00749" cz="0.00795" ixx="1.222e-05" iyy="1.256e-05" izz="6.137e-06" ixy="-4.439e-07" ixz="1.272e-06" iyz="2.212e-06"/>
        <xacro:gripper_mesh_geometry file="gripper_gear_left.stl"/>
    </link>

    <joint name="gripper_gear_left_joint" type="revolute">
        <parent link="arm_gripper_base_link"/>
        <child link="gripper_gear_left_link"/>
        <origin xyz="-0.024250 0.0 0.090470" rpy="0.0 0.0 0.0"/>
        <axis xyz="0 1 0"/>
        <limit effort="500" velocity="1.0" lower="${gripper_joint_lower_limit}" upper="${gripper_joint_upper_limit}"/>
        <dynamics damping="${fourbar_joint_damping}" friction="${fourbar_joint_friction}"/>
    </joint>

    <link name="gripper_gear_right_link">
        <xacro:gripper_inertial mass="0.0269" cx="0.00159" cy="0.00749" cz="0.00795" ixx="1.222e-05" iyy="1.256e-05" izz="6.137e-06" ixy="4.438e-07" ixz="-1.272e-06" iyz="2.212e-06"/>
        <xacro:gripper_mesh_geometry file="gripper_gear_right.stl"/>
    </link>

    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
    <joint name="gripper_gear_right_joint" type="revolute">
        <parent link="arm_gripper_base_link"/>
        <child link="gripper_gear_right_link"/>
        <origin xyz="0.024250 0.0 0.090470" rpy="0.0 0.0 0.0"/>
        <axis xyz="0 -1 0"/>
        <limit effort="500" velocity="1.0" lower="${gripper_joint_lower_limit}" upper="${gripper_joint_upper_limit}"/>
        <dynamics damping="${fourbar_joint_damping}" friction="${fourbar_joint_friction}"/>
        <mimic joint="gripper_gear_left_joint" multiplier="1.0" offset="0.0"/>
    </joint>

    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
    <link name="gripper_left_link">
        <xacro:gripper_inertial mass="0.0107" cx="-0.00492" cy="-0.00005" cz="0.02451" ixx="5.063e-06" iyy="3.512e-06" izz="1.967e-06" ixz="6.473e-07"/>
        <xacro:gripper_mesh_geometry file="gripper_coupler_left.stl"/>
    </link>

    <joint name="gripper_link_left_joint" type="revolute">
        <parent link="arm_gripper_base_link"/>
        <child link="gripper_left_link"/>
        <origin xyz="-0.007500 0.0 0.121200" rpy="0.0 0.0 0.0"/>
        <axis xyz="0 1 0"/>
        <limit effort="500" velocity="1.0" lower="${gripper_joint_lower_limit}" upper="${gripper_joint_upper_limit}"/>
        <dynamics damping="${fourbar_joint_damping}" friction="${fourbar_joint_friction}"/>
        <mimic joint="gripper_gear_left_joint" multiplier="1.0" offset="0.0"/>
    </joint>

    <link name="gripper_right_link">
        <xacro:gripper_inertial mass="0.0107" cx="0.00492" cy="-0.00005" cz="0.02451" ixx="5.063e-06" iyy="3.512e-06" izz="1.967e-06" ixz="-6.472e-07"/>
        <xacro:gripper_mesh_geometry file="gripper_coupler_right.stl"/>
    </link>

    <joint name="gripper_link_right_joint" type="revolute">
        <parent link="arm_gripper_base_link"/>
        <child link="gripper_right_link"/>
        <origin xyz="0.007500 0.0 0.121200" rpy="0.0 0.0 0.0"/>
        <axis xyz="0 -1 0"/>
        <limit effort="500" velocity="1.0" lower="${gripper_joint_lower_limit}" upper="${gripper_joint_upper_limit}"/>
        <dynamics damping="${fourbar_joint_damping}" friction="${fourbar_joint_friction}"/>
        <mimic joint="gripper_gear_left_joint" multiplier="1.0" offset="0.0"/>
    </joint>

    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
    <xacro:macro name="fourbar_tip" params="name parent sign">
        <link name="${name}_link">
            <inertial>
                <origin xyz="0 0 0" rpy="0 0 0"/>
                <mass value="0.001"/>
                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
            </inertial>
        </link>
        <joint name="${name}_joint" type="fixed">
            <parent link="${parent}"/>
            <child link="${name}_link"/>
            <origin xyz="${sign * fourbar_tip_x} 0.0 ${fourbar_tip_z}" rpy="0.0 0.0 0.0"/>
        </joint>
    </xacro:macro>

    <xacro:fourbar_tip name="gripper_gear_tip_left" parent="gripper_gear_left_link" sign="-1"/>
    <xacro:fourbar_tip name="gripper_gear_tip_right" parent="gripper_gear_right_link" sign="1"/>
    <xacro:fourbar_tip name="gripper_link_tip_left" parent="gripper_left_link" sign="-1"/>
    <xacro:fourbar_tip name="gripper_link_tip_right" parent="gripper_right_link" sign="1"/>

    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
    <link name="gripper_bucket_left_link">
        <xacro:gripper_inertial mass="${finger_mass}" cx="${finger_com_x}" cy="0.0" cz="${finger_com_z}" ixx="${finger_ixx}" iyy="${finger_iyy}" izz="${finger_izz}" ixz="${finger_ixz}"/>
        <xacro:finger_geometry file="${finger_mesh_left}" sx="1"/>
    </link>

    <joint name="gripper_bucket_left_joint" type="revolute">
        <parent link="gripper_gear_tip_left_link"/>
        <child link="gripper_bucket_left_link"/>
        <origin xyz="0.0 0.0 0.0" rpy="0.0 0.0 0.0"/>
        <axis xyz="0 1 0"/>
        <limit effort="500" velocity="1.0" lower="${gripper_bucket_joint_lower_limit}" upper="${gripper_bucket_joint_upper_limit}"/>
        <dynamics damping="${fourbar_joint_damping}" friction="${fourbar_joint_friction}"/>
        <mimic joint="gripper_gear_left_joint" multiplier="-1.0" offset="0.0"/>
    </joint>

    <link name="gripper_bucket_right_link">
        <xacro:gripper_inertial mass="${finger_mass}" cx="${-finger_com_x}" cy="0.0" cz="${finger_com_z}" ixx="${finger_ixx}" iyy="${finger_iyy}" izz="${finger_izz}" ixz="${-finger_ixz}"/>
        <xacro:finger_geometry file="${finger_mesh_right}" sx="-1"/>
    </link>

    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
    <joint name="gripper_bucket_right_joint" type="revolute">
        <parent link="gripper_gear_tip_right_link"/>
        <child link="gripper_bucket_right_link"/>
        <origin xyz="0.0 0.0 0.0" rpy="0.0 0.0 0.0"/>
        <axis xyz="0 -1 0"/>
        <limit effort="500" velocity="1.0" lower="${gripper_bucket_joint_lower_limit}" upper="${gripper_bucket_joint_upper_limit}"/>
        <dynamics damping="${fourbar_joint_damping}" friction="${fourbar_joint_friction}"/>
        <mimic joint="gripper_gear_left_joint" multiplier="-1.0" offset="0.0"/>
    </joint>
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
