shreyaspatel3010/aries/firmware/teensy_drill_sys/include/pins.h

// Teensy 4.1 pin map for the drill / science board.
//
// THIS FILE IS THE ONLY PLACE A PIN NUMBER APPEARS. main.cpp used to carry its
// own #defines, all of them 0, with the real numbers sitting in an untracked
// src/pin-def-ref.txt that nothing included -- so the firmware as shipped drove
// pin 0 for every motor, every light and the servo. Pin 0 is also Serial1 RX.
// Keep every number here and that class of drift cannot come back.
//
// See PINOUT.md for the wiring table, the harness colours, and what is still
// unconfirmed. Change a number here, change it there.
//
// TEENSY 4.1 CONSTRAINTS THIS MAP RESPECTS
//   - Pin 13 is LED_BUILTIN. main.cpp blinks it as the agent-status and
//     unassigned-pin indicator, so nothing else may claim it.
//   - Pins 0 and 1 are Serial1 RX/TX. PIN 1 IS THE GRIPPER PIN, whichever
//     gripper is fitted: ST3215_BUS (Serial1 half duplex) or GRIPPER_SERVO
//     (hobby-servo pulses), chosen at build time -- see "WHICH GRIPPER IS
//     BOLTED ON" below. Pin 0 is still free, and has to stay that way while
//     the bus build exists, because Serial1.begin() would claim it in any mode
//     but half duplex.
//   - Every digital pin on a Teensy 4.x is interrupt-capable, so the limit
//     switches are not constrained to a special subset the way they would be
//     on an AVR.
//   - The PWM pins here (25, 15, 22) are all PWM-capable. analogWriteFrequency
//     sets the frequency of the whole timer submodule a pin belongs to, not the
//     pin -- but all three drivers ask for the same 10 kHz in
//     Driver::init_driver(), so a shared timer is harmless. It would NOT be if
//     one of them ever wanted a different frequency. From pwm_pin_info[] in the
//     core's cores/teensy4/pwm.c the three land on three different peripherals
//     -- 25 = FlexPWM1_3_X, 15 = QuadTimer3_3, 22 = FlexPWM4_0_A -- so nothing
//     shares a submodule today.
//   - PIN 25 IS AN X CHANNEL, not the A or B the other PWM pins use. That is
//     fine: flexpwmWrite() handles `case 0: // X` by writing VAL0, so
//     analogWrite() drives it properly. Unlike pin 38, which has no PWM at all
//     on a 4.1.
//   - PINS 7, 8 AND 25 ARE ALL ON FLEXPWM1 SUBMODULE 3. Harmless as written --
//     only 25 is driven as PWM, 8 is a plain digitalWrite direction pin and 7
//     is an INPUT_PULLUP limit switch, and neither cares what frequency that
//     submodule runs at. It stops being harmless if anything ever calls
//     analogWrite() on 7 or 8, so do not put a second PWM function there.

#ifndef PINS_H
#define PINS_H

// Sentinel for "no number has been established for this yet". 255 is not a
// valid Teensy pin, and Driver/LimitSwitch/SlewServo all refuse to
// initialise on it rather than quietly configuring pin 255 -- see
// PIN_IS_ASSIGNED below and its use in drill.cpp.
//
// Deliberately NOT 0: 0 is a real pin (Serial1 RX), so a forgotten 0 configures
// hardware and looks like it worked. Every unassigned pin in this file has bitten
// somebody already in exactly that way.
#define PIN_UNASSIGNED 255
#define PIN_IS_ASSIGNED(p) ((p) != PIN_UNASSIGNED)

// --- Drill motors -----------------------------------------------------------
// Both are DC motors behind an H-bridge: one PWM pin for speed, two direction
// pins. Numbers are the embedded team's own, from the pin-def-ref.txt that
// shipped alongside the firmware.
//
// THE AUGER -- the bit that spins and cuts. It does not travel.
//
// MOVED TO 25 / 8 / 9 ON 2026-08-29, from 22 / 19 / 18. THE PROVENANCE OF THE
// NEW NUMBERS IS NOT RECORDED -- they arrived as an edit to this file with no
// bench note attached, so unlike the numbers they replaced there is nothing
// here saying anybody metered them. PINOUT.md marks this row unconfirmed for
// that reason. If they did come off the bench, say so there and here.
//
// The sample bin took the three pins this vacated; see BIN_* below.
//
// WHAT THE OLD NUMBERS HAD BEHIND THEM, kept because it is what this row has to
// be re-confirmed against: 22 / 19 / 18 was confirmed from the bench on
// 2026-08-26 and was exactly what pin-def-ref.txt said all along. That briefly
// looked stale when an interim bench report put the SAMPLE BIN's PWM on 22,
// colliding with the auger, and the auger's PWM was set PIN_UNASSIGNED while it
// was resolved. It resolved the other way: the bin went to 28 and the file was
// right about the auger. (The bin IS on 22 now -- but by this later change, not
// by that report being right.)
#define AUGER_PWM 25
#define AUGER_INA 8
#define AUGER_INB 9

// THE FEED CARRIAGE -- the lead screw that moves the WHOLE DRILL up and down
// (drill_motor_joint, prismatic on Z, -0.375 .. +0.185). This is the vertical
// axis, despite the URDF calling it "motor" and the auger "bit".
//
// INA/INB SWAPPED 2026-08-27 (was 41 / 40). POSITIVE PWM MUST DRIVE THE
// CARRIAGE UP, and on the bench it drove it DOWN. That sign is not cosmetic:
// apply_motor_commands() picks WHICH SWITCH to consult from it --
//
//     feed_pwm > 0  ->  switch_feed_top
//     feed_pwm < 0  ->  switch_feed_bottom
//
// -- so a reversed bridge does not merely invert the pad, it points the gate at
// the far end of the travel. The carriage then climbs into the TOP switch while
// the firmware is watching the BOTTOM one, and neither switch ever stops
// anything. That is what "limit switches not working" was on 2026-08-27.
//
// FIX IT HERE, NOT ON THE HOST. Inverting in joystick.yaml or drill_driver.yaml
// makes the pad feel right and leaves the gate pointed the wrong way, because
// both of those sit ABOVE the sign the firmware gates on. Driver::drive() maps
// dir=true to INA HIGH / INB LOW, so exchanging these two numbers is exactly
// equivalent to swapping the motor's two leads at the bridge.
#define FEED_PWM 15
#define FEED_INA 40
#define FEED_INB 41

// --- Sample-bin linear actuator ---------------------------------------------
// The bin rides its rails between q = 0 (parked forward of the mast) and
// q = -0.1304 (back under the auger); see aries/urdf/drill.xacro and the
// aries_load_cells README, which depends on knowing which end it is at.
//
// MOVED TO 22 / 19 / 18 ON 2026-08-29, from 28 / 30 / 29 -- the three pins the
// auger vacated in the same change. 22 is PWM-capable (FlexPWM4_0_A). AS WITH
// THE AUGER, THE PROVENANCE OF THESE NUMBERS IS NOT RECORDED here, and PINOUT.md
// marks the row unconfirmed.
//
// 28, 29 and 30 were free for one day, and went into kScanPins in main.cpp
// for it. THE PUMP TOOK ALL THREE ON 2026-08-30 and they came back out of
// that list again -- see the pump block below. They are not scanned now.
//
// The numbers this replaced, 28 / 30 / 29, were confirmed from the bench on
// 2026-08-26. Before that they were proposals (23/21/20, then 22/21/20);
// nothing about those earlier ones survives.
#define BIN_PWM 22
#define BIN_INA 19
#define BIN_INB 18

// --- Peristaltic pump --------------------------------------------------------
// New from the embedded team, 2026-08-30. A DC motor on an H-bridge, driven in
// millilitres: `pump/state` picks draw / release / home and the firmware runs
// the motor for however long that volume takes at a measured flow rate. There
// is no flow sensor, so a commanded volume is a timer, not a measurement.
//
// `pump/purge` (Float32 SECONDS) is the reverse run that empties the tube. Same
// bridge, same pins, opposite direction to a draw -- see Pump::kDirPurge.
//
// 28 / 29 / 30, VERBATIM FROM UPSTREAM, and they drop straight in.
//
// These three used to be the SAMPLE BIN's, and upstream's pin block still has
// the bin on them too -- `LINACT_PWM 28 / LINACT_INA 30 / LINACT_INB 29`,
// the same three pins with the direction pair swapped, with both objects
// constructed and both initialised in their setup(). On their board the bin and
// the pump share one H-bridge and drive it in opposite directions. It is only
// harmless here because the bin MOVED to 22 / 19 / 18 on 2026-08-29, which
// vacated exactly this group.
//
// The static_assert at the bottom of this file is what makes that safe to rely
// on rather than hope about: put the bin back on 28 and the build fails instead
// of the two mechanisms fighting over a bridge at runtime.
//
// 28 is PWM-capable on a Teensy 4.1, which Driver::init_driver() needs -- it
// calls analogWriteFrequency() on the PWM pin. (The lid servo on 38 does not
// need that, because the Servo library bit-bangs; a motor driver does.)
//
// REMOVED FROM kScanPins in main.cpp, all three. They went into the diagnostic
// scan when the bin vacated them, and a pin that is both scanned and driven
// gets configured INPUT_PULLUP by setup() and then taken back as an OUTPUT --
// with the scan reporting the driver's own switching as a phantom switch.
#define PUMP_PWM 28
#define PUMP_INA 29
#define PUMP_INB 30

// --- Limit switches ---------------------------------------------------------
// Wired to GND through the switch and read INPUT_PULLUP, so CLOSED reads LOW
// and the ISR fires on FALLING. A disconnected switch therefore reads HIGH --
// "not at the stop" -- which is the unsafe-failing direction. That is a
// property of the harness, not of this file; it is called out in PINOUT.md so
// the person holding the loom knows to expect it.
//
// BOTH SWITCHES ARE ON THE FEED CARRIAGE, one at each end of its travel. The
// firmware as delivered stopped the auger on switch 1 and the feed on switch
// 2, which does not match the mechanism: the auger is a spindle and has
// no end of travel to reach. drill_joystick.py has had the correct model all
// along -- "drill_motor has one at each end of its travel, bottom and top".
//
// 7 = BOTTOM, 6 = TOP. MEASURED, 2026-08-27, and these are the first numbers
// here that were not somebody's guess: with drill/pin_scan running, each switch
// was pressed by hand and the board reported which pin moved. 2 / 3 came from
// pin-def-ref.txt, and 4 / 5 replaced them the same day on a bench report --
// both were wrong, and nothing could tell, because a limit switch on the wrong
// pin is SILENT. An INPUT_PULLUP pin reads HIGH whether the switch is open or
// the pin is connected to nothing at all, so "wrong pin" and "carriage
// mid-travel" are the same reading. Three pin numbers were tried blind before
// the board was simply asked. Ask it: scripts/check_drill_limits.py.
//
// NORMALLY OPEN, switching to GND, exactly as described above -- confirmed by
// the same test: both pins rest HIGH and go LOW while the switch is held. So
// is_at_stop()'s digitalRead(pin) == LOW is the right sense, and the FALLING
// interrupt edge is the closure. (Pins 14, 21, 24 and 27 DO rest low on this
// harness; they are something else's, and are not these switches. Pin 9 was on
// that list too and is now AUGER_INB -- consistent with its having been an
// H-bridge input on the loom all along, but that is an observation and NOT
// confirmation of the 2026-08-29 auger map.)
//
// The BIN's two switches are not in this map. The mechanism has four switches
// across two axes; the firmware has two instances (LIMIT_SWITCH_INSTANCES in
// drill.h, which caps the ISR router table). Wiring the bin's pair needs that
// constant raised to 4 and two more routers added. Until then the bin is
// dead-reckoned, exactly as the aries_load_cells README describes.
#define LIMIT_SWITCH1 7  // feed carriage, BOTTOM of travel
#define LIMIT_SWITCH2 6  // feed carriage, TOP of travel

// --- Stack light ------------------------------------------------------------
// Three GPIOs, one per tier, on the mast. ACTIVE LOW: the driver sinks current,
// so LOW lights the tier and HIGH darkens it. The retired sketch was active
// HIGH on different pins -- both halves of that changed at once, which is why
// StackLight::state() is written against the host's colour codes rather than
// the firmware's original ones. See emg.cpp.
#define STALIG_G 37
#define STALIG_Y 36
#define STALIG_R 35

// --- WHICH GRIPPER IS BOLTED ON ---------------------------------------------
//
// BOTH GRIPPERS LIVE ON PIN 1. Only one is ever on the flange, so they share
// the pin rather than each holding one hostage:
//
//   GRIPPER_KIND_ST3215  pin 1 = Serial1 half duplex, the bus servo (default)
//   GRIPPER_KIND_V2      pin 1 = a hobby-servo pulse train, the four-bar
//
// They CANNOT coexist -- one is a UART, the other a bit-banged pulse train on
// the same pad -- so this is a build-time choice, selected in platformio.ini.
// Swapping grippers already means unbolting hardware and rewiring (the ST3215
// wants 12 V on its bus, the four-bar 5 V), so a reflash costs nothing extra.
// It is one PIN they share, never one connector.
//
// HOW THE UNSELECTED ONE IS DISABLED: its pin becomes PIN_UNASSIGNED. That is
// this file's existing idiom, not a new mechanism -- SlewServo's constructor
// sets m_usable from PIN_IS_ASSIGNED and every method early-returns when it is
// false (drill.cpp:224), and the collision check below already exempts
// PIN_UNASSIGNED. So main.cpp needs no conditionals at all: the object still
// exists, still subscribes, and simply drives nothing.
#if defined(GRIPPER_KIND_ST3215) && defined(GRIPPER_KIND_V2)
#error "Define only one of GRIPPER_KIND_ST3215 / GRIPPER_KIND_V2 -- they share pin 1."
#endif
#if !defined(GRIPPER_KIND_ST3215) && !defined(GRIPPER_KIND_V2)
// Default is what is actually fitted. Override in platformio.ini.
#define GRIPPER_KIND_ST3215 1
#endif

// --- Servos -----------------------------------------------------------------
// MOVED TO 23 on 2026-08-26. Was pin 9 in both retired sketches
// (teensy_gripper.ino and legacy_controller.ino) and for the whole life of this
// firmware before that, so a board wired to the old loom drives NOTHING on the
// gripper and instead pulses whatever now sits on pin 9. Check the servo lead
// before powering the drill.
//
// 23 had been the bin actuator's proposed PWM until this change. PIN 9 IS NOT A
// SPARE ANY MORE: since 2026-08-29 it is AUGER_INB, so an old-loom gripper lead
// now feeds a direction input on the auger's H-bridge.
// MOVED TO 1 ON 2026-09-01, sharing the pin with the bus servo -- see "WHICH
// GRIPPER IS BOLTED ON" above. PIN 23 IS NOW FREE and has gone back into
// kScanPins in main.cpp, as freeing a pin requires.
//
// A board wired to the 23 loom drives nothing on the gripper until the lead is
// moved to pin 1. That is the same hazard as the 2026-08-26 move off pin 9,
// and it bites in the same way: silently.
#if defined(GRIPPER_KIND_V2)
#define GRIPPER_SERVO 1
#else
#define GRIPPER_SERVO PIN_UNASSIGNED
#endif

// --- ST3215 bus servo (secondary gripper) -----------------------------------
// The single-wire half-duplex TTL bus the ST3215 gripper servo answers on, at
// 1 Mbaud. NOT the same thing as GRIPPER_SERVO above: that is a hobby servo
// taking a PWM pulse train, this is a packet protocol on a shared data line.
//
// 1 IS SERIAL1 TX, AND THAT IS THE POINT. In single-wire half-duplex the LPUART
// drives and reads the SAME pin, and the pin it uses is TX. So the bus wire
// goes to 1, and pin 0 -- Serial1's RX -- is not part of this and stays free.
//
//     Serial1.begin(1000000, SERIAL_8N1_HALF_DUPLEX);
//
// HALF DUPLEX IS NOT OPTIONAL, but on Serial1 the reason is the bus, not this
// board: an ST3215 has one data wire, and a full-duplex UART would drive it
// while trying to listen on a separate pin that does not exist. It is worth
// knowing that Serial1 is the forgiving choice here -- on Serial6 the same
// mistake would have been silent and destructive, because Serial6's RX pin is
// 25, which is AUGER_PWM. Verified in the core rather than assumed: the entire
// RX-pin configuration block sits inside `if (!half_duplex_mode_)`
// (cores/teensy4/HardwareSerial.cpp:145-152), so half-duplex never touches the
// RX pad, and full duplex claims it.
//
// THE COLLISION CHECK AT THE BOTTOM OF THIS FILE CANNOT SEE A UART'S RX PIN. It
// compares the numbers written down here, and Serial1.begin() would take pin 0
// without any #define naming it. Harmless today because pin 0 is free -- but if
// pin 0 is ever given a job, this bus is the thing that silently collides with
// it, and the build will not say so.
//
// The core enables the pad's internal ~22k pull-up in half-duplex mode
// (HardwareSerial.cpp:154-157; only cleared for TXINVERT, which we do not ask
// for). That is weak for 1 Mbaud over a harness -- add an external 2.2k-4.7k
// pull-up to the bus logic rail if the line looks slow on a scope.
//
// REMOVED FROM kScanPins IN main.cpp, as taking any pin requires. A pin that is
// both scanned and driven gets configured INPUT_PULLUP by setup() and then
// taken back by the UART, with the scan reporting the bus traffic as a phantom
// switch -- the same trap the lid servo on 38 and the pump pins hit. The two
// lists have to stay disjoint and nothing checks that they are.
//
// NOT WIRED YET. Unlike pins 14, 21, 24 and 27 -- see the limit-switch note
// above -- pin 1 was NOT among those measured resting low on this harness, so
// nothing is known to be on it. Meter it before connecting anyway.
//
// LEVEL. A Teensy 4.1 pin is 3.3 V and is NOT 5 V tolerant. Measure the idle
// voltage on the servo's signal line before wiring it to this pin: 3.3 V is a
// direct connection, 5 V needs a bidirectional level shifter. The servo's 12 V
// supply must NEVER reach the Teensy -- only signal and a shared ground.
#if defined(GRIPPER_KIND_ST3215)
#define ST3215_BUS 1
#else
#define ST3215_BUS PIN_UNASSIGNED
#endif

// Lid of the FRONT-LEFT deck container -- the sand sample box, which the rest
// of the workspace calls `sand_box` (aries_load_cells/config/load_cells.yaml:
// "front-left deck box, the sand sample"). The box behind it, also on the
// left, is `stone_box` and has no lid servo.
//
// IF THIS IS THE WRONG BOX, this define and the topic name in main.cpp are the
// only two places to change. The identification came from the load-cell table,
// not from the hardware.
//
// PIN 38 SINCE 2026-08-29. It was 10 for the whole life of this firmware, and
// before that 9, next to the gripper servo.
//
// 38 IS NOT A PWM PIN ON A TEENSY 4.1, AND THAT DOES NOT MATTER. FlexPWM1_2
// reaches pin 38 on a Teensy 4.0; on the 4.1 that pad is pins 46/47 instead
// (see the table in the core's pwm.c). Nothing here needs it: the Teensy Servo
// library does not use PWM hardware at all -- Servo::attach() does
// pinMode(pin, OUTPUT) and the pulses are bit-banged with digitalWrite from a
// timer ISR, so any digital pin works. analogWrite() on this pin would NOT
// work, and nothing calls it here.
//
// 38 IS ALSO A PIN THE DIAGNOSTIC SCAN USED TO WATCH. It was in kScanPins in
// main.cpp -- the list of otherwise-unused pins the board reports on
// drill/pin_scan -- and it has been removed from it. Leaving it there would
// have had setup() configure it INPUT_PULLUP, Servo::attach() then take it back
// as an OUTPUT, and pin_scan_state() read the servo's own pulse train back as
// "something is pulling this pin low", flickering a diagnostic bit at 50 Hz
// forever. ADD THE PIN YOU FREE, AND REMOVE THE PIN YOU TAKE: the two lists
// have to stay disjoint and nothing checks that they are.
//
// A CONTINUOUS-ROTATION SERVO, NOT A POSITIONAL ONE, also since 2026-08-29. It
// is driven by LidServo rather than SlewServo and takes a SPEED in -1..1, not
// an angle. See the LidServo comment in drill.h, and LID_SERVO_NEUTRAL_US
// below.
#define LID_SERVO_SAND_BOX 38

// THE PULSE WIDTH AT WHICH THE LID SERVO ACTUALLY HOLDS STILL, in microseconds.
//
// NOT A CONSTANT OF THE PART -- it is a property of THIS INDIVIDUAL SERVO, set
// by how its centring potentiometer was trimmed on the line, and 1500 is only
// where they cluster. It is the one number here that cannot be looked up, and
// it is the first thing to check if the lid creeps with the stick released:
// creep at rest is this number being wrong and is nothing else.
//
// To trim it: `ros2 topic pub --once /sand_box/lid/cmd std_msgs/Float32
// "data: 0.0"`, watch the horn, and move this up or down 10 us at a time until
// it is genuinely still. It needs a reflash each time -- see the note in
// drill.h about what moving calibration into the firmware costs.
#define LID_SERVO_NEUTRAL_US 1500

// Offset from neutral that means full speed, in microseconds. 350-500 is the
// usual range for a hobby servo; 400 is upstream's value and is a starting
// point, not a measurement.
#define LID_SERVO_MAX_DEVIATION_US 400

// --- Load cells --------------------------------------------------------------
// Three HX711 amplifiers, CONFIRMED from the bench 2026-08-26.
//
// EACH CELL HAS ITS OWN CLOCK. This is not the usual one-shared-SCK chain --
// every amplifier gets a private DT/SCK pair, so they can be read
// independently and a dead amplifier cannot stall the others. Six pins, not
// four. Anything written against a shared clock (including an earlier draft of
// this file) is wrong.
//
// THE ORDER BELOW IS THE WIRE FORMAT. aries_load_cells expects one topic,
// `load_cells/raw` (std_msgs/Int32MultiArray), three elements, in the order of
// `cells` in aries_load_cells/config/load_cells.yaml:
//     ["sand_box", "stone_box", "drill_container"]
// The firmware sends no names to check itself against, so swapping two entries
// makes the sand box report the stone and nothing anywhere notices.
//
// RAW COUNTS, not kilograms. Scale and offset live in that package's YAML so a
// recalibration is an edit and a relaunch, not a reflash with the rover open.
//
// DRIVEN. main.cpp constructs one LoadCell per amplifier, in the order above,
// and publishes their counts on load_cells/raw at 10 Hz. A cell with no
// amplifier on its pins never blocks the board and never reports zero -- zero
// is what an empty box reads -- it reports the converter's negative rail, which
// the host already knows how to call a fault. See PINOUT.md.
#define HX711_SAND_BOX_DT 17          // front-left deck box, the sand sample
#define HX711_SAND_BOX_SCK 16
#define HX711_STONE_BOX_DT 34         // the box behind it, also on the left
#define HX711_STONE_BOX_SCK 33
#define HX711_DRILL_CONTAINER_DT 32   // the drill's sample bin
#define HX711_DRILL_CONTAINER_SCK 31

// --- COMPILE-TIME COLLISION CHECK -------------------------------------------
//
// Two functions on one pin is SILENT at runtime: whichever init() runs last
// wins the pin mode, and the other quietly drives, or reads, the wrong
// hardware. Nothing anywhere reports it.
//
// This is not hypothetical. On 2026-08-26 the gripper servo was moved from pin
// 9 to pin 23 -- which BIN_PWM already held. Caught by reading the file;
// the build would have been perfectly happy, and the symptom on the bench
// would have been a gripper that twitched whenever the sample bin moved.
//
// Add every new pin to kMap below. PIN_UNASSIGNED is exempt: several entries
// are legitimately unassigned and they all compare equal to each other.
#ifdef __cplusplus
namespace aries_pins
{
constexpr unsigned char kMap[] = {
    AUGER_PWM, AUGER_INA, AUGER_INB,
    FEED_PWM, FEED_INA, FEED_INB,
    BIN_PWM, BIN_INA, BIN_INB,
    PUMP_PWM, PUMP_INA, PUMP_INB,
    LIMIT_SWITCH1, LIMIT_SWITCH2,
    STALIG_G, STALIG_Y, STALIG_R,
    GRIPPER_SERVO, LID_SERVO_SAND_BOX,
    // ST3215_BUS is Serial1 TX. Serial1's RX pin (0) is not listed here
    // because nothing names it -- half duplex never claims it. See the
    // ST3215_BUS comment above.
    ST3215_BUS,
    HX711_SAND_BOX_DT, HX711_SAND_BOX_SCK,
    HX711_STONE_BOX_DT, HX711_STONE_BOX_SCK,
    HX711_DRILL_CONTAINER_DT, HX711_DRILL_CONTAINER_SCK,
    // LED_BUILTIN, spelled literally because pins.h does not include Arduino.h.
    // Here so that handing pin 13 to something else fails the build rather than
    // fighting the status LED.
    13,
};
constexpr int kCount = sizeof(kMap) / sizeof(kMap[0]);

constexpr bool no_pin_collision()
{
  for (int i = 0; i < kCount - 1; ++i)
    for (int j = i + 1; j < kCount; ++j)
      if (kMap[i] == kMap[j] && kMap[i] != PIN_UNASSIGNED)
        return false;
  return true;
}

static_assert(no_pin_collision(),
              "pins.h: two functions are mapped to the same Teensy pin. "
              "Compare the #defines above against PINOUT.md.");
} // namespace aries_pins
#endif // __cplusplus

#endif  // PINS_H
