shreyaspatel3010/aries/src/aries_moveit/moveit_config/config/gamepad.yaml

/**:
  ros__parameters:
    joy_topic: "joy"
    joint_state_topic: "joint_states"
    servo_status_topic: "servo_node/status"
    servo_command_type_service: "/servo_node/switch_command_type"
    gripper_command_topic: "rebel_gripper_controller/joint_trajectory"
    gripper_joint_name: "gripper_gear_left_joint"
    command_frame_id: "base_link"
    status_topic: "/arm_joystick/status"
    move_action_name: "move_action"
    planning_frame: "base_link"
    planning_group: "igus_rebel_arm"
    planning_link: "gripper_tcp"
    move_group_control_mode: "cartesian"

    # Frame the joystick's Cartesian jog is read in. Both arm nodes honour it
    # (rebel_servo_teleop_gamepad and rebel_movegroup_joystick).
    #
    #   "tool" - the axes of planning_link above (gripper_tcp). Its +Z runs out
    #            of the jaws along the approach and X/Y sit across them, so the
    #            left stick pushes the gripper the way it is pointing and the
    #            rotations spin about the gripper's own axes through the TCP.
    #            The stick means the same thing at every wrist pose, which is
    #            what makes lining a grasp up on the gripper camera workable.
    #   "base"  - planning_frame (base_link): +X is rover-forward and +Z is
    #            world-up regardless of where the gripper points. This was the
    #            behaviour before 2026-08-31.
    #
    # The Cartesian stick mapping FOLLOWS this key — "tool" transposes both
    # sticks, "base" restores the pre-2026-08-31 layout. See the axis block
    # further down, where both tables are written out.
    cartesian_frame: "tool"

    # NOTE: every speed/motion value in this file is overridden at launch by
    # config/teleop_speeds.yaml, which is loaded after it. Retune there —
    # editing the numbers here has no effect. What this file still owns is the
    # button/axis mapping, topic names, joint limits and frame names.
    linear_scale: 0.10
    angular_scale: 0.18
    joint_scale: 0.28
    constant_speed_mode: false
    gripper_speed: 2.00

    # Optional MoveGroup planned joystick mode.
    # When joystick_control_mode:=move_group, cartesian mode sends small end-effector pose targets through
    # /move_action, so MoveIt uses the same planning, joint limits, collision
    # checking, and trajectory execution path as RViz Plan + Execute.
    cartesian_step_m: 0.025
    angular_step_rad: 0.10
    cartesian_directions: [1.0, 1.0, 1.0, 1.0, 1.0, 1.0]
    position_goal_tolerance: 0.015
    orientation_goal_tolerance: 0.15

    # Set move_group_control_mode: "joint" to use planned joint nudges instead.
    joint_names: ["joint1", "joint2", "joint3", "joint4", "joint5", "joint6"]
    # REBEL-6DOF-03 factory software limits (179, 80/140, 80/140,
    # 179, 95, 179 degrees). Keep these synchronized with the URDF and MoveIt.
    joint_min_positions: [-3.12413936106985, -1.3962634015954636, -1.3962634015954636, -3.12413936106985, -1.6580627893946132, -3.12413936106985]
    joint_max_positions: [3.12413936106985, 2.443460952792061, 2.443460952792061, 3.12413936106985, 1.6580627893946132, 3.12413936106985]
    joint_directions: [1.0, 1.0, 1.0, 1.0, 1.0, 1.0]
    joint_step_rad: 0.07
    joint_limit_margin: 0.05
    joint_goal_tolerance: 0.025
    allowed_planning_time: 2.0
    num_planning_attempts: 5
    velocity_scale: 0.35
    acceleration_scale: 0.35
    command_period_sec: 0.20
    success_cooldown_sec: 0.05
    failure_cooldown_sec: 0.80
    status_period_sec: 1.0

    gripper_open_position: -1.57
    gripper_closed_position: 0.07
    gripper_trajectory_duration: 0.10
    max_gripper_command_step: 0.04
    deadzone: 0.04
    command_publish_rate_hz: 80.0
    joy_timeout_sec: 0.35
    stop_publish_duration: 0.0
    stop_ramp_steps: 10
    publish_zero_when_disabled: false

    # Arm mapping:
    # Hold RB/button 5   = Cartesian movement (also the arm/gripper enable)
    # Hold RT/axis 5     = direct joint jog   (also the arm/gripper enable)
    # The two are independent holds, not a toggle. Release both to stop the arm.
    # Holding RB and RT together gives Cartesian: RB wins, so brushing the
    # trigger mid-move cannot silently change what the sticks do.
    # LB/button 4 belongs to rover and blocks arm output
    # Hold X/button 2 = manual gripper open; hold B/button 1 = manual gripper close
    # Hold RB + Y/button 3 = real-arm physical hand guiding (ZeroTorque)
    # Hold LT + press Y/button 3 = planned move to pick_home
    # Hold LT + press A/button 0 = planned move to probe_drop
    # Hold LT + press B/button 1 = planned move to soil_drop
    button_enable: 5
    button_rover_enable: 4

    # RT is an analog axis on every driver here — no gamepad in this stack
    # reports a trigger as a button — so it needs a press threshold.
    # joy_layout_normalizer republishes canonical axes 2 (LT) and 5 (RT) as
    # 0.0 released -> 1.0 fully pressed regardless of driver, so these are
    # press fractions. Release is lower than press for hysteresis.
    axis_joint_enable: 5
    axis_joint_enable_threshold: 0.5
    axis_joint_enable_release: 0.35

    # Legacy escape hatch: true restores the old single-button behaviour where
    # button_arm_mode_toggle flips Cartesian <-> joint and RB alone is the gate.
    # RT is ignored in that mode.
    arm_toggle_mode: false
    button_arm_mode_toggle: 5

    button_gripper_open: 2
    button_gripper_close: 1
    button_gripper_toggle: 0

    # arm_preset_pose_joystick: LT (canonical axis 2, 0.0 released -> 1.0
    # pressed) plus a face button sends a planned move to a named joint preset.
    #   LT + Y/button 3 -> pick_home
    #   LT + A/button 0 -> probe_drop
    #   LT + B/button 1 -> soil_drop
    # No face button is taken with LT held: RB + Y is hand guiding, A is
    # button_gripper_toggle and B is button_gripper_close, but the teleop node
    # only reads the gripper buttons after its arm_enabled gate (RB or RT held)
    # and the preset node refuses to fire in exactly that case. The two sets
    # never overlap.
    #
    # preset_joint_positions_flat is row-major, one row of preset_joint_names
    # per entry in preset_pose_names. Rows must stay in step with the SRDF
    # group states of the same names (and pick_home with vision_grasp_node's
    # pick_home_joint_positions).
    preset_modifier_axis: 2
    preset_modifier_threshold: 0.5
    preset_modifier_release: 0.35
    preset_buttons: [3, 0, 1]
    preset_pose_names: ["pick_home", "probe_drop", "soil_drop"]
    preset_joint_names: ["joint1", "joint2", "joint3", "joint4", "joint5", "joint6"]
    preset_joint_positions_flat: [
      0.0,     0.366519,  1.18682, 0.0349066,  1.55334, 1.50098,
      1.81514, -1.18682,  1.97222, 0.0349066,  1.51844, 1.58825,
      1.29154, -0.331613, 1.8326,  -0.0698132, 1.53589, 2.84489,
    ]
    preset_velocity_scale: 0.25
    preset_acceleration_scale: 0.25
    preset_status_topic: "/arm_preset_pose/status"
    # MoveIt collision-plans presets; the active ros2_control action executes
    # them without entering MoveIt's shared trajectory-execution manager.
    arm_controller_action_name: "/rebel_arm_trajectory_controller/follow_joint_trajectory"
    arm_controller_status_topic: "/rebel_arm_trajectory_controller/follow_joint_trajectory/_action/status"

    # --- Cartesian stick mapping: SET BY cartesian_frame, NOT HERE ----------
    # Canonical axes out of joy_layout_normalizer: 0/1 = left stick X/Y,
    # 3/4 = right stick X/Y, 2/5 = triggers, 6/7 = D-pad. On both sticks the
    # horizontal axis is the lower index (0, 3) and the vertical the higher
    # (1, 4); ROS joy reports up and LEFT as +1.
    #
    # A pairing that reads correctly in one frame is wrong in the other, so
    # both nodes pick the mapping from cartesian_frame above and the keys are
    # left unset here. Change the frame and the sticks follow it:
    #
    #   cartesian_frame: "tool"  (both sticks transposed; the axes are the
    #                             GRIPPER's)
    #     left stick left/right  (0) -> tool X translate
    #     left stick up/down     (1) -> tool Y translate
    #     D-pad up/down          (7) -> tool Z translate, the approach in and
    #                                   out of the jaws
    #     right stick up/down    (4) -> rotate about tool X
    #     right stick left/right (3) -> rotate about tool Y
    #     D-pad left/right       (6) -> rotate about tool Z
    #
    #   cartesian_frame: "base"  (the pre-2026-08-31 layout, unchanged; the
    #                             axes are the ROVER's)
    #     left stick up/down     (1) -> base X translate, rover forward/back
    #     left stick left/right  (0) -> base Y translate, rover left/right
    #     D-pad up/down          (7) -> base Z translate, world up/down
    #     right stick left/right (3) -> rotate about base X
    #     right stick up/down    (4) -> rotate about base Y
    #     D-pad left/right       (6) -> rotate about base Z
    #
    # Uncommenting any of the six keys below PINS that axis in both frames and
    # takes it out of the switch. Do that only to override one axis; if an axis
    # merely runs backwards, flip its sign in cartesian_directions above
    # instead — that is a sign, not a pairing.
    #
    # axis_linear_x: 0
    # axis_linear_y: 1
    # axis_linear_z: 7
    # axis_angular_x: 4
    # axis_angular_y: 3
    # axis_angular_z: 6

    axis_joint1: 0
    axis_joint2: 1
    axis_joint3: 4
    axis_joint4: 3
    axis_joint5: 6
    axis_joint6: 7
    trajectory_horizon_sec: 0.025
    stop_ramp_duration_sec: 0.06
    arm_command_topic: "rebel_arm_trajectory_controller/joint_trajectory"
    twist_command_topic: "/delta_twist_cmds"
    cartesian_linear_scale: 0.10
    cartesian_angular_scale: 0.18
    cartesian_release_deadzone: 0.04
    cartesian_stop_ramp_duration_sec: 0.0
    cartesian_hard_stop_cycles: 3
    servo_pause_service: "/servo_node/pause_servo"
    max_joint_velocity: 0.28
    max_joint_accel: 1.8
    max_joint_decel: 16.0
    joint_velocity_deadband: 0.004
    dls_lambda: 0.10
    trajectory_preview_sec: 0.025
    hold_time_sec: 0.030
    stop_hold_cycles: 2
    collision_preview_sec: 0.16
    velocity_point_1_sec: 0.040
    velocity_point_2_sec: 0.080
    stop_zero_cycles: 4
