shreyaspatel3010/aries/src/aries_moveit/moveit_config/launch/gripper_hardware.launch.py

from pathlib import Path

from launch import LaunchDescription
from launch_ros.actions import Node
from launch.substitutions import Command, FindExecutable, LaunchConfiguration, PathJoinSubstitution, PythonExpression
from launch_ros.substitutions import FindPackageShare
from launch.actions import DeclareLaunchArgument, RegisterEventHandler, IncludeLaunchDescription
from launch.conditions import IfCondition
from launch.event_handlers import OnProcessExit
from launch.launch_description_sources import PythonLaunchDescriptionSource
from launch_ros.parameter_descriptions import ParameterValue
from ament_index_python.packages import get_package_share_directory
from launch_param_builder import load_yaml
from moveit_configs_utils import MoveItConfigsBuilder
import glob
import os

from aries_common.devices import device_str


def default_teensy_device():
    """Whichever Teensy is plugged in, not the one we happened to own first.

    The board ID is part of the by-id path, so a swapped board silently points
    micro_ros_agent at a device that no longer exists. See the same fallback in
    aries_hardware.launch.py.
    """
    found = sorted(glob.glob("/dev/serial/by-id/*Teensy*-if00"))
    return found[0] if found else device_str("gripper.serial_port")


def generate_launch_description():
    # Declare launch arguments
    arm_hardware_protocol_arg = DeclareLaunchArgument(
        "arm_hardware_protocol",
        default_value="mock_hardware",
        description="Hardware protocol for the arm in this launch"
    )

    gripper_type_arg = DeclareLaunchArgument(
        'gripper_type',
        default_value='st3215',
        choices=['st3215'],
        description='Which gripper URDF to load. Only "st3215" exists; v2 '
                    'and the older four-bars are retired to aries/urdf/legacy/.'
    )

    finger_type_arg = DeclareLaunchArgument(
        'finger_type',
        default_value='bucket',
        choices=['bucket', 'maintenance'],
        description='Swappable fingertip: "bucket" (scoops) or "maintenance" (flat jaws); must match what is bolted on'
    )
    
    use_gui_arg = DeclareLaunchArgument(
        'use_gui', 
        default_value='true', 
        description='Launch RViz with MoveIt interface'
    )

    use_gripper_overlay_arg = DeclareLaunchArgument(
        'use_gripper_overlay',
        default_value='true',
        choices=['true', 'false'],
        description='Publish the live ST3215 telemetry panel on '
                    '/gripper_status_markers. Independent of use_gui: the RViz '
                    'that draws it can be on another machine.'
    )

    micro_ros_device_arg = DeclareLaunchArgument(
        'micro_ros_device',
        default_value=default_teensy_device(),
        description='USB-serial device for the micro-ROS agent (Teensy)'
    )
    
    # Get paths
    current_file_dir = os.path.dirname(os.path.realpath(__file__))
    aries_moveit_dir = os.path.dirname(current_file_dir)
    moveit_config_dir = os.path.join(aries_moveit_dir, "config")
    controller_config_path = os.path.join(moveit_config_dir, "ros2_controllers.yaml")
    
    # URDF files are in the aries package
    aries_pkg = get_package_share_directory("aries")
    arm_hardware_protocol = LaunchConfiguration('arm_hardware_protocol')
    gripper_type = LaunchConfiguration('gripper_type')
    finger_type = LaunchConfiguration('finger_type')
    micro_ros_device = LaunchConfiguration('micro_ros_device')

    robot_description_content = ParameterValue(
        Command([
            FindExecutable(name='xacro'), ' ',
            PathJoinSubstitution([
                FindPackageShare("aries"), "urdf", "my_robot.urdf.xacro"
            ]),
            ' ',
            'hardware_protocol:=mock_hardware',
            ' ',
            'arm_hardware_protocol:=', arm_hardware_protocol,
            ' ',
            'gripper_hardware_protocol:=rebel',
            ' ',
            'gripper_type:=', gripper_type,
            ' ',
            'finger_type:=', finger_type,
        ]),
        value_type=str
    )

    robot_description = {'robot_description': robot_description_content}
    
    # Robot semantic description (SRDF)
    # aries.srdf is XACRO, not plain text: it carries both grippers' link sets
    # and gates them on gripper_type. `cat` here yields a semantic model with
    # the other gripper's links in it, which srdfdom reports as Errors, and
    # with the xacro tags left in as unknown elements.
    robot_description_semantic_content = Command([
        FindExecutable(name='xacro'), ' ',
        os.path.join(moveit_config_dir, 'aries.srdf'),
        ' gripper_type:=', gripper_type,
    ])
    robot_description_semantic = {
        'robot_description_semantic': ParameterValue(robot_description_semantic_content, value_type=str)
    }
    
    kinematics_yaml = {
        'robot_description_kinematics': load_yaml(Path(os.path.join(moveit_config_dir, 'kinematics.yaml')))
    }
    
    # OMPL Planning configuration - load as dict, not as params-file
    import yaml as _yaml
    with open(os.path.join(moveit_config_dir, 'ompl_planning.yaml')) as f:
        ompl_config = _yaml.safe_load(f)
    
    # If the yaml has a 'move_group' top-level wrapper, unwrap it and merge with sibling keys
    if 'move_group' in ompl_config:
        move_group_block = ompl_config.pop('move_group')
        ompl_config.update(move_group_block)

    # MoveIt2 Jazzy expects: planning_pipelines=['ompl'], default_planning_pipeline='ompl',
    # and pipeline config nested under 'ompl' key
    ompl_planning_yaml = {
        'planning_pipelines': ['ompl'],
        'default_planning_pipeline': 'ompl',
        'ompl': ompl_config,
    }
    
    joint_limits_yaml = {
        'robot_description_planning': load_yaml(Path(os.path.join(moveit_config_dir, 'joint_limits.yaml')))
    }
    
    moveit_controllers = {
        'moveit_controller_manager': 'moveit_simple_controller_manager/MoveItSimpleControllerManager',
        'moveit_simple_controller_manager': load_yaml(Path(os.path.join(moveit_config_dir, 'moveit_controllers.yaml'))),
    }

    # ros2_control node
    ros2_control_node = Node(
        package="controller_manager",
        executable="ros2_control_node",
        parameters=[
            robot_description,
            controller_config_path
        ],
        output="both",
    )
    
    # Robot state publisher
    robot_state_pub_node = Node(
        package="robot_state_publisher",
        executable="robot_state_publisher",
        parameters=[robot_description],
        output="both",
    )

    # Publish static rover wheel/rocker joints so MoveIt has a complete state.
    wheel_joint_publisher_node = Node(
        package='aries_moveit',
        executable='publish_wheel_joints.py',
        name='wheel_joint_publisher',
        output='screen',
    )

    # Joint state broadcaster spawner
    joint_state_broadcaster_spawner = Node(
        package="controller_manager",
        executable="spawner",
        arguments=["joint_state_broadcaster", "--controller-manager", "/controller_manager"],
        output="both",
    )
    
    # Arm and gripper controller spawners
    arm_controller_spawner = Node(
        package="controller_manager",
        executable="spawner",
        arguments=["rebel_arm_trajectory_controller", "--controller-manager", "/controller_manager"],
        output="both",
    )

    # Gripper controller spawner (spawned after arm controller)
    gripper_controller_spawner = Node(
        package="controller_manager",
        executable="spawner",
        arguments=["rebel_gripper_controller", "--controller-manager", "/controller_manager"],
        output="both",
    )
    
    # Spawn arm controller after joint_state_broadcaster
    delay_arm_spawner = RegisterEventHandler(
        event_handler=OnProcessExit(
            target_action=joint_state_broadcaster_spawner,
            on_exit=[arm_controller_spawner],
        )
    )

    # Spawn gripper controller after arm controller
    delay_gripper_spawner = RegisterEventHandler(
        event_handler=OnProcessExit(
            target_action=arm_controller_spawner,
            on_exit=[gripper_controller_spawner],
        )
    )
    
    # MoveGroup node for planning
    move_group_node = Node(
        package="moveit_ros_move_group",
        executable="move_group",
        output="screen",
        parameters=[
            robot_description,
            robot_description_semantic,
            kinematics_yaml,
            ompl_planning_yaml,
            moveit_controllers,
            joint_limits_yaml,
            {
                'use_sim_time': False,
                'publish_robot_description_semantic': True,
                'publish_planning_scene': True,
                'publish_geometry_updates': True,
                'publish_state_updates': True,
                'publish_transforms_updates': True,
                'planning_scene_monitor.publish_planning_scene': True,
                'planning_scene_monitor.publish_geometry_updates': True,
                'planning_scene_monitor.publish_state_updates': True,
                'planning_scene_monitor.publish_transforms_updates': True,
                'trajectory_execution.allowed_execution_duration_scaling': 1.2,
                'trajectory_execution.allowed_goal_duration_margin': 0.5,
                'trajectory_execution.allowed_start_tolerance': 0.03,
            }
        ],
    )
    
    # RViz node with MoveIt interface
    rviz_config_file = PathJoinSubstitution([
        FindPackageShare("aries_moveit"), "config", "gripper.rviz"
    ])
    
    rviz_node = Node(
        package="rviz2",
        executable="rviz2",
        name="rviz2",
        output="log",
        arguments=["-d", rviz_config_file],
        parameters=[
            robot_description,
            robot_description_semantic,
            kinematics_yaml,
        ],
        condition=IfCondition(LaunchConfiguration('use_gui'))
    )
    
    # Gripper arc overlay for RViz (aries_moveit/scripts/gripper_arc_visualizer.py)
    # is not launched. Its geometry tables model the 85.563 mm four-bar of the
    # retired gripper_new only; on v2 (50 mm parallelogram, 83 mm stroke) the
    # sweep it draws is wrong by 100 mm. It used to be gated on
    # gripper_type == 'new', which no longer exists. Re-fit the tables to v2
    # before adding the node back.

    # Live servo telemetry as an RViz text overlay above the gripper: jaw gap,
    # joint, TCP, current, voltage, temperature, and whether the servo is near
    # or past one of its own protection limits. It renders whatever the
    # hardware component publishes on /diagnostics and carries no geometry, so
    # unlike the arc overlay above it needs no per-gripper tables; on a mock
    # gripper it says NO TELEMETRY.
    gripper_status_overlay_node = Node(
        condition=IfCondition(LaunchConfiguration('use_gripper_overlay')),
        package="aries_moveit",
        executable="gripper_status_overlay.py",
        name="gripper_status_overlay",
        output="screen",
    )

    # micro-ROS agent: bridges Teensy USB serial to ROS 2 topics
    micro_ros_agent_node = Node(
        package='micro_ros_agent',
        executable='micro_ros_agent',
        name='micro_ros_agent',
        # 115200, not 6000000 — see the note in aries_hardware.launch.py. Linux
        # tops out at B4000000 (== 4111); 6000000 is rejected by cfsetospeed
        # with EINVAL and the agent ignores the error, leaving the port speed
        # unset. Baud is ignored by the Teensy's USB CDC link regardless.
        arguments=['serial', '--dev', micro_ros_device, '-b', '115200'],
        output='screen',
    )

    return LaunchDescription([
        arm_hardware_protocol_arg,
        gripper_type_arg,
        finger_type_arg,
        use_gui_arg,
        use_gripper_overlay_arg,
        micro_ros_device_arg,
        micro_ros_agent_node,
        ros2_control_node,
        robot_state_pub_node,
        wheel_joint_publisher_node,
        joint_state_broadcaster_spawner,
        delay_arm_spawner,
        delay_gripper_spawner,
        move_group_node,
        gripper_status_overlay_node,
        rviz_node,
    ])
