shreyaspatel3010/aries/src/aries_bringup/nodes/full_hardware_checker.py

#!/usr/bin/env python3
"""
ARIES Full Hardware Status Checker Node

Style intentionally matches aries_bringup/nodes/hardware_checker.py.

Checks:
  • Arm TCP hardware reachability
  • Arm controller/joint-state activity
  • Gripper serial or mock fallback
  • Rover CAN / ODrive axes
  • Rover MicroStrain 3DM-GX5-AHRS, when forced or auto-detected
  • Mock rover fallback heartbeat
  • Joystick /joy
  • RealSense USB device count, and the colour stream of ALL THREE cameras the
    bringup can start: the wrist "gripper_camera", the front "rover_camera",
    and the rear "rear_camera" (a Logitech Brio watching the drill, which is
    not a RealSense and so is not in that device count)

Manual check:
  ros2 service call /check_full_hardware std_srvs/srv/Trigger
"""

import glob
import os
import socket
from pathlib import Path

import rclpy
from ament_index_python.packages import PackageNotFoundError, get_package_share_directory
from geometry_msgs.msg import Twist
from rcl_interfaces.msg import ParameterDescriptor
from rclpy.node import Node
from rclpy.qos import QoSProfile, ReliabilityPolicy, HistoryPolicy, DurabilityPolicy
from sensor_msgs.msg import Image, Imu, Joy, JointState
from std_msgs.msg import String
from std_srvs.srv import Trigger

from aries_common.detect import can_link_state, describe_can_link
from aries_common.devices import device
from aries_common.odrive_errors import format_odrive_error

try:
    from odrive_can.msg import ControllerStatus, ODriveStatus
except Exception:
    ControllerStatus = None
    ODriveStatus = None


# ── ODrive axis_state values ─────────────────────────────────────────────────
AXIS_STATE_NAMES = {
    0: "UNDEFINED",
    1: "IDLE",
    2: "STARTUP_SEQ",
    3: "FULL_CALIBRATION",
    4: "MOTOR_CALIBRATION",
    6: "ENCODER_OFFSET_CAL",
    7: "ENCODER_INDEX_SEARCH",
    8: "CLOSED_LOOP",
    9: "LOCKIN_SPIN",
    10: "ENCODER_DIR_FIND",
    11: "HOMING",
    12: "ENCODER_HALL_PHASE_CAL",
    13: "ENCODER_HALL_POLARITY_CAL",
}
CLOSED_LOOP = 8

# CAN node id -> physical wheel, re-identified by arming one axis at a time on
# 2026-08-24. Keep in step with right_wheels/left_wheels in
# aries_drive/config/cmd_vel_odrive_bridge.yaml.
AXIS_LABELS = {
    0: "Left-Front ",
    1: "Left-Mid   ",
    2: "Left-Rear  ",
    3: "Right-Rear ",
    4: "Right-Mid  ",
    5: "Right-Front",
}
NUM_AXES = 6


def _as_bool(value) -> bool:
    if isinstance(value, str):
        return value.strip().lower() in ("1", "true", "yes", "on")
    return bool(value)


def _as_list(value):
    if isinstance(value, str):
        return [item.strip() for item in value.split(",") if item.strip()]
    return list(value)


class FullHardwareChecker(Node):
    def __init__(self):
        super().__init__("full_hardware_checker")

        # ── ANSI colours, same style as rover hardware_checker.py ─────────────
        self.GREEN  = "\033[92m"
        self.RED    = "\033[91m"
        self.YELLOW = "\033[93m"
        self.BLUE   = "\033[94m"
        self.CYAN   = "\033[96m"
        self.RESET  = "\033[0m"
        self.BOLD   = "\033[1m"
        self.GREY   = "\033[90m"

        # ── Parameters ────────────────────────────────────────────────────────
        self.declare_parameter("check_interval", 3.0)
        self.declare_parameter("timeout", 5.0)
        self.declare_parameter("print_only_on_change", True)

        self.declare_parameter("check_arm", True)
        self.declare_parameter("check_gripper", True)
        self.declare_parameter("check_rover", True)
        self.declare_parameter("check_imu", True)
        self.declare_parameter("check_joystick", True)
        self.declare_parameter("check_realsense", True)
        self.declare_parameter("check_mock_fallbacks", True)

        self.declare_parameter("require_all_rover_axes", True)
        self.declare_parameter("require_closed_loop", True)
        self.declare_parameter("check_odrive_status", True)

        # Defaults come from aries_common/config/devices.yaml so a checker run
        # bare, with no launch file feeding it, still probes the real hardware.
        self.declare_parameter("arm_host", device("arm.host"))
        self.declare_parameter("arm_port", int(device("arm.port")))
        self.declare_parameter("arm_socket_timeout", 0.25)
        self.declare_parameter("arm_joint_names", ["joint1", "joint2", "joint3", "joint4", "joint5", "joint6"])

        self.declare_parameter("gripper_serial_port", device("gripper.serial_port"))
        # WHICH GRIPPER IS FITTED, because the two are on different wires: v2's
        # servo is behind the Teensy, the ST3215 is on its own USB bus-servo
        # adapter. Checking the Teensy while the ST3215 gripper is fitted is
        # not a near miss - it is a green row for a device this gripper does
        # not use, next to a silent one for the device it does.
        self.declare_parameter("gripper_type", "v2")
        self.declare_parameter("servo_bus_port", device("servo_bus.port"))
        self.declare_parameter("can_interface", device("rover.can_interface"))
        self.declare_parameter("use_imu", "auto")
        self.declare_parameter("imu_port", device("imu.port"))
        self.declare_parameter("imu_topic", "/microstrain/imu/data")
        self.declare_parameter("imu_frame", "imu_frame")
        self.declare_parameter("expected_odrive_axes", 6)
        # The rover carries THREE cameras and aries_hardware.launch.py starts a
        # driver for each: camera_name "gripper_camera" on the wrist,
        # "rover_camera" at the front, and "rear_camera" under the tail.
        # Checking only the wrist one reported a single-camera robot, and a
        # front camera that never came up looked exactly like a healthy one.
        #
        # One scalar pair per camera rather than parallel arrays: a launch file
        # cannot pass a substitution-valued string array (the substitutions are
        # concatenated into a single string), and these two are the cameras the
        # robot has.
        self.declare_parameter("gripper_camera_color_topic",
                               "/gripper_camera/color/image_raw")
        self.declare_parameter("front_camera_color_topic",
                               "/rover_camera/color/image_raw")
        # The third camera is NOT a RealSense: a Logitech Brio under the tail
        # aimed at the drill, driven by usb_cam. Two consequences, both of
        # which the code below has to respect. Its topic has no /color/
        # segment, because usb_cam does not add one. And it does not appear in
        # the RealSense USB device count, so it must not be counted against it
        # -- a rear camera streaming happily would otherwise mask a D435i that
        # is plugged in and not streaming, which is the exact fault that count
        # exists to catch.
        self.declare_parameter("rear_camera_color_topic", "/rear_camera/image_raw")
        # Mirrors aries_hardware.launch.py's enable_depth_sensor /
        # enable_front_camera: "auto" reports the camera but never calls it an
        # error, "true" means it was explicitly asked for so a missing one is
        # flagged, "false" drops the row.
        #
        # Dynamically typed because these read as tri-state text but two of the
        # three values look boolean: `-p front_camera_mode:=false` arrives as a
        # BOOL and would be rejected against a declared string, taking the whole
        # checker down over a debugging flag. `_camera_config` normalises it.
        tri_state = ParameterDescriptor(dynamic_typing=True)
        self.declare_parameter("gripper_camera_mode", "auto", tri_state)
        self.declare_parameter("front_camera_mode", "auto", tri_state)
        self.declare_parameter("rear_camera_mode", "auto", tri_state)

        check_interval = float(self.get_parameter("check_interval").value)
        self.timeout = float(self.get_parameter("timeout").value)
        self.print_only_on_change = _as_bool(self.get_parameter("print_only_on_change").value)

        self.check_arm = _as_bool(self.get_parameter("check_arm").value)
        self.check_gripper = _as_bool(self.get_parameter("check_gripper").value)
        self.check_rover = _as_bool(self.get_parameter("check_rover").value)
        self.check_imu = _as_bool(self.get_parameter("check_imu").value)
        self.check_joystick = _as_bool(self.get_parameter("check_joystick").value)
        self.check_realsense = _as_bool(self.get_parameter("check_realsense").value)
        self.check_mock_fallbacks = _as_bool(self.get_parameter("check_mock_fallbacks").value)

        self.require_all_rover_axes = _as_bool(self.get_parameter("require_all_rover_axes").value)
        self.require_closed_loop = _as_bool(self.get_parameter("require_closed_loop").value)
        self.check_odrive_status = _as_bool(self.get_parameter("check_odrive_status").value)

        self.arm_host = str(self.get_parameter("arm_host").value)
        self.arm_port = int(self.get_parameter("arm_port").value)
        self.arm_socket_timeout = float(self.get_parameter("arm_socket_timeout").value)
        self.arm_joint_names = _as_list(self.get_parameter("arm_joint_names").value)
        self.gripper_serial_port = str(self.get_parameter("gripper_serial_port").value)
        self.gripper_type = str(self.get_parameter("gripper_type").value)
        self.servo_bus_port = str(self.get_parameter("servo_bus_port").value)
        self.can_interface = str(self.get_parameter("can_interface").value)
        self.use_imu = str(self.get_parameter("use_imu").value).strip().lower()
        self.imu_port = str(self.get_parameter("imu_port").value)
        self.imu_topic = str(self.get_parameter("imu_topic").value)
        self.imu_frame = str(self.get_parameter("imu_frame").value)
        self.expected_odrive_axes = int(self.get_parameter("expected_odrive_axes").value)
        self.cameras = self._camera_config()

        # ── State memory ──────────────────────────────────────────────────────
        self.ctrl_times  = [None] * NUM_AXES
        self.ctrl_states = [None] * NUM_AXES
        self.ctrl_errors = [None] * NUM_AXES
        self.ctrl_vel    = [None] * NUM_AXES

        self.odrv_times   = [None] * NUM_AXES
        self.odrv_voltage = [None] * NUM_AXES
        self.odrv_errors  = [None] * NUM_AXES

        self.joy_time = None
        self.joint_state_time = None
        self.joint_names = set()
        self.joint_times = {}
        self.mock_rover_time = None
        self.cmd_vel_time = None
        self.arm_joystick_time = None
        self.arm_joystick_status = "waiting for arm joystick status"
        self.camera_times = {camera["topic"]: None for camera in self.cameras}
        self.imu_time = None
        self.imu_frame_id = ""

        self.prev_snapshot = None
        self.initial_check_done = False
        self.manual_check_requested = False

        # ── QoS, same idea as hardware_checker.py ─────────────────────────────
        reliable_qos = QoSProfile(
            reliability=ReliabilityPolicy.RELIABLE,
            history=HistoryPolicy.KEEP_LAST,
            durability=DurabilityPolicy.VOLATILE,
            depth=1,
        )
        sensor_qos = QoSProfile(
            reliability=ReliabilityPolicy.BEST_EFFORT,
            history=HistoryPolicy.KEEP_LAST,
            durability=DurabilityPolicy.VOLATILE,
            depth=1,
        )
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
